rudolfstepan/6502-sbc-fpga/boards/tang_mega_138k/system16/linux/README.md

# System16 GoRV32 Plus Linux

This directory contains the software side of the hardware-verified Linux 6.12.95
port for the Tang Console 138K System16 project. Linux runs on hart 0 of the
Gowin GoRV32 Plus core; hart 1 remains parked in the ZSBL.

There are three deliberately separate profiles:

| Profile | Userspace/root | Board SD driver | Status |
| --- | --- | --- | --- |
| `flash` | embedded BusyBox initramfs | no | hardware verified |
| `rescue` | embedded BusyBox initramfs | read-only, auto-calibrating; isolated probe-time scratch test | read path hardware verified; CMD24 scratch test pending hardware verification |
| `sd` | 512 MiB ext2 at physical LBA 32768 | read-only, auto-calibrating | experimental external-root profile |

The SD image can contain GNU make, binutils and a native GCC, and that image is
covered by the QEMU test. The current hardware driver still exposes
`/dev/gorv32sd` read-only. Only the rescue DTB enables one tightly scoped
probe-time CMD24 test at physical LBA 16384; it does not enable block-device or
filesystem writes. The rescue profile deliberately omits ext2 support so it
cannot mount the card; the separate `sd` profile retains ext2. Do not describe
this profile as writable until the write path and filesystem integrity tests
pass.
The complete build procedure is in [linux-build-image.md](linux-build-image.md).
For adding a new MMIO peripheral, coprocessor or Linux platform driver, see
[hardware-treiber-entwicklung.md](hardware-treiber-entwicklung.md).

## PS/2 keyboard

The Linux FPGA build exposes a PS/2 Set-2 keyboard receiver at MMIO address
`0xe8800100`. Connect the keyboard through the Tang Console PMOD1 header:

| Signal | PMOD1 | FPGA pin |
| --- | --- | --- |
| PS/2 clock | `IO0` | `W19` |
| PS/2 data | `IO1` | `W20` |
| Keyboard supply | `+5V` | external 5 V |
| Ground | `GND` | common ground |

Clock and data are open-collector inputs with FPGA pull-ups to 3.3 V. Do not
apply a push-pull 5 V signal to either FPGA pin. A PS/2 socket or adapter must
power the keyboard from 5 V while keeping clock/data open-collector; use a
proper open-drain level shifter if the adapter contains active 5 V logic.

The hardware profiles compile a German QWERTZ, no-dead-keys map into the Linux
VT layer. This changes only PS/2/USB keyboard input on the HDMI `tty1`; bytes
received from a serial terminal retain that terminal's own layout. BusyBox runs
independent gettys on `tty1` and `ttyS0`. Kernel output is still mirrored to
both consoles, but interactive input no longer passes through `conspy`, whose
polling caused visible keyboard latency and interrupted UART sessions.
The text-console driver restores Linux's CP437 Unicode map when it takes over
from the boot console. The existing hardware font therefore renders
`ÄÖÜäöüß`, section and degree signs at their CP437 glyph positions; no separate
font ROM or bitstream update is required for these characters.

## USB CDC development link

The GoRV32 Plus FPGA project contains a full-speed USB CDC ACM device on the
Tang Console USB-C device connector. Windows enumerates the hardware proof as
`33aa:0121`, serial `CDC138K002`, and binds it to `usbser.sys` as a virtual COM
port. The standalone loopback project first verified the pins, SoftPHY,
descriptor path and endpoint-2 transfer independently of Linux.

The System16 integration exposes endpoint 2 as a polling MMIO byte stream at
`0xe8800300`. This is the first hardware-bring-up layer; it deliberately does
not connect an unverified PLIC interrupt and is not yet registered as a Linux
TTY. Both directions use 512-byte asynchronous FIFOs. USB OUT packets become
visible only after a valid CRC indication, and USB IN data is retained until
the controller confirms successful transmission. IN packets are limited to
63 bytes to avoid Windows `usbser` waiting on an exact multiple of the
64-byte maximum packet size.

| Offset | Name | Access | Meaning |
| ---: | --- | --- | --- |
| `0x00` | `ID` | RO | `0x53313655` (`S16U`) |
| `0x04` | `CAPS` | RO | ABI `1.0`, RX/TX FIFO size as log2 |
| `0x08` | `STATUS` | RO | online, suspend, modem, FIFO and sticky error bits |
| `0x0c` | `RX_DATA` | RO | read and remove one received byte; zero if empty |
| `0x10` | `TX_DATA` | WO | enqueue the low byte; full FIFO sets overflow |
| `0x14` | `RX_LEVEL` | RO | received bytes available |
| `0x18` | `TX_LEVEL` | RO | used in bits 15:0, free in bits 31:16 |
| `0x1c` | `IRQ_STATUS` | RO/W1C | polling-visible event flags |
| `0x20` | `IRQ_ENABLE` | RW | event enable bits; hardware IRQ not connected yet |
| `0x24` | `CONTROL` | W1P | flush RX/TX, clear errors/events, IRQ test |
| `0x28` | `LINE_BAUD` | RO | host-selected CDC baud value |
| `0x2c` | `LINE_FORMAT` | RO | data bits, parity and stop bits |
| `0x30` | `MODEM` | RO | DTR and RTS |

After programming the System16 bitstream and booting Linux, the non-destructive
identity checks are:

```sh
devmem 0xe8800300 32
devmem 0xe8800304 32
devmem 0xe8800308 32
```

The first two reads must return `0x53313655` and `0x01000909`. To test Linux to
PC, open the new COM port and enqueue the ASCII byte `A`:

```sh
devmem 0xe8800310 8 0x41
```

For PC to Linux, send one byte from the COM terminal, verify that STATUS bit 4
or `RX_LEVEL` is nonzero, then pop it exactly once:

```sh
devmem 0xe8800314 32
devmem 0xe880030c 8
```

## Hardware boot capture

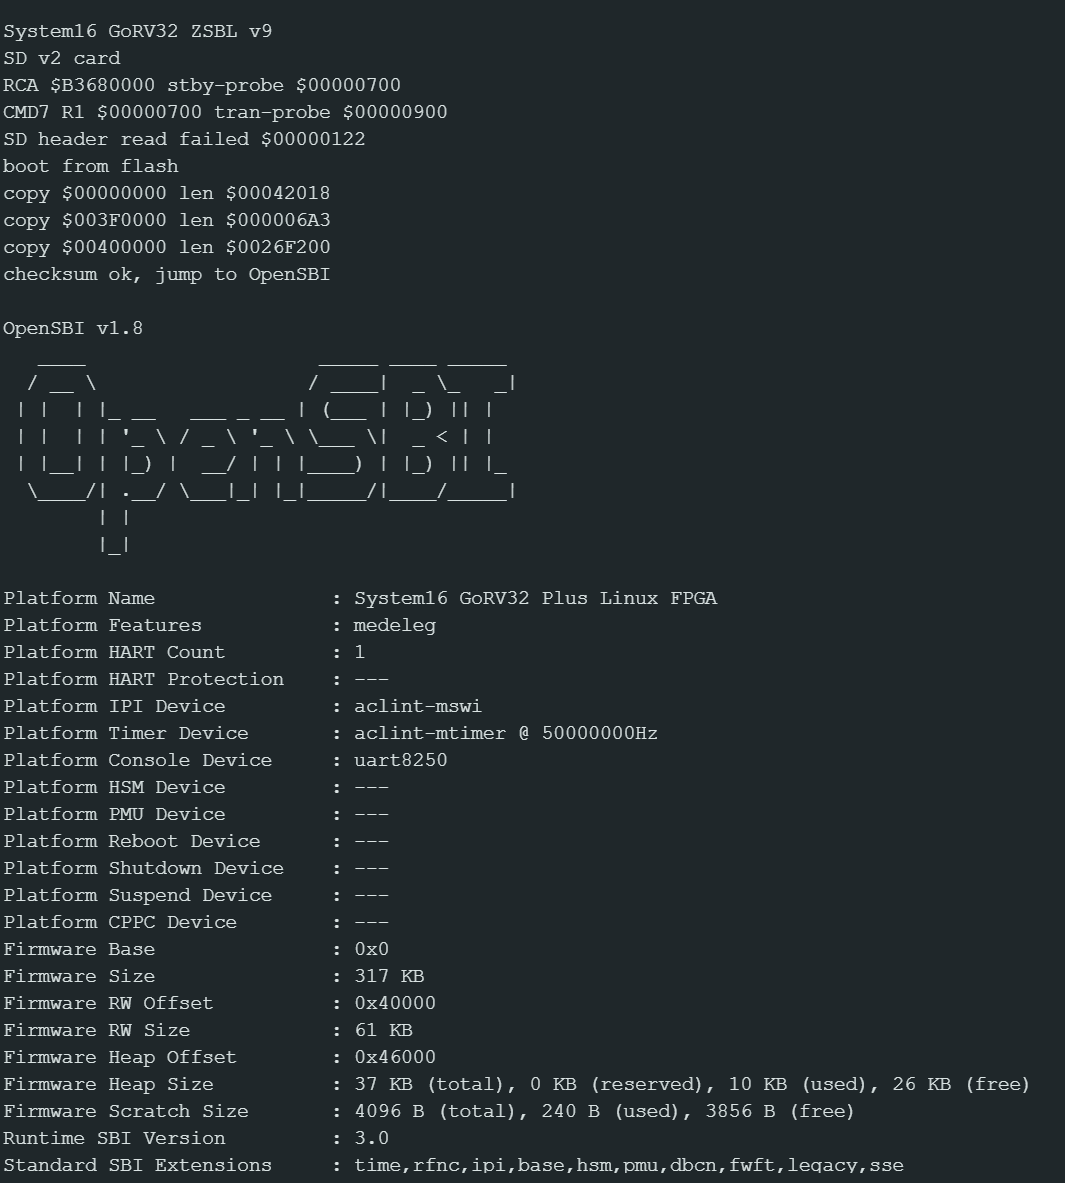
[picture p1: boards/tang_mega_138k/system16/linux/images/gorv32plus-opensbi-boot.png]
GoRV32 Plus ZSBL loading the GRV1 image from flash and starting OpenSBI


The capture shows the SD-first GRV1 copy layout and OpenSBI hand-off used by
the current ZSBL v12.

## Boot chain

1. The FPGA loads its bitstream from the board's 8 MB XT25F64B flash.
2. GoRV32 Plus resets at CPU address `0x80000000`. Its XIP window maps this
   address to flash offset `0x500000`, where the ZSBL executes in place.
3. ZSBL v12 initializes UART1 and first validates the GRV1 image at SD LBA 0.
   If the card or image is unavailable, it tries the fallback GRV1 container
   at flash offset `0x510000`.
4. The ZSBL copies OpenSBI, the DTB and Linux into SDRAM0, verifies the
   additive payload checksum and jumps to OpenSBI at address zero.
5. OpenSBI starts Linux at `0x00400000`. The `flash` and `rescue` profiles
   start their embedded BusyBox initramfs; the `sd` profile mounts
   `/dev/gorv32sd` read-only.

The GRV1 container is little-endian. It starts with a header containing the
magic, record count and checksum, followed by `(source offset, destination,
length)` records. Each payload begins on a 512-byte boundary so the SD path can
copy complete sectors directly into SDRAM. `tools/make_gorv32_flash_image.py`
is the authoritative format implementation.

## Address layout

| Space | Address | Contents |
| --- | ---: | --- |
| Flash | `0x000000` | FPGA bitstream, approximately 4.9 MB |
| Flash | `0x500000` | ZSBL; also the IP Core Generator `Flash_Burn_Address` |
| Flash | `0x510000` | Optional fallback GRV1 image |
| SD | LBA 0 | Primary raw GRV1 boot container |
| SD | LBA 16384 | Rescue-only CMD24 scratch sector in the unused gap |
| SD | LBA 32768 | SD profile's 512 MiB ext2 root filesystem |
| CPU XIP | `0x80000000` | ZSBL mapping of flash offset `0x500000` |
| SDRAM | `0x00000000` | OpenSBI (`FW_TEXT_START=0`) |
| SDRAM | `0x003f0000` | `gorv32plus.dtb` |
| SDRAM | `0x00400000` | Linux `Image`; initramfs in `flash`/`rescue` only |
| MMIO | `0xe4000000` | PLIC |
| MMIO | `0xe6000000` | CLINT |
| MMIO | `0xe8800100` | PS/2 keyboard registers |
| MMIO | `0xe8800300` | USB CDC endpoint-2 byte-stream registers |
| MMIO | `0xf0200020` | UART1 16550 register window |
| MMIO | `0xf0600000` | Vendor SD host |

Linux sees 1020 MiB from `0x00400000` through `0x3fffffff`. The lower 4 MiB
of the 1 GiB DDR3 are reserved for OpenSBI and the DTB. The optional flash
fallback slot has a stricter 2.9 MiB GRV1 size limit; SD boot is not restricted
by that flash boundary.

The UART uses 115200 baud, 8 data bits, no parity and one stop bit. Its APB
registers use 32-bit accesses and a four-byte stride. The small ZSBL SD reader
identifies cards at 200 kHz and transfers at 1 MHz, preferring four-bit
mode after ACMD6. This is independent of the Linux driver described below.

## Auto-calibrating Linux SD driver

`kernel/gorv32_sd.c` is a polling block driver for the vendor host at
`0xf0600000`. During probe it establishes a repeatable one-bit reference, then
tests all 50 combinations of one-/four-bit mode and dividers 0 through 24
(25 MHz down to 1 MHz). A candidate is rejected on a transfer failure, retry,
RX-FIFO-full event or byte mismatch. The three fastest short-run candidates
receive a 64-sector verification and the winner is checked once more before
the block device is registered. A later runtime retry or FIFO-full event halves
the clock automatically; runtime up-clocking is intentionally avoided.

Hardware result on 2026-07-12 with the current card and bitstream:

```text
auto calibration selected 1-bit divider 9 (2500000 Hz, 161 KiB/s); 29/50 sweep modes, 3 long-run modes passed
read benchmark: 16 sectors in 42 ms (190 KiB/s), 0 retries, 0 FIFO-full events
1048576 sectors at physical LBA 32768, 1-bit, native word order
```

The result is measured on every boot and is not hard-coded; another card can
select a different mode. Both board DTS files set `gowin,read-only`, so the
registered block device rejects writes. The rescue DTB additionally sets
`gowin,write-self-test-lba = <16384>`. At probe time the driver switches to
1-bit/1 MHz, reads the original sector and four sentinels twice, writes one test
pattern, reads it twice, restores the original with one CMD24, reads it twice
again and compares the sentinels. The sentinels are physical LBAs 0, 16383,
16385 and 32770. A CMD24 is never retried: a failed completion indication is
ambiguous, so the driver reinitializes and verifies instead of issuing the same
write again. Pass or fail, `/dev/gorv32sd` remains read-only.

## Source and generated files

- `gorv32plus.dts`, `gorv32plus-rescue.dts` and `gorv32plus-sd.dts` describe
  the three profiles.
- `system16-flash.config`, `system16-rescue.config` and `system16-sd.config`
  are their kernel fragments; `system16-qemu-sd.config` replaces the board
  host with virtio for the rootfs test.
- `kernel/gorv32_sd.c` is the built-in polling block driver for the SD profile.
- `build-kernel.sh` builds `flash`, `rescue`, `sd` or `qemu-sd` (`flash` is
  the default).
- `zsbl/crt.S`, `zsbl/main.c`, `zsbl/zsbl.lds` and `zsbl/build.sh` are the
  versioned freestanding XIP bootloader sources; `zsbl.bin` and `zsbl.elf` are
  generated from them and deliberately remain untracked.
- `../tools/build_rootfs_wsl.py` creates a static uClibc/BusyBox cpio with
  Buildroot 2025.02.
- `../tools/build_opensbi_gorv32_wsl.py` builds OpenSBI at address zero.
- `../tools/import_gorv32_from_wsl.py` validates and imports the WSL artifacts
  and compiles `gorv32plus.dts`.
- `../tools/build_rootfs_sd_wsl.py` creates the ext2/toolchain root filesystem.
- `buildroot/` is the versioned BR2_EXTERNAL tree for that filesystem.
- `../tools/make_gorv32_flash_image.py` creates a GRV1 boot container.
- `../tools/make_gorv32_sd_card_image.py` combines GRV1 and ext2.

Generated artifacts are intentionally not repository sources: Gowin `impl/`
output, `zsbl.bin`, `zsbl.elf`, the Linux build tree and `build/gorv32-linux-*`
can all be recreated. The Gowin IP's editable `.ipc` and synthesizable
encrypted `.v` are retained with the project, matching the policy used by the
other Gowin board ports.

## Build order

The Windows targets call the default WSL distribution. Commands below are run
from the repository root. Build the common boot firmware when it changes:

```powershell
make -C boards/tang_mega_138k/system16 gorv32-zsbl-wsl
make -C boards/tang_mega_138k/system16 gorv32-opensbi-wsl
```

The recommended driver-development loop is the rescue profile:

```powershell
make -C boards/tang_mega_138k/system16 rootfs-flash-wsl  # once
make -C boards/tang_mega_138k/system16 kernel-rescue-wsl
make -C boards/tang_mega_138k/system16 gorv32-rescue-image
```

Program only
`build/gorv32-linux-rescue/gorv32-linux-rescue.bin` at flash `0x510000` for
the normal fallback loop. The initramfs starts without SD, so a driver failure
cannot prevent access to the shell. No FPGA rebuild is needed.

For the CMD24 scratch test, however, SD-first selects a valid GRV1 at LBA 0
before the flash fallback. Therefore write the newly built rescue GRV1 raw at
SD LBA 0 as well. It is flash-sized and ends below LBA 8192; the scratch sector
at LBA 16384 and the ext2 root at LBA 32768 are outside that overlay. Before
CMD24, the driver also reads the actual GRV1 header twice and refuses the test
unless its canonical records leave the full 8192-sector guard. Perform
the first test only on a disposable or completely cloned card. Create a full
raw baseline after this deliberate rescue overlay, boot once, then read the
card again and compare the complete raw images byte-for-byte.

Provision the external-root card only for a new or changed root filesystem:

```powershell
make -C boards/tang_mega_138k/system16 rootfs-sd-wsl
make -C boards/tang_mega_138k/system16 kernel-sd-wsl
make -C boards/tang_mega_138k/system16 gorv32-sd-image
```

The SD root filesystem includes `/usr/bin/s16bench` for measuring the on-board
DDR3 main-memory backend. Its defaults use two 2 MiB buffers and eight passes;
Linux receives 1020 MiB (`0x00400000..0x3fffffff`) from the 1 GiB device:

```sh
s16bench
s16bench 1024 16       # optional: buffer size in KiB and pass count
```

It reports sequential write, read and `memcpy` throughput in KiB/s. Run the
same command after a memory-backend change and compare all three values.

This creates `build/gorv32-linux-sd/gorv32-linux-sd.img`. For later kernel,
DTB or driver iterations leave the card untouched and use:

```powershell
make -C boards/tang_mega_138k/system16 kernel-sd-wsl
make -C boards/tang_mega_138k/system16 gorv32-sd-boot-image
```

Write the resulting `gorv32-linux-sd-boot.bin` raw at SD LBA 0; this replaces
only the boot records before the ext2 filesystem. Use `qemu-sd-test` to
validate the Buildroot filesystem and native compiler through virtio; QEMU
does not exercise the Gowin SD host. See
[linux-build-image.md](linux-build-image.md) and
[gorv32-brennen.md](gorv32-brennen.md) for complete details.

## Expected console and diagnostics

The successful sequence starts with:

```text
FPGA BOOT OK
System16 GoRV32 ZSBL v12 SD-first
boot from SD
copy $00000000 len $...
copy $003F0000 len $...
copy $00400000 len $...
checksum ok, jump to OpenSBI
OpenSBI ...
[    0.000000] Linux version ...
[    0.000000] Machine model: System16 GoRV32 Plus Linux FPGA (rescue)
gorv32-sd f0600000.sdhost: auto calibration: testing ...
gorv32-sd f0600000.sdhost: auto calibration selected ...
gorv32-sd f0600000.sdhost: CMD24 scratch self-test at physical LBA 16384; root window stays read-only
gorv32-sd f0600000.sdhost: CMD24 scratch self-test PASS at physical LBA 16384; original restored
gorv32-sd f0600000.sdhost: read benchmark: ... 0 retries, 0 FIFO-full events
```

After initramfs startup, BusyBox supplies the minimal user space and shell.
`cat /sys/block/gorv32sd/ro` must print `1`; a PASS line does not authorize
general SD writes.
The HDMI top stripe is a coarse hardware diagnostic: red means no CPU UART or
DDR traffic, blue means DDR reads without UART, magenta means DDR writes
without UART, yellow means UART without DDR, cyan means UART plus reads, and
green means UART plus a DDR write. Green proves the chain through the ZSBL copy
loop, but the UART log remains the authoritative boot result.

## Known constraints

- Do not use flash offsets at or above `0x800000`: they exceed the physical
  8 MB device and can wrap over the bitstream.
- The GoRV32 Plus project must not include `VexRiscvSystem16.v`; the encrypted
  vendor core contains its own `VexRiscv` module.
- The vendor IP owns the QSPI and SD I/O buffers. Fabric logic must not also
  drive or probe those pads, or synthesis reports EX0339.
- OpenSBI 1.8.1 requires the local pre-MDT `fw_base.S` adjustment implemented
  by the build helper for this privilege-architecture implementation.
- The Linux SD device is read-only. CMD17 reads are hardware verified. The
  rescue-only LBA-16384 CMD24 save/test/restore sequence is an isolated
  integrity test; general writes and writable ext2/swap operation are not
  enabled.
- QEMU validates the generic RV32 kernel and early console, not the board's
  XIP, AXI-to-SDRAM bridge, SD host or UART wiring.
