rudolfstepan/6502-sbc-fpga/docs/03_BUILDING.md

# Building & Synthesis Guide

## System Requirements

### Software Dependencies

- **GHDL** (version 0.35+): VHDL simulator and analyzer
  - Windows: https://github.com/ghdl/ghdl/releases
  - Linux: `sudo apt-get install ghdl`
  - macOS: `brew install ghdl`

- **GNU Make**: Build automation
  - Windows: MinGW-w64 or equivalent
  - Linux/macOS: Usually pre-installed

- **Python 3.6+**: ROM conversion utility
  - Windows/Linux/macOS: https://www.python.org/downloads/

### FPGA Synthesis Tools (Optional)

For actual FPGA implementation, you'll need vendor tools:

- **Xilinx Vivado** (Xilinx FPGA targets)
- **Intel Quartus** (Intel Altera FPGA targets)
- **Lattice Diamond** (Lattice FPGA targets)
- **GowinEDA / GOWIN FPGA Designer** (Tang Primer 20K / GW2A targets; use the
  normal x64 install, for example `C:\Gowin\Gowin_V1.9.12.03_x64`)
- **Open Source**: Project Trellis, nextpnr (for open source flows)

## Building the Project

### Step 1: Install GHDL

**Windows**:
1. Download GHDL installer from GitHub releases
2. Run installer and follow prompts
3. Add GHDL to system PATH

**Linux**:
```bash
sudo apt-get install ghdl ghdl-mcode
```

**macOS**:
```bash
brew install ghdl
```

### Step 2: Verify Installation

```bash
ghdl --version
```

Should output something like:
```
GHDL 0.35 (tarball) [Dunoon edition]
```

### Step 3: Build the Project

Navigate to the FPGA directory:

```bash
cd fpga/
make test
```

This will:
1. Compile all VHDL modules
2. Elaborate testbenches
3. Run each test simulation
4. Report pass/fail status

### Detailed Build Steps

If you want to build individual components:

```bash
# Analyze only (check syntax)
ghdl -a --std=08 --ieee=synopsys rtl/sbc_pkg.vhd
ghdl -a --std=08 --ieee=synopsys rtl/bus_decode.vhd

# Elaborate (link)
ghdl -e --std=08 --ieee=synopsys tb_bus_decode

# Run simulation
ghdl -r --std=08 --ieee=synopsys tb_bus_decode --ieee-asserts=disable-at-0
```

## ROM Files

### ROM Conversion Tool

Convert binary ROM files to VHDL hex format:

```bash
python tools/bin_to_vhdl_hex.py [OPTIONS] [ROM_FILES]
```

### Options

```
--size SIZE          ROM size in bytes (hex, e.g., 0x4000)
--output FILE        Output hex file path
ROM_FILE[@OFFSET]    ROM file with optional offset
```

### Examples

**Single ROM file**:
```bash
python tools/bin_to_vhdl_hex.py --size 0x4000 \
  --output rom.hex \
  ../roms/chess.rom
```

**Multiple ROM files at different offsets**:
```bash
python tools/bin_to_vhdl_hex.py --size 0x4000 \
  --output rom.hex \
  ../roms/kernel.rom@0x0000 \
  ../roms/msbasic.rom@0x1000
```

**Kernel + EhBASIC system image**:
```bash
python tools/bin_to_vhdl_hex.py --size 0x4000 \
  --output rom.hex \
  ../roms/kernel.rom@0x0000 \
  ../roms/ehbasic.rom@0x1000
```

**Output format** (text file, space-separated):
```
0000 A9
0001 42
0002 8D
0003 02
0004 00
```

### ROM File Format Details

- **Input**: Raw binary files
- **Output**: Text format (offset byte, both hex)
- **Composition**: Multiple files combined at different offsets
- **Size**: Padded with 0xEA (NOP) up to specified size
- **Endianness**: Big-endian in output (matches 6502 reset vector convention)

## Makefile Targets

The project includes a Makefile with standard targets:

```bash
make test                  # Run all default SBC tests
make test-c64-vic          # Run focused native C64 VIC-II graphics tests
make test-c64-input        # Run PS/2 keyboard matrix + joystick input tests
make c64-graphics-test-prg # Build roms/test.prg for UART upload to the C64 core
make c64-sprite-test-prg   # Build roms/sprite_test.prg for sprite testing
make c64-sid-prgs          # Build RUN-loadable C64 SID PRGs in roms/c64/sid
make clean                 # Remove generated files
make help                  # Show available targets, if supported by your make
```

### Makefile Variables

Override variables when running make:

```bash
make test GHDL=/path/to/ghdl     # Specify GHDL path
make clean                        # Clean working directory
```

### Native C64 graphics PRG

The native C64 core has a small UART-uploadable graphics test. It builds a
standard C64 PRG with load address `$0801` and a BASIC `SYS 2064` stub:

```powershell
make c64-graphics-test-prg
python tools/c64_uart_prg_loader.py roms/test.prg --port COM15
```

The PRG loader first sends monitor wake sequence `A5 5A C3 3C`; the C64 board
top ignores all other received bytes while the monitor is idle. Normal C64 mode uses the
same CH340 link for the host-disk UART at `$DE00/$DE01`, so the old idle debug
stream is not driven on that line. Uploads are then paced for the monitor: the
current default streams 16 bytes per line with no artificial delay, which keeps
larger PRGs practical at the fixed 115200 baud. For stubborn boards or older
bitstreams, use `--safe` to return to one byte per line with a short delay, or
set `--wake-sequence "0xA5 0x5A 0xC3 0x3C" --bytes-per-line 1 --line-delay 0.001`
explicitly.

After upload, type `RUN` on the C64. The program cycles through text, hires
bitmap, multicolour bitmap, ECM text, and multicolour text; press any key for the
next screen.

For the focused sprite path:

```powershell
make c64-sprite-test-prg
python tools/c64_uart_prg_loader.py roms/sprite_test.prg --port COM15
```

After `RUN`, the PRG displays a moving hires sprite and static multicolour,
expanded, and X-MSB sprites. Sprite data lives at `$3000`, with pointers in the
screen matrix at `$07F8-$07FB`.

The same VIC-II renderer can be checked without hardware:

```powershell
make test-c64-vic
```

### Native C64 SID PRGs

The C64 core can also play SID tunes through UART-uploadable PRGs. Build every
convertible tune from `sid_orig/*.sid` with:

```powershell
make c64-sid-prgs
```

The generated files are written to `roms/c64/sid/`. Upload one with the C64
UART loader and start it from BASIC:

```powershell
python tools/c64_uart_prg_loader.py roms/c64/sid/Commando.prg --port COM15
```

```text
RUN
```

These PRGs are intentionally sound-only. Their wrapper clears `$D011.DEN` and
disables VIC raster IRQs before starting CIA Timer A as a roughly 50 Hz SID
player tick. In this core `DEN=0` also stops VIC RAM fetches, so the single-port
C64 RAM no longer stalls the CPU during playback and long SID players avoid
audible timing hiccups. See `roms/c64/sid/README.md` for details and known
conversion limits.

### Native C64 virtual 1541 transport

The Tang native-C64 top routes the C64 core's host-disk UART to the CH340 while
the FPGA monitor is inactive. The C64-side registers are:

| Address | Direction | Meaning |
| --- | --- | --- |
| `$DE00` | read/write | UART data byte; reading consumes the received byte |
| `$DE01` | read | bit 0 = RX byte available, bit 1 = TX busy, bit 2 = RX overflow |

Run the PC-side virtual drive server with a D64 folder:

```powershell
python tools/virtual_1541/c64_1541_uart_gui.py --port COM15 --folder E:\Emulatoren\C64\Games
```

The server already supports D64 mount/list/load/sector commands plus named
chunk reads over its binary packet protocol. The current single-PRG D64
extraction path is still the quickest way to start one-file games. For large
PC-to-C64 responses the server sends small paced chunks (default 8 bytes every
5 ms), and the C64 core has a 256-byte RX FIFO behind `$DE00`. That FIFO is
cleared while the FPGA monitor is active so PRG uploads cannot leave stale bytes
for the virtual-drive client.

Transport-only smoke test:

```powershell
make c64-v1541-ping-prg
python tools/c64_uart_prg_loader.py roms/c64/diag/v1541_ping.prg --port COM15
```

Close the upload tool, start `tools/virtual_1541/c64_1541_uart_gui.py` on the same COM port,
then type `RUN` on the C64. The PRG sends a binary `PING` over `$DE00/$DE01` and
prints the virtual-drive reply.

The `LOADFIRST` smoke loader verifies a complete D64 PRG transfer before the
KERNAL `LOAD` hook exists:

```powershell
make c64-v1541-loadfirst-prg
python tools/c64_uart_prg_loader.py roms/c64/diag/v1541_loadfirst.prg --port COM15
```

Close the upload tool, start the virtual 1541 server, mount/select a D64, and
type `RUN`. The loader runs from `$C000`, requests the first PRG from the mounted
disk, writes it to the PRG's own load address, and updates BASIC pointers for
normal `$0801` BASIC programs. It does not queue `RUN`, `SYS`, or alter the
loaded bytes; the PRG is placed at the load address stored in the file, like
`LOAD "",8,1`, then returns to READY. Start it manually afterwards if applicable.
Its temporary zero-page workspace is restored before returning to BASIC. Do not
use `LIST` as a game-loader test: many crack loaders keep binary data directly
behind the BASIC start line. `NO DISK MOUNTED` means the GUI is connected but no
D64 is mounted yet. This test needs a bitstream that includes the C64 UART RX
FIFO.
The GUI should log repeated `< LOADFIRSTCHUNK` / `> LOADFIRSTCHUNK status=...`
pairs while the C64 pulls the PRG in 128-byte blocks. This avoids one long
PC-to-C64 burst and keeps the transfer paced by the C64 RAM-copy loop.

To test normal KERNAL-style program loads and later KERNAL-based part loads,
first patch the KERNAL `LOAD` entry at `$FFD5` to the guarded virtual-1541 stub,
then regenerate the compiled-in C64 ROM VHDL:

```powershell
make c64-kernal-load-vector-patch
make c64-roms
```

The patch changes `$FFD5` from `JMP $F49E` to `JMP $ECB9`. The stub at `$ECB9`
checks whether the RAM hook is installed at `$C000` and jumps to `$C02C` only
when the hook guard byte is present; otherwise it falls back to the original
KERNAL `LOAD` routine at `$F49E`. This avoids the earlier READY hang where
KERNAL/BASIC restored `$0330/$0331` to `$F4A5` after a directory load.

After rebuilding and flashing the Tang C64 bitstream, install the RAM hook on
the FPGA C64. Start with the diagnostic variant:

```powershell
make c64-v1541-hook-diag-prg c64-v1541-hook-prg
python tools/c64_uart_prg_loader.py roms/c64/diag/v1541_hook_diag.prg --port COM15
```

Run the hook once on the C64. Then start the virtual 1541 server, mount a D64,
and use normal C64 commands:

```basic
LOAD"$",8
LIST
LOAD"*",8,1
RUN
```

The hook requests the named PRG in 128-byte `LOADCHUNK` blocks, honours the
embedded PRG load address for `,8,1`, and returns the end address in X/Y.
Custom fastloaders still bypass this path, and the temporary hook currently
lives at `$C000`.

See [Native C64 Virtual 1541 UART Technote](./C64_V1541_UART_TECHNOTE.md) for
the READY hang analysis, the guarded `$FFD5` stub, and the UART monitor probe
workflow.

## VHDL Compilation Flags

The project uses these GHDL flags:

```
--std=08            IEEE 1076-2008 standard (modern VHDL)
--ieee=synopsys     Enable Synopsys extensions (std_logic_unsigned, etc.)
```

The `--ieee=synopsys` flag is required for the T65 CPU core compatibility.

## Synthesis for FPGA

### General Flow

1. **RTL Preparation**
   ```bash
   # Copy all RTL files to synthesis project
   cp -r rtl/ /path/to/vivado/project/
   ```

2. **Testbench Integration** (optional)
   - Some vendors support RTL simulation
   - Use GHDL for pre-synthesis verification
   - Keep testbenches separate from synthesis

3. **Constraints File**
   - Check `constraints/` directory for board-specific files
   - Map port names to physical FPGA pins
   - Define timing constraints (clock period, setup/hold)

4. **Synthesis & Implementation**
   - Follow vendor-specific flow
   - Target block RAM for sram_i and rom_i
   - Ensure synchronous design constraints

5. **Timing Analysis**
   - Verify clock frequency meets requirements (50-100 MHz typical)
   - Check setup/hold margins
   - Ensure no critical timing paths

### Vendor-Specific Notes

**PIX16 Spartan-6 / Xilinx ISE**:
- Use the Xilinx ISE tools, not Vivado, for the Spartan-6 board.
- Create the SD-boot project from an ISE Command Prompt if `xtclsh` is not in PATH:
  ```bash
  cd fpga
  xtclsh scripts/create_sd_boot_ise_project.tcl
  ```
- Create the SD card image with:
  ```bash
  cd fpga
  make sd-boot-image
  ```
- Program the FPGA bitstream once, then update ROM contents by rewriting
  `sim/generated/sbc_ehbasic_sd.img` to the SD card.

**Tang Primer 20K / GowinEDA**:
- Open `fpga/boards/tang_primer_20k/sbc/project/tang_sbc.gprj` in GowinEDA.
- The active top is `tang20k_sbc_top`.
- The project targets `GW2A-18C` / `GW2A-LV18PG256C8/I7`, matching the Sipeed
  Tang Primer 20K examples.
- The current bring-up path uses HDMI boot/status output, CH340 UART at
  `115200 8N1`, KEY1 for the FPGA monitor, and the on-board microSD/SDIO slot
  in SPI mode on `N10/N11/R14/M8`.
- The SDIO slot uses dual-purpose pins. In `Project > Configuration`, enable the
  corresponding `SSPI` option so pins such as `sd_miso=M8` can be used as
  regular IO. The checked-in generated implementation config also enables `MSPI`,
  matching Sipeed's working example projects for the dock.
- If Gowin regenerates `impl/pnr/device.cfg` with `SSPI regular_io = false`, run
  this after Synthesis and before Place & Route:
  ```powershell
  powershell -ExecutionPolicy Bypass -File fpga/boards/tang_primer_20k/scripts/fix_gowin_dual_purpose.ps1
  ```
- If place-and-route reports stale object errors from
  `project/impl/gwsynthesis/tang_sbc.vg`, force a full resynthesis or clean the
  generated implementation directory. The `.vg` file is a generated netlist from
  the previous synthesis run.

**Xilinx Vivado**:
- Block RAM configured for:
  - Synchronous reads (default sync_ram mode)
  - Asynchronous reads (optional ASYNC_READ mode)
- Create IP core for ROM initialization from hex
- Use `INIT_FILE` generic to specify hex file path

**Intel Quartus**:
- Use ALTERA_RAM_EMBEDDED_FIFO primitive
- Configure with synchronous mode
- Use MIF (Memory Initialization File) format for ROM

**Lattice**:
- Use ECP5 or MachXO primitives
- Memory configuration differs by family
- Refer to Lattice design guides

## Troubleshooting

### GHDL Not Found

**Error**: `ghdl: command not found`

**Solution**:
1. Verify GHDL installation: `ghdl --version`
2. Check PATH environment variable includes GHDL bin directory
3. On Windows, ensure installer added to PATH during installation

### Compilation Errors

**Error**: `unknown option '-fsynopsys'`

**Solution**: Use `--ieee=synopsys` flag instead:
```bash
ghdl -a --std=08 --ieee=synopsys rtl/sbc_pkg.vhd
```

### ROM File Not Found

**Error**: `could not open ROM init file: sim/generated/chess_rom.hex`

**Solution**:
1. Verify ROM file exists: `ls -la sim/generated/`
2. Run ROM generation: `make test` (generates ROM files automatically)
3. Check file permissions

### Simulation Hangs

**Cause**: Unbounded loops, missing wait statements

**Solution**:
1. Set timeout in GHDL: `ghdl -r ... --stop-time=10ms`
2. Check for `wait;` without timeout in testbenches
3. Look for loops without `wait` statements inside

## Continuous Integration

### Local Testing

Run full test suite before committing:

```bash
cd fpga/
make test
```

All tests should PASS.

### GitHub Actions (Optional)

Create `.github/workflows/ghdl-test.yml`:

```yaml
name: GHDL Tests
on: [push, pull_request]
jobs:
  test:
    runs-on: ubuntu-latest
    steps:
      - uses: actions/checkout@v2
      - name: Install GHDL
        run: sudo apt-get install ghdl
      - name: Run tests
        run: cd fpga && make test
```

## Performance Tuning

### Simulation Speed

- **Synchronous reads**: Faster simulation (pipelined with CPU)
- **Asynchronous reads**: Slower but required for T65 core
- Reduce verbosity: Remove `report` statements in loops

### Synthesis Speed

- **Incremental build**: Reuse previous results when possible
- **Parallel compilation**: Use `-j` flag (if supported)
- **Block RAM optimization**: Vendor tools optimize automatically

## Memory Usage

### Simulation Memory

- GHDL uses ~100-200 MB for full system simulation
- Increase available memory if simulations crash
- Reduce stimulus size for memory-constrained systems

### FPGA Resources

Estimated resource usage:

| Resource | Count | Notes |
|---|---|---|
| Block RAM | 48KB | 32KB SRAM + 16KB ROM |
| LUTs | 5K-10K | CPU adapter + peripherals |
| Registers | 5K | State and data registers |
| Clock Freq | 50-100 MHz | Target frequency |

---

See Also:
- [Testing Guide](./04_TESTING.md) - Running individual tests
- [Architecture](./01_ARCHITECTURE.md) - System design
- [Development Guide](./07_DEVELOPMENT.md) - Contributing code
