rudolfstepan/6502-sbc-fpga/boards/tang_mega_138k/sbc/rtl/tang138k_sbc_top.vhd

-- Tang Mega 138K board top — 6502 SBC with HDMI output.
--
-- Clock: 50 MHz oscillator -> HDMI PLL outputs 50 MHz SBC system clock,
--   25 MHz pixel clock, and 125 MHz TMDS DDR bit clock.
--
-- Video: vic_vga runs VGA-compatible 640x480 timing and feeds Sipeed's DVI TMDS
--   transmitter over HDMI pins.
--
-- KEY[0] = T10 (dock S0, LVCMOS33, active-low reset button):
--                short press  -> CPU soft reset (restart program, keep ROM/boot)
--                long press >1s -> full board reset (re-run SD boot loader)
-- KEY[1] = T6  (PMOD0, LVCMOS33, active-low UART monitor enter / CPU hold).
--                The dock S1 button (T3) is unusable with DDR3 (T3 is in DDR
--                Bank 4 @ 1.5 V), so wire an external momentary button from the
--                T6 header pin to GND; the internal pull-up reads '1' otherwise.
-- LED[0]/LED[1] show boot status until boot_done, then LED[3:0] follow VIA PB[3:0].
library ieee;
use ieee.std_logic_1164.all;
use ieee.numeric_std.all;
use work.sbc_pkg.all;

entity tang138k_sbc_top is
  generic (
    BAUD          : positive := 115_200;
    -- true: wait for the first SD card and load EhBASIC + kernel into the
    -- shadow ROM at boot. Keeps the generated ROM package out of the bitstream.
    BOOT_FROM_SD  : boolean := true;
    -- true (default): include the on-board DDR3 framebuffer backend (Gowin DDR3
    --   IP + vic_fb_ddr3, same known-good bring-up as the c64_ddr project). It
    --   coexists with the SDRAM0 backend; $9007 bit 0 selects at runtime which
    --   one serves the fbw port, blitter and display fetch (DDR3 only becomes
    --   selectable once calibration completes -- boot never waits for it).
    -- false: no DDR3 hardware in the bitstream, SDRAM0 is the only backend.
    USE_DDR3      : boolean := true;
    -- true: use the Tang Console SDRAM0 connector as the SBC main-RAM backend.
    -- false: keep the internal BSRAM backend for safe bring-up.
    USE_SDRAM0    : boolean := false;
    -- true: use the external SDRAM0 connector for the no-DDR3 framebuffer/blitter
    -- path. Main RAM remains BSRAM when USE_SDRAM0=false.
    USE_SDRAM_FB  : boolean := true;
    -- USB HID is prepared but disabled by default until HDMI stability with the
    -- extra PLL/I/O is confirmed on hardware.
    USE_USB_HID   : boolean := false;
    -- Bring-up helper: run USB HID as an isolated top-level diagnostic source,
    -- without feeding keyboard bytes or IRQs into the SBC.
    USE_USB_DIAG  : boolean := false;
    -- false: use a 50 MHz fabric divider (~12.5 MHz) for diagnosis, avoiding a
    -- second Gowin PLL while checking whether USB I/O alone disturbs HDMI.
    USE_USB_PLL   : boolean := false;
    -- false: drop the HDMI debug-status overlay counters/muxes from synthesis.
    HDMI_DEBUG_OVERLAY : boolean := false
  );
  port (
    clk_50mhz  : in  std_logic;
    key        : in  std_logic_vector(1 downto 0);
    led        : out std_logic_vector(3 downto 0);
    uart_tx    : out std_logic;
    uart_rx    : in  std_logic;
    sd_dclk    : out std_logic;
    sd_ncs     : out std_logic;
    sd_mosi    : out std_logic;
    sd_miso    : in  std_logic;
    -- PS/2 keyboard on PMOD GPIO (fallback; USB HID is enabled for this board).
    ps2_clk    : in std_logic;
    ps2_data   : in std_logic;
    -- PT8211 audio DAC (dock board)
    dac_bck    : out std_logic;
    dac_ws     : out std_logic;
    dac_din    : out std_logic;
    pa_en      : out std_logic;   -- dock audio power-amplifier enable (active high)
    -- HDMI TMDS differential outputs
    tmds_clk_p : out std_logic;
    tmds_clk_n : out std_logic;
    tmds_d_p   : out std_logic_vector(2 downto 0);
    tmds_d_n   : out std_logic_vector(2 downto 0);
    dvi_a_psv  : out std_logic;
    dvi_a_hpd  : in  std_logic;
    dvi_ddc_clk: inout std_logic;
    dvi_ddc_dat: inout std_logic;

    -- Second SD card (data disk) on PMOD GPIO — directly SPI
    sd2_dclk    : out std_logic;
    sd2_ncs     : out std_logic;
    sd2_mosi    : out std_logic;
    sd2_miso    : in  std_logic;

    -- DDR3 SDRAM (on-board, 32-bit interface on Tang Mega 138K)
    ddr_addr    : out   std_logic_vector(14 downto 0);
    ddr_bank    : out   std_logic_vector(2 downto 0);
    ddr_cs      : out   std_logic;
    ddr_ras     : out   std_logic;
    ddr_cas     : out   std_logic;
    ddr_we      : out   std_logic;
    ddr_ck      : out   std_logic;
    ddr_ck_n    : out   std_logic;
    ddr_cke     : out   std_logic;
    ddr_odt     : out   std_logic;
    ddr_reset_n : out   std_logic;
    ddr_dm      : out   std_logic_vector(3 downto 0);
    ddr_dq      : inout std_logic_vector(31 downto 0);
    ddr_dqs     : inout std_logic_vector(3 downto 0);
    ddr_dqs_n   : inout std_logic_vector(3 downto 0);

    -- Tang Console external SDRAM0 connector (near the PCIe connector).
    sdram0_clk   : out   std_logic;
    sdram0_cs_n  : out   std_logic;
    sdram0_ras_n : out   std_logic;
    sdram0_cas_n : out   std_logic;
    sdram0_we_n  : out   std_logic;
    sdram0_ba    : out   std_logic_vector(1 downto 0);
    sdram0_addr  : out   std_logic_vector(12 downto 0);
    sdram0_dqm   : out   std_logic_vector(1 downto 0);
    sdram0_dq    : inout std_logic_vector(15 downto 0)
  );
end entity;

architecture rtl of tang138k_sbc_top is
  component sd_card_top
    generic (
      SPI_LOW_SPEED_DIV  : integer := 134;
      SPI_HIGH_SPEED_DIV : integer := 0
    );
    port (
      clk                    : in  std_logic;
      rst                    : in  std_logic;
      SD_nCS                 : out std_logic;
      SD_DCLK                : out std_logic;
      SD_MOSI                : out std_logic;
      SD_MISO                : in  std_logic;
      sd_init_done           : out std_logic;
      sd_sec_read            : in  std_logic;
      sd_sec_read_addr       : in  std_logic_vector(31 downto 0);
      sd_sec_read_data       : out data_t;
      sd_sec_read_data_valid : out std_logic;
      sd_sec_read_end        : out std_logic;
      sd_sec_write           : in  std_logic;
      sd_sec_write_addr      : in  std_logic_vector(31 downto 0);
      sd_sec_write_data      : in  data_t;
      sd_sec_write_data_req  : out std_logic;
      sd_sec_write_end       : out std_logic;
      debug_sec_state        : out std_logic_vector(4 downto 0);
      debug_cmd_state        : out std_logic_vector(3 downto 0);
      debug_cmd_error        : out std_logic
    );
  end component;

  component sd_rom_loader
    port (
      clk                    : in  std_logic;
      rst                    : in  std_logic;
      sd_init_done           : in  std_logic;
      sd_sec_read            : out std_logic;
      sd_sec_read_addr       : out std_logic_vector(31 downto 0);
      sd_sec_read_data       : in  data_t;
      sd_sec_read_data_valid : in  std_logic;
      sd_sec_read_end        : in  std_logic;
      rom_load_we            : out std_logic;
      rom_load_addr          : out std_logic_vector(13 downto 0);
      rom_load_data          : out data_t;
      boot_done              : out std_logic;
      boot_error             : out std_logic;
      dbg_state              : out std_logic_vector(3 downto 0)
    );
  end component;

  component rPLL is
    generic (
      FCLKIN         : string  := "100.0";
      DEVICE         : string  := "GW1N-1";
      IDIV_SEL       : integer := 0;
      FBDIV_SEL      : integer := 0;
      ODIV_SEL       : integer := 8;
      PSDA_SEL       : string  := "0000";
      DUTYDA_SEL     : string  := "1000";
      DYN_SDIV_SEL   : integer := 2;
      CLKFB_SEL      : string  := "internal";
      CLKOUT_BYPASS  : string  := "false";
      CLKOUTP_BYPASS : string  := "false";
      CLKOUTD_BYPASS : string  := "false";
      CLKOUTD_SRC    : string  := "CLKOUT"
    );
    port (
      CLKOUT  : out std_logic;
      LOCK    : out std_logic;
      CLKOUTP : out std_logic;
      CLKOUTD : out std_logic;
      RESET   : in  std_logic;
      RESET_P : in  std_logic;
      CLKIN   : in  std_logic;
      CLKFB   : in  std_logic;
      FBDSEL  : in  std_logic_vector(5 downto 0);
      IDSEL   : in  std_logic_vector(5 downto 0);
      ODSEL   : in  std_logic_vector(5 downto 0);
      PSDA    : in  std_logic_vector(3 downto 0);
      DUTYDA  : in  std_logic_vector(3 downto 0);
      FDLY    : in  std_logic_vector(3 downto 0)
    );
  end component;

  -- Gowin DDR3 memory-interface IP (generated; see project/src/ddr3_memory_interface)
  component DDR3_Memory_Interface_Top
    port (
      clk                 : in    std_logic;
      memory_clk          : in    std_logic;
      pll_lock            : in    std_logic;
      rst_n               : in    std_logic;
      cmd_ready           : out   std_logic;
      cmd                 : in    std_logic_vector(2 downto 0);
      cmd_en              : in    std_logic;
      addr                : in    std_logic_vector(28 downto 0);
      wr_data_rdy         : out   std_logic;
      wr_data             : in    std_logic_vector(255 downto 0);
      wr_data_en          : in    std_logic;
      wr_data_end         : in    std_logic;
      wr_data_mask        : in    std_logic_vector(31 downto 0);
      rd_data             : out   std_logic_vector(255 downto 0);
      rd_data_valid       : out   std_logic;
      rd_data_end         : out   std_logic;
      sr_req              : in    std_logic;
      ref_req             : in    std_logic;
      sr_ack              : out   std_logic;
      ref_ack             : out   std_logic;
      init_calib_complete : out   std_logic;
      clk_out             : out   std_logic;
      ddr_rst             : out   std_logic;
      burst               : in    std_logic;
      pll_stop            : out   std_logic;
      O_ddr_addr          : out   std_logic_vector(14 downto 0);
      O_ddr_ba            : out   std_logic_vector(2 downto 0);
      O_ddr_cs_n          : out   std_logic;
      O_ddr_ras_n         : out   std_logic;
      O_ddr_cas_n         : out   std_logic;
      O_ddr_we_n          : out   std_logic;
      O_ddr_clk           : out   std_logic;
      O_ddr_clk_n         : out   std_logic;
      O_ddr_cke           : out   std_logic;
      O_ddr_odt           : out   std_logic;
      O_ddr_reset_n       : out   std_logic;
      O_ddr_dqm           : out   std_logic_vector(3 downto 0);
      IO_ddr_dq           : inout std_logic_vector(31 downto 0);
      IO_ddr_dqs          : inout std_logic_vector(3 downto 0);
      IO_ddr_dqs_n        : inout std_logic_vector(3 downto 0)
    );
  end component;

  -- Generated GW5AST PLL wrapper for the DDR3 memory clock (50 MHz -> 400 MHz)
  component Gowin_DDR_PLL
    port (
      lock    : out std_logic;
      clkout0 : out std_logic;
      clkout1 : out std_logic;
      clkout2 : out std_logic;
      clkin   : in  std_logic;
      init_clk: in  std_logic;
      reset   : in  std_logic;
      enclk0  : in  std_logic;
      enclk1  : in  std_logic;
      enclk2  : in  std_logic
    );
  end component;

  -- Generated GW5AST PLL wrapper for low-speed USB HID (50 MHz -> 12 MHz).
  component Gowin_USB_PLL
    port (
      clkout0 : out std_logic;
      clkin   : in  std_logic
    );
  end component;

  signal clk_sys      : std_logic;   -- 50 MHz from HDMI clock tree
  signal clk_pix      : std_logic;   -- 25 MHz HDMI pixel clock
  signal usb_clk_12   : std_logic;   -- 12 MHz for nand2mario low-speed USB
  signal usb_clk_div   : std_logic := '0';
  signal usb_div_cnt   : unsigned(1 downto 0) := (others => '0');
  -- USB bring-up is kept internal until the Tang Console USB pins are proven
  -- safe with HDMI; this avoids synthesising active pads on H13/G13.
  signal usb_dm       : std_logic := 'Z';
  signal usb_dp       : std_logic := 'Z';
  signal pll_lock     : std_logic;
  signal reset_n      : std_logic;
  signal rst          : std_logic;
  -- key(0) reset button: short press = CPU soft reset, long press = full board
  -- reset. Debounced and synchronised in the clk_sys domain.
  constant DB_MAX     : integer := 250_000;     -- ~5 ms debounce  @ 50 MHz
  constant LONG_MAX   : integer := 50_000_000;  -- ~1 s  long-press @ 50 MHz
  signal key0_sync    : std_logic_vector(2 downto 0) := (others => '1');
  signal key0_db      : std_logic := '1';        -- debounced level (1 = released)
  signal db_cnt       : integer range 0 to DB_MAX := 0;
  signal press_cnt    : integer range 0 to LONG_MAX := 0;
  signal soft_reset   : std_logic := '0';        -- CPU-only reset (short press)
  signal long_reset   : std_logic := '0';        -- full board reset (long press)
  signal uart_tx_data : data_t;
  signal uart_tx_valid: std_logic;
  signal uart_tx_busy : std_logic;
  signal uart_mux_data  : data_t;
  signal uart_mux_valid : std_logic;
  signal via_portb    : data_t;
  signal vga_r        : std_logic_vector(4 downto 0);
  signal vga_g        : std_logic_vector(5 downto 0);
  signal vga_b        : std_logic_vector(4 downto 0);
  signal vga_hs       : std_logic;
  signal vga_vs       : std_logic;
  signal vga_de       : std_logic;
  signal vga_mux_r    : std_logic_vector(4 downto 0);
  signal vga_mux_g    : std_logic_vector(5 downto 0);
  signal vga_mux_b    : std_logic_vector(4 downto 0);
  signal vga_mux_hs   : std_logic;
  signal vga_mux_vs   : std_logic;
  signal vga_mux_de   : std_logic;
  signal sbc_vga_r    : std_logic_vector(4 downto 0);
  signal sbc_vga_g    : std_logic_vector(5 downto 0);
  signal sbc_vga_b    : std_logic_vector(4 downto 0);
  signal sbc_vga_hs   : std_logic;
  signal sbc_vga_vs   : std_logic;
  signal sbc_vga_de   : std_logic;
  signal boot_vga_r   : std_logic_vector(4 downto 0);
  signal boot_vga_g   : std_logic_vector(5 downto 0);
  signal boot_vga_b   : std_logic_vector(4 downto 0);
  signal boot_vga_hs  : std_logic;
  signal boot_vga_vs  : std_logic;
  signal boot_vga_de  : std_logic;
  signal boot_vga_active : std_logic;
  signal sd_init_done       : std_logic;
  signal sd_sec_read        : std_logic;
  signal sd_sec_read_addr   : std_logic_vector(31 downto 0);
  signal sd_sec_read_data   : data_t;
  signal sd_sec_read_valid  : std_logic;
  signal sd_sec_read_end    : std_logic;
  signal sd_sec_state       : std_logic_vector(4 downto 0);
  signal sd_cmd_state       : std_logic_vector(3 downto 0);
  signal sd_cmd_error       : std_logic;
  signal sd_ncs_i           : std_logic;
  signal sd_dclk_i          : std_logic;
  signal sd_mosi_i          : std_logic;
  signal rom_load_we        : std_logic;
  signal rom_load_addr      : std_logic_vector(13 downto 0);
  signal rom_load_data      : data_t;
  signal sd_rom_load_we     : std_logic;
  signal sd_rom_load_addr   : std_logic_vector(13 downto 0);
  signal sd_rom_load_data   : data_t;
  signal boot_done          : std_logic;
  signal sd_boot_done       : std_logic;
  signal boot_error         : std_logic;
  signal loader_state       : std_logic_vector(3 downto 0);
  signal boot_dbg_data      : data_t;
  signal boot_dbg_valid     : std_logic;
  signal boot_dbg_active    : std_logic;
  signal monitor_rx_data    : data_t;
  signal monitor_rx_valid   : std_logic;
  signal monitor_tx_data    : data_t;
  signal monitor_tx_valid   : std_logic;
  signal monitor_active     : std_logic;
  signal monitor_button     : std_logic;
  signal monitor_mem_req    : std_logic;
  signal monitor_mem_we     : std_logic;
  signal monitor_mem_addr   : addr_t;
  signal monitor_mem_wdata  : data_t;
  signal monitor_mem_rdata  : data_t;
  signal monitor_mem_ready  : std_logic;
  signal monitor_jump_req   : std_logic;
  signal monitor_jump_addr  : addr_t;

  -- Four-byte magic wake sequence (same as the C64 board): a soft monitor button
  -- over UART, so no physical key is needed. Longer than one byte because the
  -- same UART also carries the CPU's own byte traffic. Sending A5 5A C3 3C enters
  -- the PRG upload monitor; the physical key(1) still works too.
  constant MONITOR_MAGIC0 : std_logic_vector(7 downto 0) := x"A5";
  constant MONITOR_MAGIC1 : std_logic_vector(7 downto 0) := x"5A";
  constant MONITOR_MAGIC2 : std_logic_vector(7 downto 0) := x"C3";
  constant MONITOR_MAGIC3 : std_logic_vector(7 downto 0) := x"3C";
  signal mon_magic_idx  : integer range 0 to 3 := 0;
  signal mon_magic_enter : std_logic := '0';
  signal mon_enter      : std_logic;
  signal sd_seen_read_end   : std_logic := '0';

  -- Second SD card (data disk) signals
  signal sd2_init_done       : std_logic;
  signal sd2_sec_read        : std_logic;
  signal sd2_sec_read_addr   : std_logic_vector(31 downto 0);
  signal sd2_sec_read_data   : data_t;
  signal sd2_sec_read_valid  : std_logic;
  signal sd2_sec_read_end    : std_logic;
  signal sd2_sec_write       : std_logic;
  signal sd2_sec_write_addr  : std_logic_vector(31 downto 0);
  signal sd2_sec_write_data  : data_t;
  signal sd2_sec_write_req   : std_logic;
  signal sd2_sec_write_end   : std_logic;
  signal sd2_ncs_i           : std_logic;
  signal sd2_dclk_i          : std_logic;
  signal sd2_mosi_i          : std_logic;

  signal usb_connected      : std_logic;
  signal usb_keycode        : std_logic_vector(7 downto 0);
  signal usb_modif          : std_logic_vector(7 downto 0);
  signal usb_ascii          : std_logic_vector(7 downto 0);
  signal usb_phase          : std_logic_vector(3 downto 0);
  signal usb_key_event      : std_logic;
  signal usb_polling        : std_logic;
  signal usb_dbg_connected  : std_logic := '0';
  signal usb_dbg_keycode    : std_logic_vector(7 downto 0) := (others => '0');
  signal usb_dbg_modif      : std_logic_vector(7 downto 0) := (others => '0');
  signal usb_dbg_ascii      : std_logic_vector(7 downto 0) := (others => '0');
  signal usb_dbg_phase      : std_logic_vector(3 downto 0) := (others => '0');
  signal usb_dbg_key_event  : std_logic := '0';
  signal usb_dbg_polling    : std_logic := '0';
  signal usb_dbg_irq        : std_logic := '0';
  signal usb_dbg_dout       : data_t;
  signal usb_cap_addr       : std_logic_vector(6 downto 0);
  signal usb_cap_data       : std_logic_vector(15 downto 0);
  signal usb_cap_ready      : std_logic;

  -- Optional main-RAM backends. Both present the same byte req/ack interface to
  -- the SBC core; static generate removes the unused backend during synthesis.
  signal ddr_memory_clk     : std_logic;
  signal ddr_pll_lock       : std_logic;
  signal ddr_pll_stop       : std_logic;
  signal ddr_clk_x1         : std_logic;   -- 100 MHz DDR3 user clock
  signal ddr_calib_complete : std_logic;
  signal ddr_calib_sys_sync : std_logic_vector(2 downto 0) := (others => '0');
  signal ddr_calib_sys      : std_logic := '0';
  signal app_cmd            : std_logic_vector(2 downto 0);
  signal app_cmd_en         : std_logic;
  signal app_cmd_rdy        : std_logic;
  signal app_addr27         : std_logic_vector(26 downto 0);
  signal app_addr29         : std_logic_vector(28 downto 0);
  -- DDR3 controller reset + calibration auto-retry (sequenced on clk_50mhz, the
  -- IP's own reference clock -- no PLL-derived fabric clock is loaded).
  constant DDR_RST_HOLD     : integer := 1023;        -- reset assert width (~20 us @ 50 MHz)
  -- Calibration timeout before an automatic retry. The 20K value (540_000 @
  -- 27 MHz = 20 ms) was silently halved to 10.8 ms by the 50 MHz port, which
  -- can abort a calibration that is still in progress; 50 ms is comfortably
  -- above any observed GW5A calibration time and retries still fire on real
  -- hangs.
  constant DDR_CAL_WAIT     : integer := 2_500_000;   -- calibration timeout (~50 ms @ 50 MHz)
  type ddr_rst_state_t is (DR_ASSERT, DR_WAIT_CAL);
  signal ddr_rst_state      : ddr_rst_state_t := DR_ASSERT;
  signal ddr_rst_n          : std_logic := '0';       -- DDR3 controller reset
  signal ddr_lock_sync      : std_logic_vector(1 downto 0) := (others => '0');
  signal ddr_cal_sync       : std_logic_vector(1 downto 0) := (others => '0');
  signal long_reset_27_sync : std_logic_vector(2 downto 0) := (others => '0');
  signal long_reset_27      : std_logic := '0';
  signal ddr_rst_cnt        : integer range 0 to DDR_CAL_WAIT := 0;
  signal ddr_retry_tog      : std_logic := '0';       -- flips on every calib retry
  -- The reusable framebuffer controller still uses the 20K-style 128-bit app
  -- beat. The 138K DDR3 IP is 32-bit wide and exposes 256-bit app beats; the
  -- upper half is masked off here.
  signal app_wren           : std_logic;
  signal app_wdata          : std_logic_vector(127 downto 0);
  signal app_wdata_end      : std_logic;
  signal app_wdata_mask     : std_logic_vector(15 downto 0);
  signal app_wdata_rdy      : std_logic;
  signal app_rdata          : std_logic_vector(127 downto 0);
  signal app_rdata_valid    : std_logic;
  signal app_wdata256       : std_logic_vector(255 downto 0);
  signal app_wmask32        : std_logic_vector(31 downto 0);
  signal app_rdata256       : std_logic_vector(255 downto 0);
  -- core <-> bridge byte port
  signal sram_ext_req   : std_logic;
  signal sram_ext_we    : std_logic;
  signal sram_ext_addr  : std_logic_vector(14 downto 0);
  signal sram_ext_din   : data_t;
  signal sram_ext_dout  : data_t;
  signal sram_ext_ack   : std_logic;
  signal ram_ready      : std_logic;
  signal sdram0_cke_unused : std_logic;
  -- self-test status (to boot screen)
  signal ram_test_active    : std_logic;
  signal ram_test_done      : std_logic;
  signal ram_test_error     : std_logic;
  signal ram_test_phase     : std_logic_vector(3 downto 0);
  signal ram_test_addr      : std_logic_vector(14 downto 0);
  signal ram_test_fail_addr : std_logic_vector(14 downto 0);
  signal ram_test_expected  : data_t;
  signal ram_test_actual    : data_t;
  signal sbc_boot_done      : std_logic;
  signal dbg_cpu_addr       : addr_t;
  signal dbg_cpu_data       : data_t;
  signal dbg_cpu_din        : data_t;
  signal dbg_cpu_we         : std_logic;
  signal dbg_cpu_sync       : std_logic;
  signal debug_bus          : std_logic_vector(15 downto 0);
  signal clk_heartbeat      : unsigned(25 downto 0) := (others => '0');
  signal cpu_sync_counter   : unsigned(23 downto 0) := (others => '0');
  signal vga_rgb_nonzero    : std_logic;

  -- DDR3 framebuffer (vic_fb_ddr3): CPU pixel-byte req/ack port + video stream.
  -- 18-bit pixel index + 11-bit read address cover the 640x400 hi-res frame.
  signal fbw_req        : std_logic;
  signal fbw_we         : std_logic;
  signal fbw_addr       : std_logic_vector(17 downto 0);
  signal fbw_din        : data_t;
  signal fbw_dout       : data_t;
  signal fbw_ack        : std_logic;
  signal fb_hires       : std_logic;
  signal fb_true        : std_logic;
  signal fb_frame_start : std_logic;
  signal fb_line_adv    : std_logic;
  signal fb_rdaddr      : std_logic_vector(10 downto 0);
  signal fb_rddata      : std_logic_vector(15 downto 0);
  signal sdram_fb_ready : std_logic;
  -- hardware 2D blitter command wiring (core top -> vic_fb_ddr3)
  signal blit_op    : std_logic_vector(2 downto 0);
  signal blit_x0    : unsigned(9 downto 0);
  signal blit_y0    : unsigned(9 downto 0);
  signal blit_x1    : unsigned(9 downto 0);
  signal blit_y1    : unsigned(9 downto 0);
  signal blit_color : std_logic_vector(7 downto 0);
  signal blit_page  : std_logic;
  signal blit_gap   : std_logic_vector(7 downto 0);
  signal blit_dstx  : unsigned(9 downto 0);
  signal blit_dsty  : unsigned(9 downto 0);
  signal blit_tex_base  : unsigned(17 downto 0);
  signal blit_tex_u0    : signed(15 downto 0);
  signal blit_tex_v0    : signed(15 downto 0);
  signal blit_tex_dudx  : signed(15 downto 0);
  signal blit_tex_dvdx  : signed(15 downto 0);
  signal blit_tex_dudy  : signed(15 downto 0);
  signal blit_tex_dvdy  : signed(15 downto 0);
  signal blit_tex_flags : std_logic_vector(7 downto 0);
  signal blit_start : std_logic;
  signal blit_busy  : std_logic;

  -- Runtime framebuffer backend mux: vic_fb_ddr3 (DDR3) and sdram_fb (SDRAM0)
  -- both stay in the bitstream; the core's $9007 bit 0 picks which one serves
  -- the fbw port, the blitter and the display fetch. The display pulses
  -- (frame_start/line_adv/rdaddr) are broadcast to both so a switch takes
  -- effect within a frame.
  signal fb_use_ddr3     : std_logic;   -- effective select from the core
  signal fb_sel_eff      : std_logic;
  signal fb_boot_ready   : std_logic;
  signal ddr_cpu_req     : std_logic;
  signal ddr_blit_start  : std_logic;
  signal ddr_fbw_dout    : data_t;
  signal ddr_fbw_ack     : std_logic;
  signal ddr_fb_rddata   : std_logic_vector(15 downto 0);
  signal ddr_blit_busy   : std_logic;
  signal sdfb_cpu_req    : std_logic;
  signal sdfb_blit_start : std_logic;
  signal sdfb_fbw_dout   : data_t;
  signal sdfb_fbw_ack    : std_logic;
  signal sdfb_rddata     : std_logic_vector(15 downto 0);
  signal sdfb_blit_busy  : std_logic;
begin
  -- Tang Console HDMI side-band pins. The standalone color-bar test works with
  -- power-save held low and DDC released; keep the SBC electrically identical.
  dvi_a_psv   <= '0';
  dvi_ddc_clk <= 'Z';
  dvi_ddc_dat <= 'Z';

  -- key(0) is the reset button: a short press soft-resets only the CPU (the
  -- running program restarts via its reset vector, ROM/boot/SRAM kept), a long
  -- press (>1 s) asserts a full board reset. Debounced/synchronised on clk_sys,
  -- which stays alive because the HDMI PLL is no longer gated by the button.
  key_reset_proc : process(clk_sys)
  begin
    if rising_edge(clk_sys) then
      if pll_lock = '0' then
        key0_sync  <= (others => '1');
        key0_db    <= '1';
        db_cnt     <= 0;
        press_cnt  <= 0;
        soft_reset <= '0';
        long_reset <= '0';
      else
        key0_sync <= key0_sync(1 downto 0) & key(0);
        -- debounce: the synchronised level must hold steady DB_MAX cycles
        if key0_sync(2) = key0_db then
          db_cnt <= 0;
        elsif db_cnt = DB_MAX then
          key0_db <= key0_sync(2);
          db_cnt  <= 0;
        else
          db_cnt <= db_cnt + 1;
        end if;
        -- press duration: short -> soft_reset (CPU only), held >1 s -> full reset
        if key0_db = '0' then            -- pressed (active low)
          soft_reset <= '1';
          if press_cnt = LONG_MAX then
            long_reset <= '1';
          else
            press_cnt <= press_cnt + 1;
          end if;
        else                             -- released
          soft_reset <= '0';
          long_reset <= '0';
          press_cnt  <= 0;
        end if;
      end if;
    end if;
  end process;

  -- Full board reset on long press; also held until the PLL locks at power-on.
  reset_n <= (not long_reset) and pll_lock;
  rst <= not reset_n;
  monitor_button <= not key(1);
  -- Monitor enters on the UART magic sequence or the physical key.
  mon_enter <= mon_magic_enter or monitor_button;
  pa_en <= '0';  -- test build: audio disabled, keep dock PA muted
  sd_ncs <= sd_ncs_i;
  sd_dclk <= sd_dclk_i;
  sd_mosi <= sd_mosi_i;
  -- Test build: remove the second SD-card reader to free LUTs/placement.
  sd2_ncs <= '1';
  sd2_dclk <= '0';
  sd2_mosi <= '1';
  sd2_init_done <= '0';
  sd2_sec_read_data <= (others => '0');
  sd2_sec_read_valid <= '0';
  sd2_sec_read_end <= '0';
  sd2_sec_write_req <= '0';
  sd2_sec_write_end <= '0';
  -- Synchronise DDR3 calibration into clk_sys before it gates the SBC reset.
  -- The raw IP signal is still used in the DDR app-clock framebuffer controller.
  ddr_calib_sys <= ddr_calib_sys_sync(2);

  process(clk_sys)
  begin
    if rising_edge(clk_sys) then
      if reset_n = '0' then
        ddr_calib_sys_sync <= (others => '0');
      else
        ddr_calib_sys_sync <= ddr_calib_sys_sync(1 downto 0) & ddr_calib_complete;
      end if;
    end if;
  end process;

  boot_done     <= sd_boot_done when BOOT_FROM_SD else '1';
  rom_load_we   <= sd_rom_load_we when BOOT_FROM_SD else '0';
  rom_load_addr <= sd_rom_load_addr when BOOT_FROM_SD else (others => '0');
  rom_load_data <= sd_rom_load_data when BOOT_FROM_SD else (others => '0');

  -- Hold the CPU until the ROM image, the main-RAM backend AND the default
  -- framebuffer backend (SDRAM0) are ready. The DDR3 backend calibrates in the
  -- background (auto-retry sequencer below) and only becomes selectable through
  -- $9007 once ddr_calib_sys is high -- a failed DDR3 calibration can no longer
  -- keep the CPU parked.
  fb_boot_ready <= sdram_fb_ready when USE_SDRAM_FB else
                   ddr_calib_sys  when USE_DDR3 else
                   '1';
  sbc_boot_done <= boot_done and ram_ready and fb_boot_ready;

  -- ── Runtime framebuffer backend mux ────────────────────────────────────────
  -- fb_use_ddr3 comes from the core already gated by ddr_calib_sys ($9007 bit 0
  -- AND DDR3 ready); a DDR3-only build forces the DDR3 side.
  fb_sel_eff <= fb_use_ddr3 when USE_SDRAM_FB else
                '1'         when USE_DDR3 else
                '0';

  ddr_cpu_req     <= fbw_req    and fb_sel_eff;
  ddr_blit_start  <= blit_start and fb_sel_eff;
  sdfb_cpu_req    <= fbw_req    and not fb_sel_eff;
  sdfb_blit_start <= blit_start and not fb_sel_eff;

  fbw_ack   <= ddr_fbw_ack   when fb_sel_eff = '1' else sdfb_fbw_ack;
  fbw_dout  <= ddr_fbw_dout  when fb_sel_eff = '1' else sdfb_fbw_dout;
  fb_rddata <= ddr_fb_rddata when fb_sel_eff = '1' else sdfb_rddata;
  blit_busy <= ddr_blit_busy when fb_sel_eff = '1' else sdfb_blit_busy;

  -- Keep boot failures visible instead of presenting a valid but black HDMI
  -- image while the CPU is parked. Both renderers use the same 640x480 timing.
  boot_vga_active <= not sbc_boot_done;
  vga_mux_r  <= boot_vga_r  when boot_vga_active = '1' else sbc_vga_r;
  vga_mux_g  <= boot_vga_g  when boot_vga_active = '1' else sbc_vga_g;
  vga_mux_b  <= boot_vga_b  when boot_vga_active = '1' else sbc_vga_b;
  vga_mux_hs <= boot_vga_hs when boot_vga_active = '1' else sbc_vga_hs;
  vga_mux_vs <= boot_vga_vs when boot_vga_active = '1' else sbc_vga_vs;
  vga_mux_de <= boot_vga_de when boot_vga_active = '1' else sbc_vga_de;

  vga_rgb_nonzero <= '1' when sbc_vga_r /= "00000" or
                             sbc_vga_g /= "000000" or
                             sbc_vga_b /= "00000" else '0';

  debug_counter_proc : process(clk_sys)
  begin
    if rising_edge(clk_sys) then
      clk_heartbeat <= clk_heartbeat + 1;
      if reset_n = '0' then
        cpu_sync_counter <= (others => '0');
      elsif dbg_cpu_sync = '1' then
        cpu_sync_counter <= cpu_sync_counter + 1;
      end if;
    end if;
  end process;

  -- Status bits for the HDMI debug overlay (tang138k_hdmi_tx renders them as
  -- 16 squares in the top border, bit 0 leftmost, green = 1):
  --   0 HDMI-PLL lock      4 DDR3 calibrated       8  DDR PLL trimmed+locked
  --   1 reset_n            5 CPU released          9  DDR3 IP reset released
  --   2 SD boot done       6 DDR3 backend ACTIVE   10 flips per calib RETRY
  --   3 main RAM ready     7 SDRAM0 FB ready       11 IP pll_stop (clk enable)
  --                                                12..14 USB, 15 heartbeat
  debug_bus(0)  <= pll_lock;
  debug_bus(1)  <= reset_n;
  debug_bus(2)  <= boot_done;
  debug_bus(3)  <= ram_ready;
  debug_bus(4)  <= ddr_calib_sys;
  debug_bus(5)  <= sbc_boot_done;
  debug_bus(6)  <= fb_sel_eff;
  debug_bus(7)  <= sdram_fb_ready;
  debug_bus(8)  <= ddr_pll_lock;
  debug_bus(9)  <= ddr_rst_n;
  debug_bus(10) <= ddr_retry_tog;
  debug_bus(11) <= ddr_pll_stop;
  debug_bus(12) <= usb_dbg_phase(2);
  debug_bus(13) <= usb_dbg_phase(3);
  debug_bus(14) <= '1' when usb_dbg_ascii /= x"00" else '0';
  debug_bus(15) <= clk_heartbeat(24);

  -- Register the complete renderer output together before the related-clock
  -- handoff in tang138k_hdmi_tx. This removes long combinational 50->25 MHz
  -- paths while preserving RGB/sync/data-enable alignment.
  process(clk_sys)
  begin
    if rising_edge(clk_sys) then
      if reset_n = '0' then
        vga_r  <= (others => '0');
        vga_g  <= (others => '0');
        vga_b  <= (others => '0');
        vga_hs <= '1';
        vga_vs <= '1';
        vga_de <= '0';
      else
        vga_r  <= vga_mux_r;
        vga_g  <= vga_mux_g;
        vga_b  <= vga_mux_b;
        vga_hs <= vga_mux_hs;
        vga_vs <= vga_mux_vs;
        vga_de <= vga_mux_de;
      end if;
    end if;
  end process;

  process(clk_sys)
  begin
    if rising_edge(clk_sys) then
      if reset_n = '0' then
        sd_seen_read_end <= '0';
      elsif sd_sec_read_end = '1' then
        sd_seen_read_end <= '1';
      end if;
    end if;
  end process;

  sd_i : sd_card_top
    generic map (
      SPI_LOW_SPEED_DIV  => 268,
      SPI_HIGH_SPEED_DIV => 2
    )
    port map (
      clk                    => clk_sys,
      rst                    => rst,
      SD_nCS                 => sd_ncs_i,
      SD_DCLK                => sd_dclk_i,
      SD_MOSI                => sd_mosi_i,
      SD_MISO                => sd_miso,
      sd_init_done           => sd_init_done,
      sd_sec_read            => sd_sec_read,
      sd_sec_read_addr       => sd_sec_read_addr,
      sd_sec_read_data       => sd_sec_read_data,
      sd_sec_read_data_valid => sd_sec_read_valid,
      sd_sec_read_end        => sd_sec_read_end,
      sd_sec_write           => '0',
      sd_sec_write_addr      => (others => '0'),
      sd_sec_write_data      => (others => '0'),
      sd_sec_write_data_req  => open,
      sd_sec_write_end       => open,
      debug_sec_state        => sd_sec_state,
      debug_cmd_state        => sd_cmd_state,
      debug_cmd_error        => sd_cmd_error
    );

  -- sd2_i intentionally removed for the placement test.

  loader_i : sd_rom_loader
    port map (
      clk                    => clk_sys,
      rst                    => rst,
      sd_init_done           => sd_init_done,
      sd_sec_read            => sd_sec_read,
      sd_sec_read_addr       => sd_sec_read_addr,
      sd_sec_read_data       => sd_sec_read_data,
      sd_sec_read_data_valid => sd_sec_read_valid,
      sd_sec_read_end        => sd_sec_read_end,
      rom_load_we            => sd_rom_load_we,
      rom_load_addr          => sd_rom_load_addr,
      rom_load_data          => sd_rom_load_data,
      boot_done              => sd_boot_done,
      boot_error             => boot_error,
      dbg_state              => loader_state
    );

  -- boot_debug_uart removed: the SD/RAM boot status is no longer streamed over the
  -- UART. The UART now carries only the CPU's own traffic and the PRG upload
  -- monitor, so the magic wake sequence can't collide with boot chatter.
  boot_dbg_data   <= (others => '0');
  boot_dbg_valid  <= '0';
  boot_dbg_active <= '0';


  monitor_rx_i : entity work.uart_rx_ser
    generic map (CLK_HZ => 50_000_000, BAUD => BAUD)
    port map (
      clk     => clk_sys,
      reset_n => reset_n,
      rx      => uart_rx,
      data    => monitor_rx_data,
      valid   => monitor_rx_valid
    );

  -- Small PRG upload monitor from the MiSTer C64 probe (L aaaa / . / G aaaa),
  -- ENABLE_JUMP so "G aaaa" runs an uploaded program via the core's reset-vector
  -- injection; a bare "G" just releases. Replaces the ~2.1k-LUT uart_debug_monitor.
  -- Entered by the UART magic sequence (or the physical key(1)).
  monitor_i : entity work.c64_prg_upload_monitor
    generic map (ENABLE_DUMP => true, ENABLE_JUMP => true)
    port map (
      clk       => clk_sys,
      reset_n   => reset_n,
      enter_btn => mon_enter,
      rx_data   => monitor_rx_data,
      rx_valid  => monitor_rx_valid,
      tx_busy   => uart_tx_busy,
      tx_data   => monitor_tx_data,
      tx_valid  => monitor_tx_valid,
      active    => monitor_active,
      mem_req   => monitor_mem_req,
      mem_we    => monitor_mem_we,
      mem_addr  => monitor_mem_addr,
      mem_wdata => monitor_mem_wdata,
      mem_rdata => monitor_mem_rdata,
      mem_ready => monitor_mem_ready,
      jump_req  => monitor_jump_req,
      jump_addr => monitor_jump_addr
    );

  -- UART 4-byte magic wake sequence -> mon_magic_enter (soft monitor button).
  magic_seq : process(clk_sys)
  begin
    if rising_edge(clk_sys) then
      mon_magic_enter <= '0';
      if reset_n = '0' or monitor_active = '1' then
        mon_magic_idx <= 0;
      elsif monitor_rx_valid = '1' then
        case mon_magic_idx is
          when 0 =>
            if monitor_rx_data = MONITOR_MAGIC0 then mon_magic_idx <= 1;
            else mon_magic_idx <= 0; end if;
          when 1 =>
            if    monitor_rx_data = MONITOR_MAGIC1 then mon_magic_idx <= 2;
            elsif monitor_rx_data = MONITOR_MAGIC0 then mon_magic_idx <= 1;
            else  mon_magic_idx <= 0; end if;
          when 2 =>
            if    monitor_rx_data = MONITOR_MAGIC2 then mon_magic_idx <= 3;
            elsif monitor_rx_data = MONITOR_MAGIC0 then mon_magic_idx <= 1;
            else  mon_magic_idx <= 0; end if;
          when others =>
            if monitor_rx_data = MONITOR_MAGIC3 then mon_magic_enter <= '1'; end if;
            mon_magic_idx <= 0;
        end case;
      end if;
    end if;
  end process;

  -- ULPI bus-capture feature was removed; tie the core's capture-addr input off.
  usb_cap_addr <= (others => '0');

  usb_pll_g : if (USE_USB_HID or USE_USB_DIAG) and USE_USB_PLL generate
    usb_pll_i : Gowin_USB_PLL
      port map (
        clkout0 => usb_clk_12,
        clkin   => clk_50mhz
      );
  end generate;

  usb_div_g : if (USE_USB_HID or USE_USB_DIAG) and not USE_USB_PLL generate
    usb_div_proc : process(clk_50mhz)
    begin
      if rising_edge(clk_50mhz) then
        if usb_div_cnt = "01" then
          usb_div_cnt <= (others => '0');
          usb_clk_div <= not usb_clk_div;
        else
          usb_div_cnt <= usb_div_cnt + 1;
        end if;
      end if;
    end process;
    usb_clk_12 <= usb_clk_div;
  end generate;

  usb_diag_g : if USE_USB_DIAG and not USE_USB_HID generate
    usb_diag_i : entity work.usb_hid_host
      port map (
        clk            => clk_sys,
        reset_n        => reset_n,
        usb_clk        => usb_clk_12,
        usb_dm         => usb_dm,
        usb_dp         => usb_dp,
        cs             => '0',
        we             => '0',
        addr           => "00",
        dout           => usb_dbg_dout,
        irq            => usb_dbg_irq,
        diag_connected => usb_dbg_connected,
        diag_keycode   => usb_dbg_keycode,
        diag_modif     => usb_dbg_modif,
        diag_ascii     => usb_dbg_ascii,
        diag_phase     => usb_dbg_phase,
        diag_key_event => usb_dbg_key_event,
        diag_polling   => usb_dbg_polling
      );
  end generate;

  usb_sbc_diag_g : if USE_USB_HID generate
    usb_dbg_connected <= usb_connected;
    usb_dbg_keycode   <= usb_keycode;
    usb_dbg_modif     <= usb_modif;
    usb_dbg_ascii     <= usb_ascii;
    usb_dbg_phase     <= usb_phase;
    usb_dbg_key_event <= usb_key_event;
    usb_dbg_polling   <= usb_polling;
    usb_dbg_irq       <= '0';
  end generate;

  usb_off_g : if not (USE_USB_HID or USE_USB_DIAG) generate
    usb_clk_12 <= '0';
    usb_dm <= 'Z';
    usb_dp <= 'Z';
    usb_dbg_connected <= '0';
    usb_dbg_keycode   <= (others => '0');
    usb_dbg_modif     <= (others => '0');
    usb_dbg_ascii     <= (others => '0');
    usb_dbg_phase     <= (others => '0');
    usb_dbg_key_event <= '0';
    usb_dbg_polling   <= '0';
    usb_dbg_irq       <= '0';
  end generate;

  sbc_i : entity work.sbc_t65_boot_monitor_top
    generic map (CLK_HZ => 50_000_000, BAUD => BAUD, CEA_480P => false,
                 VGA_640 => true,
                 KBD_LAYOUT => "DE",  -- "DE" QWERTZ or "US" QWERTY
                 USE_USB_HID => USE_USB_HID,
                 ROM_INIT_BUILTIN => not BOOT_FROM_SD)
    port map (
      clk           => clk_sys,
      reset_n       => reset_n,
      boot_done     => sbc_boot_done,
      soft_reset    => soft_reset,
      monitor_hold  => monitor_active,
      monitor_mem_req   => monitor_mem_req,
      monitor_mem_we    => monitor_mem_we,
      monitor_mem_addr  => monitor_mem_addr,
      monitor_mem_wdata => monitor_mem_wdata,
      monitor_mem_rdata => monitor_mem_rdata,
      monitor_mem_ready => monitor_mem_ready,
      monitor_jump_req  => monitor_jump_req,
      monitor_jump_addr => monitor_jump_addr,
      rom_load_we   => rom_load_we,
      rom_load_addr => rom_load_addr,
      rom_load_data => rom_load_data,
      vga_r         => sbc_vga_r,
      vga_g         => sbc_vga_g,
      vga_b         => sbc_vga_b,
      vga_hs        => sbc_vga_hs,
      vga_vs        => sbc_vga_vs,
      vga_de        => sbc_vga_de,
      uart_rx       => uart_rx,
      uart_tx_data  => uart_tx_data,
      uart_tx_valid => uart_tx_valid,
      uart_tx_busy  => uart_tx_busy,
      via_portb     => via_portb,
      sram_ext_req  => sram_ext_req,
      sram_ext_we   => sram_ext_we,
      sram_ext_addr => sram_ext_addr,
      sram_ext_din  => sram_ext_din,
      sram_ext_dout => sram_ext_dout,
      sram_ext_ack  => sram_ext_ack,
      fbw_req        => fbw_req,
      fbw_we         => fbw_we,
      fbw_addr       => fbw_addr,
      fbw_din        => fbw_din,
      fbw_dout       => fbw_dout,
      fbw_ack        => fbw_ack,
      fb_hires       => fb_hires,
      fb_true        => fb_true,
      fb_ddr3_sel    => fb_use_ddr3,
      fb_ddr3_ready  => ddr_calib_sys,
      fb_frame_start => fb_frame_start,
      fb_line_adv    => fb_line_adv,
      fb_rdaddr      => fb_rdaddr,
      fb_rddata      => fb_rddata,
      blit_op    => blit_op,
      blit_x0    => blit_x0,
      blit_y0    => blit_y0,
      blit_x1    => blit_x1,
      blit_y1    => blit_y1,
      blit_color => blit_color,
      blit_page  => blit_page,
      blit_gap   => blit_gap,
      blit_dstx  => blit_dstx,
      blit_dsty  => blit_dsty,
      blit_tex_base => blit_tex_base,
      blit_tex_u0 => blit_tex_u0,
      blit_tex_v0 => blit_tex_v0,
      blit_tex_dudx => blit_tex_dudx,
      blit_tex_dvdx => blit_tex_dvdx,
      blit_tex_dudy => blit_tex_dudy,
      blit_tex_dvdy => blit_tex_dvdy,
      blit_tex_flags => blit_tex_flags,
      blit_start => blit_start,
      blit_busy  => blit_busy,
      dac_bck       => dac_bck,
      dac_ws        => dac_ws,
      dac_din       => dac_din,
      ps2_clk       => ps2_clk,
      ps2_data      => ps2_data,
      usb_clk       => usb_clk_12,
      usb_dm        => usb_dm,
      usb_dp        => usb_dp,
      usb_connected => usb_connected,
      usb_keycode   => usb_keycode,
      usb_modif     => usb_modif,
      usb_ascii     => usb_ascii,
      usb_phase     => usb_phase,
      usb_key_event => usb_key_event,
      usb_polling   => usb_polling,
      usb_cap_addr  => usb_cap_addr,
      usb_cap_data  => usb_cap_data,
      usb_cap_ready => usb_cap_ready,
      sd2_init_done           => sd2_init_done,
      sd2_sec_read            => sd2_sec_read,
      sd2_sec_read_addr       => sd2_sec_read_addr,
      sd2_sec_read_data       => sd2_sec_read_data,
      sd2_sec_read_data_valid => sd2_sec_read_valid,
      sd2_sec_read_end        => sd2_sec_read_end,
      sd2_sec_write           => sd2_sec_write,
      sd2_sec_write_addr      => sd2_sec_write_addr,
      sd2_sec_write_data      => sd2_sec_write_data,
      sd2_sec_write_data_req  => sd2_sec_write_req,
      sd2_sec_write_end       => sd2_sec_write_end,
      dbg_cpu_addr  => dbg_cpu_addr,
      dbg_cpu_data  => dbg_cpu_data,
      dbg_cpu_din   => dbg_cpu_din,
      dbg_cpu_we    => dbg_cpu_we,
      dbg_cpu_sync  => dbg_cpu_sync
    );

  boot_vga_i : entity work.boot_vga_debug
    generic map (
      CLK_DIV  => 2,
      CEA_480P => false,
      VGA_640  => true
    )
    port map (
      clk             => clk_sys,
      reset_n         => reset_n,
      sd_init_done    => sd_init_done,
      sd_sec_read     => sd_sec_read,
      sd_sec_read_end => sd_sec_read_end,
      boot_done       => boot_done,
      boot_error      => boot_error,
      sd_ncs          => sd_ncs_i,
      sd_dclk         => sd_dclk_i,
      sd_mosi_o       => sd_mosi_i,
      sd_miso_i       => sd_miso,
      loader_state    => loader_state,
      sd_sec_state    => sd_sec_state,
      sd_cmd_state    => sd_cmd_state,
      sd_cmd_error    => sd_cmd_error,
      usb_connected   => usb_connected,
      usb_keycode     => usb_keycode,
      usb_modif       => usb_modif,
      usb_ascii       => usb_ascii,
      usb_phase       => usb_phase,
      usb_key_event   => usb_key_event,
      usb_polling     => usb_polling,
      ram_test_active => ram_test_active,
      ram_test_done   => ram_test_done,
      ram_test_error  => ram_test_error,
      ram_test_phase  => ram_test_phase,
      ram_test_addr   => ram_test_addr,
      ram_test_fail_addr => ram_test_fail_addr,
      ram_test_expected  => ram_test_expected,
      ram_test_actual    => ram_test_actual,
      vga_r           => boot_vga_r,
      vga_g           => boot_vga_g,
      vga_b           => boot_vga_b,
      vga_hs          => boot_vga_hs,
      vga_vs          => boot_vga_vs,
      vga_de          => boot_vga_de
    );

  uart_ser_i : entity work.uart_tx_ser
    generic map (CLK_HZ => 50_000_000, BAUD => BAUD)
    port map (
      clk     => clk_sys,
      reset_n => reset_n,
      data    => uart_mux_data,
      valid   => uart_mux_valid,
      tx      => uart_tx,
      busy    => uart_tx_busy
    );

  -- Keep the physical UART quiet during normal BASIC operation.  At the moment
  -- this port is used as a keyboard input, so ACIA chatter on TX only makes the
  -- terminal look broken.  The PRG monitor still owns TX after the magic wake
  -- sequence or the monitor button.
  uart_mux_data  <= monitor_tx_data  when monitor_active = '1' else uart_tx_data;
  uart_mux_valid <= monitor_tx_valid when monitor_active = '1' else '0';

  hdmi_i : entity work.tang138k_hdmi_tx
    generic map (
      DEBUG_OVERLAY => HDMI_DEBUG_OVERLAY
    )
    port map (
      clk_in     => clk_50mhz,
      -- HDMI PLL is decoupled from the reset button so clk_sys keeps running
      -- during a CPU soft reset (and during a full reset, so video stays up).
      reset_n    => '1',
      vga_de     => vga_de,
      vga_hs     => vga_hs,
      vga_vs     => vga_vs,
      vga_r      => vga_r,
      vga_g      => vga_g,
      vga_b      => vga_b,
      debug      => debug_bus,
      clk_sys    => clk_sys,
      clk_pix    => clk_pix,
      pll_lock   => pll_lock,
      tmds_clk_p => tmds_clk_p,
      tmds_clk_n => tmds_clk_n,
      tmds_d_p   => tmds_d_p,
      tmds_d_n   => tmds_d_n
    );

  -- ── Optional DDR3 main-RAM backend ──────────────────────────────────────
  ddr_backend_g : if USE_DDR3 generate
  app_addr29 <= "00" & app_addr27;
  app_wdata256(127 downto 0) <= app_wdata;
  app_wdata256(255 downto 128) <= (others => '0');
  app_wmask32 <= x"FFFF" & app_wdata_mask;
  app_rdata     <= app_rdata256(127 downto 0);
  -- DDR3 bring-up sequenced like the known-good Sipeed DDR reference, with an
  -- automatic calibration retry:
  --  * the DDR memory PLL free-runs (reset tied '0' in the port map below) so it
  --    locks immediately at power-on, independent of the HDMI PLL and the button.
  --  * the controller reset is held a margin after the memory PLL locks, then
  --    released synchronously on clk_50mhz -- the IP's own reference clock.  This
  --    sequencer runs on the board oscillator only; it loads no PLL-derived
  --    fabric clock, so the exclusive PLL placement stays intact.
  --  * if calibration does not complete within DDR_CAL_WAIT, the controller reset
  --    is re-asserted and calibration retried automatically -- Gowin DDR3 bring-up
  --    is occasionally marginal at power-on, so this replaces the manual reset
  --    presses that were otherwise needed before the RAM test would finish.
  --  * a long-press full reset re-asserts the controller reset without disturbing
  --    the free-running memory PLL.
  ddr_reset_seq : process(clk_50mhz)
  begin
    if rising_edge(clk_50mhz) then
      ddr_lock_sync <= ddr_lock_sync(0) & ddr_pll_lock;
      ddr_cal_sync  <= ddr_cal_sync(0)  & ddr_calib_complete;
      long_reset_27_sync <= long_reset_27_sync(1 downto 0) & long_reset;

      if ddr_lock_sync(1) = '0' or long_reset_27 = '1' then
        -- no stable memory clock yet, or a long-press full reset: hold reset
        ddr_rst_state <= DR_ASSERT;
        ddr_rst_cnt   <= 0;
        ddr_rst_n     <= '0';
      else
        case ddr_rst_state is
          when DR_ASSERT =>
            ddr_rst_n <= '0';
            if ddr_rst_cnt = DDR_RST_HOLD then
              ddr_rst_cnt   <= 0;
              ddr_rst_n     <= '1';
              ddr_rst_state <= DR_WAIT_CAL;
            else
              ddr_rst_cnt <= ddr_rst_cnt + 1;
            end if;

          when DR_WAIT_CAL =>
            ddr_rst_n <= '1';
            if ddr_cal_sync(1) = '1' then
              ddr_rst_cnt <= 0;                 -- calibrated: stay released
            elsif ddr_rst_cnt = DDR_CAL_WAIT then
              ddr_rst_cnt   <= 0;
              ddr_rst_state <= DR_ASSERT;       -- timeout: re-assert and retry
              ddr_retry_tog <= not ddr_retry_tog;
            else
              ddr_rst_cnt <= ddr_rst_cnt + 1;
            end if;
        end case;
      end if;
    end if;
  end process;

  long_reset_27 <= long_reset_27_sync(2);

  ddr_mem_pll_i : Gowin_DDR_PLL
    port map (
      lock    => ddr_pll_lock,
      clkout0 => open,
      clkout1 => open,
      clkout2 => ddr_memory_clk,  -- 400 MHz memory clock
      clkin   => clk_50mhz,
      init_clk=> clk_50mhz,
      reset   => '0',
      enclk0  => '1',
      enclk1  => '1',
      enclk2  => ddr_pll_stop
    );

  ddr3_ip_i : DDR3_Memory_Interface_Top
    port map (
      clk                 => clk_50mhz,
      memory_clk          => ddr_memory_clk,
      pll_lock            => ddr_pll_lock,
      rst_n               => ddr_rst_n,
      cmd_ready           => app_cmd_rdy,
      cmd                 => app_cmd,
      cmd_en              => app_cmd_en,
      addr                => app_addr29,
      wr_data_rdy         => app_wdata_rdy,
      wr_data             => app_wdata256,
      wr_data_en          => app_wren,
      wr_data_end         => app_wdata_end,
      wr_data_mask        => app_wmask32,
      rd_data             => app_rdata256,
      rd_data_valid       => app_rdata_valid,
      rd_data_end         => open,
      sr_req              => '0',
      ref_req             => '0',
      sr_ack              => open,
      ref_ack             => open,
      init_calib_complete => ddr_calib_complete,
      clk_out             => ddr_clk_x1,
      ddr_rst             => open,
      pll_stop            => ddr_pll_stop,
      burst               => '1',
      O_ddr_addr          => ddr_addr,
      O_ddr_ba            => ddr_bank,
      O_ddr_cs_n          => ddr_cs,
      O_ddr_ras_n         => ddr_ras,
      O_ddr_cas_n         => ddr_cas,
      O_ddr_we_n          => ddr_we,
      O_ddr_clk           => ddr_ck,
      O_ddr_clk_n         => ddr_ck_n,
      O_ddr_cke           => ddr_cke,
      O_ddr_odt           => ddr_odt,
      O_ddr_reset_n       => ddr_reset_n,
      O_ddr_dqm           => ddr_dm,
      IO_ddr_dq           => ddr_dq,
      IO_ddr_dqs          => ddr_dqs,
      IO_ddr_dqs_n        => ddr_dqs_n
    );

  -- The DDR3 IP now backs ONLY the framebuffer. vic_fb_ddr3 is the sole master
  -- on the app interface (no arbiter); the $4000-$5FFF main-RAM window moved back
  -- to the always-on bram_byte_bridge below, which freed the BSRAM the DDR3 IP
  -- FIFOs need.  One controller serves both geometries (fb_hires selects them):
  --   320x200 8bpp  = 64000 bytes  at DDR3 byte base 0
  --   640x400 8bpp  = 256000 bytes at DDR3 byte base 0x40000 (262144)
  --   320x200 16bpp = 128000 bytes at DDR3 byte base 0x80000 (524288), RGB565
  -- BL8 = 16-byte bursts.
  fb_ddr3_i : entity work.vic_fb_ddr3
    generic map (FB_BASE_WORD => 0, LINE_PIX => 320, NUM_LINES => 200,
                 HIRES_BASE_WORD => 262144, HIRES_LINE_PIX => 640,
                 HIRES_NUM_LINES => 400, TRUE_BASE_WORD => 524288,
                 APP_ADDR_BITS => 27)
    port map (
      clk_sys   => clk_sys,
      rst_sys_n => reset_n,
      hires     => fb_hires,
      bpp16     => fb_true,
      fb_frame_start => fb_frame_start,
      fb_line_adv    => fb_line_adv,
      fb_rdaddr      => fb_rdaddr,
      fb_rddata      => ddr_fb_rddata,
      cpu_req   => ddr_cpu_req,
      cpu_we    => fbw_we,
      cpu_addr  => fbw_addr,
      cpu_din   => fbw_din,
      cpu_dout  => ddr_fbw_dout,
      cpu_ack   => ddr_fbw_ack,

      blit_op    => blit_op,
      blit_x0    => blit_x0,
      blit_y0    => blit_y0,
      blit_x1    => blit_x1,
      blit_y1    => blit_y1,
      blit_color => blit_color,
      blit_page  => blit_page,
      blit_gap_cfg => blit_gap,
      blit_dstx  => blit_dstx,
      blit_dsty  => blit_dsty,
      blit_tex_base => blit_tex_base,
      blit_tex_u0 => blit_tex_u0,
      blit_tex_v0 => blit_tex_v0,
      blit_tex_dudx => blit_tex_dudx,
      blit_tex_dvdx => blit_tex_dvdx,
      blit_tex_dudy => blit_tex_dudy,
      blit_tex_dvdy => blit_tex_dvdy,
      blit_tex_flags => blit_tex_flags,
      blit_start => ddr_blit_start,
      blit_busy  => ddr_blit_busy,

      clk_x1          => ddr_clk_x1,
      calib_done      => ddr_calib_complete,
      app_cmd_rdy     => app_cmd_rdy,
      app_cmd         => app_cmd,
      app_cmd_en      => app_cmd_en,
      app_addr        => app_addr27,
      app_wdata       => app_wdata,
      app_wdata_mask  => app_wdata_mask,
      app_wren        => app_wren,
      app_wdata_end   => app_wdata_end,
      app_wdata_rdy   => app_wdata_rdy,
      app_rdata       => app_rdata,
      app_rdata_valid => app_rdata_valid
    );
  end generate;

  -- ── Main-RAM $4000-$5FFF byte backend ─────────────────────────────────────
  -- Default for Tang Console bring-up: DDR3 stays off and the SBC main RAM uses
  -- the external 16-bit SDRAM0 connector. The old on-chip BSRAM path remains as
  -- a generic-selectable fallback.
  sdram0_clk <= clk_sys when (USE_SDRAM0 or USE_SDRAM_FB) else 'Z';

  sdram_backend_g : if USE_SDRAM0 generate
    sdram_bridge_i : entity work.sdram_byte_bridge
      generic map (BUS_ADDR_BITS => 15, CLEAR_ADDR_BITS => 13)
      port map (
        clk       => clk_sys,
        reset_n   => reset_n,
        req       => sram_ext_req,
        we        => sram_ext_we,
        addr      => sram_ext_addr,
        din       => sram_ext_din,
        dout      => sram_ext_dout,
        ack       => sram_ext_ack,
        ram_ready => ram_ready,
        ram_test_active    => ram_test_active,
        ram_test_done      => ram_test_done,
        ram_test_error     => ram_test_error,
        ram_test_phase     => ram_test_phase,
        ram_test_addr      => ram_test_addr,
        ram_test_fail_addr => ram_test_fail_addr,
        ram_test_expected  => ram_test_expected,
        ram_test_actual    => ram_test_actual,
        sdram_cke   => sdram0_cke_unused,
        sdram_cs_n  => sdram0_cs_n,
        sdram_ras_n => sdram0_ras_n,
        sdram_cas_n => sdram0_cas_n,
        sdram_we_n  => sdram0_we_n,
        sdram_ba    => sdram0_ba,
        sdram_addr  => sdram0_addr,
        sdram_dqm   => sdram0_dqm,
        sdram_dq    => sdram0_dq
      );
  end generate;

  bram_backend_g : if not USE_SDRAM0 generate
    sdram0_unused_g : if not USE_SDRAM_FB generate
      sdram0_cs_n  <= 'Z';
      sdram0_ras_n <= 'Z';
      sdram0_cas_n <= 'Z';
      sdram0_we_n  <= 'Z';
      sdram0_ba    <= (others => 'Z');
      sdram0_addr  <= (others => 'Z');
      sdram0_dqm   <= (others => 'Z');
      sdram0_dq    <= (others => 'Z');
    end generate;

    bram_bridge_i : entity work.bram_byte_bridge
      generic map (BUS_ADDR_BITS => 15, RAM_ADDR_BITS => 13)
      port map (
        clk       => clk_sys,
        reset_n   => reset_n,
        req       => sram_ext_req,
        we        => sram_ext_we,
        addr      => sram_ext_addr,
        din       => sram_ext_din,
        dout      => sram_ext_dout,
        ack       => sram_ext_ack,
        ram_ready => ram_ready,
        ram_test_active    => ram_test_active,
        ram_test_done      => ram_test_done,
        ram_test_error     => ram_test_error,
        ram_test_phase     => ram_test_phase,
        ram_test_addr      => ram_test_addr,
        ram_test_fail_addr => ram_test_fail_addr,
        ram_test_expected  => ram_test_expected,
        ram_test_actual    => ram_test_actual
      );
  end generate;

  -- ── SDRAM0 framebuffer backend (default; runtime-selectable vs DDR3) ───────
  sdram_fb_g : if USE_SDRAM_FB generate
    sdram_fb_i : entity work.sdram_fb
      generic map (LINE_PIX => 320, NUM_LINES => 200)
      port map (
        clk       => clk_sys,
        reset_n   => reset_n,
        ready     => sdram_fb_ready,
        fb_frame_start => fb_frame_start,
        fb_line_adv    => fb_line_adv,
        fb_rdaddr      => fb_rdaddr,
        fb_rddata      => sdfb_rddata,
        hires          => fb_hires,
        cpu_req   => sdfb_cpu_req,
        cpu_we    => fbw_we,
        cpu_addr  => fbw_addr,
        cpu_din   => fbw_din,
        cpu_dout  => sdfb_fbw_dout,
        cpu_ack   => sdfb_fbw_ack,
        blit_op      => blit_op,
        blit_x0      => blit_x0,
        blit_y0      => blit_y0,
        blit_x1      => blit_x1,
        blit_y1      => blit_y1,
        blit_color   => blit_color,
        blit_page    => blit_page,
        blit_gap_cfg => blit_gap,
        blit_dstx    => blit_dstx,
        blit_dsty    => blit_dsty,
        blit_tex_base => blit_tex_base,
        blit_tex_u0 => blit_tex_u0,
        blit_tex_v0 => blit_tex_v0,
        blit_tex_dudx => blit_tex_dudx,
        blit_tex_dvdx => blit_tex_dvdx,
        blit_tex_dudy => blit_tex_dudy,
        blit_tex_dvdy => blit_tex_dvdy,
        blit_tex_flags => blit_tex_flags,
        blit_start   => sdfb_blit_start,
        blit_busy    => sdfb_blit_busy,
        sdram_cke   => sdram0_cke_unused,
        sdram_cs_n  => sdram0_cs_n,
        sdram_ras_n => sdram0_ras_n,
        sdram_cas_n => sdram0_cas_n,
        sdram_we_n  => sdram0_we_n,
        sdram_ba    => sdram0_ba,
        sdram_addr  => sdram0_addr,
        sdram_dqm   => sdram0_dqm,
        sdram_dq    => sdram0_dq
      );
  end generate;

  sdfb_stub_g : if not USE_SDRAM_FB generate
    sdram_fb_ready <= '1';
    sdfb_rddata    <= (others => '0');
    sdfb_fbw_dout  <= (others => '0');
    sdfb_blit_busy <= '0';
    sdfb_stub_ack : process(clk_sys)
    begin
      if rising_edge(clk_sys) then
        sdfb_fbw_ack <= sdfb_cpu_req;
      end if;
    end process;
  end generate;

  -- ── No-DDR3 fallback: park the DDR3 device and stub the DDR mux side ──────
  no_ddr_g : if not USE_DDR3 generate
    -- Keep the uninitialised DDR3 device in reset with clocks and termination
    -- disabled. The bidirectional data/strobe pins remain high impedance.
    ddr_addr    <= (others => '0');
    ddr_bank    <= (others => '0');
    ddr_cs      <= '1';
    ddr_ras     <= '1';
    ddr_cas     <= '1';
    ddr_we      <= '1';
    ddr_ck      <= '0';
    ddr_ck_n    <= '1';
    ddr_cke     <= '0';
    ddr_odt     <= '0';
    ddr_reset_n <= '0';
    ddr_dm      <= (others => '1');
    ddr_dq      <= (others => 'Z');
    ddr_dqs     <= (others => 'Z');
    ddr_dqs_n   <= (others => 'Z');
    app_addr29  <= (others => '0');

    ddr_pll_lock       <= '0';
    ddr_calib_complete <= '0';   -- DDR3 never reports ready -> never selectable
    ddr_clk_x1         <= '0';
    ddr_pll_stop       <= '0';
    ddr_rst_n          <= '0';
    ddr_retry_tog      <= '0';
    ddr_fbw_dout       <= (others => '0');
    ddr_fbw_ack        <= '0';
    ddr_fb_rddata      <= (others => '0');
    ddr_blit_busy      <= '0';
  end generate;

  led(0) <= not (boot_done or sd_init_done) when boot_done = '0' else not via_portb(0);
  led(1) <= not (boot_error or sd_seen_read_end) when boot_done = '0' else not via_portb(1);
  -- DDR3 bring-up diagnostics until the CPU is released:
  --   LED2 lit = DDR memory PLL locked, LED3 lit = DDR3 calibration complete.
  led(2) <= not ddr_pll_lock        when sbc_boot_done = '0' else not via_portb(2);
  led(3) <= not ddr_calib_sys       when sbc_boot_done = '0' else not via_portb(3);

end architecture;
