rudolfstepan/6502-sbc-fpga/rtl/core/sbc_minimal_top.vhd

-- Minimales SBC Top-Level: T65 CPU + RAM + VRAM + ROM + VIC + VIA + UART
--
-- Speicherkarte:
--   $0000-$01FF  512 B FPGA-RAM (Zero Page + Stack)
--   $0200-$0FFF  CPU-SRAM
--   $8000-$87FF  2 KB VRAM      (single-port, geteilt zwischen CPU und VIC)
--   $8800-$880F  VIA 6522       (Timer 1 -> IRQ, Port B)
--   $8810-$8813  UART 6551      (TX)
--   $F800-$FFFF  2 KB ROM       (Kernel, Reset-Vektor)
--
-- Bus-Sharing (C64-Prinzip):
--   VIC stiehlt 40 System-Takte pro H-Blank vom CPU-Bus (RDY-Pin).
--   CPU-Overhead: ~2.5% der Gesamttakte.
library ieee;
use ieee.std_logic_1164.all;
use ieee.numeric_std.all;

use work.sbc_pkg.all;

entity sbc_minimal_top is
  generic (
    ROM_INIT_FILE : string  := "";
    CLK_DIV       : natural := 2;  -- vic_vga pixel-clock divisor (2=50 MHz, 1=25/27 MHz)
    UART_CLK_HZ   : positive := 50_000_000;
    VGA_640       : boolean := false
  );
  port (
    clk      : in  std_logic;
    reset_n  : in  std_logic;

    -- VGA output (from VIC)
    vga_r    : out std_logic_vector(4 downto 0);
    vga_g    : out std_logic_vector(5 downto 0);
    vga_b    : out std_logic_vector(4 downto 0);
    vga_hs   : out std_logic;
    vga_vs   : out std_logic;
    vga_de   : out std_logic;   -- data enable: '1' during active video

    -- VIA Port B output (exposed for board LEDs etc.)
    via_portb : out data_t;

    -- UART (serial keyboard in / echo out)
    uart_rx       : in  std_logic;
    uart_tx_data  : out data_t;
    uart_tx_valid : out std_logic;
    uart_tx_busy  : in  std_logic := '0';  -- from uart_tx_ser.busy

    -- Debug bus
    dbg_cpu_addr : out addr_t;
    dbg_cpu_data : out data_t;
    dbg_cpu_din  : out data_t;
    dbg_cpu_we   : out std_logic;
    dbg_cpu_sync : out std_logic
  );
end entity;

architecture rtl of sbc_minimal_top is
  -- CPU bus
  signal cpu_addr   : addr_t   := (others => '0');
  signal cpu_dout   : data_t   := (others => '0');
  signal cpu_din    : data_t   := (others => '0');
  signal cpu_we     : std_logic := '0';
  signal cpu_sync   : std_logic := '0';
  signal cpu_enable : std_logic := '0';
  signal cpu_bus_we : std_logic := '0';
  signal cpu_rdy    : std_logic := '1';
  signal cpu_irq_n  : std_logic := '1';

  signal dev_sel : device_sel_t;

  -- Memory outputs
  signal zp_dout   : data_t;
  signal sram_dout : data_t;
  signal vram_dout : data_t;
  signal vic_reg_dout : data_t;
  signal rom_dout  : data_t;
  signal via_dout  : data_t;
  signal uart_dout : data_t;

  -- Write enables
  signal zp_cs      : std_logic;
  signal zp_we      : std_logic;
  signal sram_we    : std_logic;
  signal vram_we    : std_logic;
  signal vram_we_mux : std_logic;
  signal vic_reg_we : std_logic;
  signal via_cs     : std_logic;
  signal uart_cs    : std_logic;

  -- VRAM bus mux
  signal vram_addr : std_logic_vector(10 downto 0);

  -- VIC bus steal
  signal vic_addr     : addr_t;
  signal vic_stealing : std_logic;
  signal vic_cursor_x : std_logic_vector(6 downto 0) := (others => '0');
  signal vic_cursor_y : std_logic_vector(4 downto 0) := (others => '0');
  signal vic_text_color : data_t := x"01";  -- $9003: foreground color (default: white)
  signal vic_bg_color   : data_t := x"00";  -- $9004: background color (default: black)
  signal vic_mode_reg   : data_t := x"00";  -- $9000: bitmap, RGB332, framebuffer bank
  signal vic_text_attr  : data_t := x"00";  -- $9005: text attributes (bit1 = 80 columns)
  signal vic_fetch_bitmap : std_logic;

  -- Banked bitmap RAM (16 KB through the $6000-$7FFF CPU window)
  signal bitmap_dout     : data_t;
  signal bitmap_addr     : std_logic_vector(13 downto 0);
  signal bitmap_we       : std_logic;
  signal bitmap_din_mux  : data_t;
  signal bitmap_cpu_we   : std_logic;
  signal bitmap_wr_pending : std_logic := '0';
  signal bitmap_wr_addr  : std_logic_vector(13 downto 0) := (others => '0');
  signal bitmap_wr_data  : data_t := (others => '0');
  signal vram_data_sel   : std_logic := '0';
  signal vram_data_mux   : data_t;

  -- Char ROM
  signal char_addr : std_logic_vector(9 downto 0);
  signal char_data : data_t;

  -- IRQs
  signal via_irq  : std_logic;
  signal uart_irq : std_logic;

  -- UART RX
  signal uart_rx_data  : data_t;
  signal uart_rx_valid : std_logic;

begin
  -- T65 div-2 clock enable
  process(clk)
  begin
    if rising_edge(clk) then
      if reset_n = '0' then
        cpu_enable <= '0';
      else
        cpu_enable <= not cpu_enable;
      end if;
    end if;
  end process;

  cpu_bus_we <= cpu_we and not cpu_enable;
  cpu_rdy    <= not vic_stealing and not bitmap_wr_pending;
  cpu_irq_n  <= not (via_irq or uart_irq);

  -- Fast internal RAM for 6502 Zero Page ($0000-$00FF) and stack ($0100-$01FF).
  zp_cs   <= '1' when dev_sel = DEV_SRAM and cpu_addr(15 downto 9) = "0000000" else '0';
  zp_we   <= cpu_bus_we when zp_cs = '1' else '0';

  -- Write enables
  sram_we <= cpu_bus_we when dev_sel = DEV_SRAM and zp_cs = '0' else '0';
  vram_we <= cpu_bus_we when dev_sel = DEV_VIC_TEXT else '0';
  vic_reg_we <= cpu_bus_we when dev_sel = DEV_VIC_REG else '0';
  via_cs  <= '1'        when dev_sel = DEV_VIA      else '0';
  uart_cs <= '1'        when dev_sel = DEV_UART     else '0';

  -- VRAM bus mux: VIC takes over during steal
  vram_addr   <= vic_addr(10 downto 0) when vic_stealing = '1' and vic_fetch_bitmap = '0'
                 else cpu_addr(10 downto 0);
  vram_we_mux <= '0' when vic_stealing = '1' else vram_we;

  -- Bitmap RAM bus mux with deferred-write latch: a CPU bitmap write that
  -- collides with a VIC steal is held in bitmap_wr_* and committed on the next
  -- non-steal cycle. The CPU is stalled via cpu_rdy until then, so no POKE is lost.
  bitmap_cpu_we <= cpu_bus_we when dev_sel = DEV_VIC_BMP else '0';

  bitmap_addr <= vic_addr(13 downto 0)
                 when vic_stealing = '1' and vic_fetch_bitmap = '1' else
                 bitmap_wr_addr when bitmap_wr_pending = '1' and vic_stealing = '0' else
                 vic_mode_reg(2) &
                 std_logic_vector(resize(unsigned(cpu_addr) - ADDR_VIC_BMP_BASE, 13));
  bitmap_we   <= '1' when bitmap_wr_pending = '1' and vic_stealing = '0' else
                 '0' when vic_stealing = '1' else bitmap_cpu_we;
  bitmap_din_mux <= bitmap_wr_data when bitmap_wr_pending = '1' and vic_stealing = '0'
                    else cpu_dout;

  process(clk)
  begin
    if rising_edge(clk) then
      if reset_n = '0' then
        bitmap_wr_pending <= '0';
        bitmap_wr_addr    <= (others => '0');
        bitmap_wr_data    <= (others => '0');
      elsif bitmap_wr_pending = '1' and vic_stealing = '0' then
        bitmap_wr_pending <= '0';
      elsif bitmap_cpu_we = '1' and vic_stealing = '1' then
        bitmap_wr_pending <= '1';
        bitmap_wr_addr    <= vic_mode_reg(2) &
                             std_logic_vector(resize(unsigned(cpu_addr) - ADDR_VIC_BMP_BASE, 13));
        bitmap_wr_data    <= cpu_dout;
      end if;
    end if;
  end process;

  -- VIC data mux: select bitmap or VRAM data (registered to match sync RAM latency)
  process(clk)
  begin
    if rising_edge(clk) then
      vram_data_sel <= vic_fetch_bitmap;
    end if;
  end process;
  vram_data_mux <= bitmap_dout when vram_data_sel = '1' else vram_dout;

  -- CPU data mux
  process(dev_sel, zp_cs, zp_dout, sram_dout, rom_dout, vram_dout, vic_reg_dout, via_dout, uart_dout, bitmap_dout)
  begin
    case dev_sel is
      when DEV_SRAM =>
        if zp_cs = '1' then
          cpu_din <= zp_dout;
        else
          cpu_din <= sram_dout;
        end if;
      when DEV_ROM =>
        cpu_din <= rom_dout;
      when DEV_VIC_TEXT =>
        cpu_din <= vram_dout;
      when DEV_VIC_REG =>
        cpu_din <= vic_reg_dout;
      when DEV_VIC_BMP =>
        cpu_din <= bitmap_dout;
      when DEV_VIA =>
        cpu_din <= via_dout;
      when DEV_UART =>
        cpu_din <= uart_dout;
      when others =>
        cpu_din <= x"FF";
    end case;
  end process;

  process(clk)
  begin
    if rising_edge(clk) then
      if reset_n = '0' then
        vic_cursor_x <= (others => '0');
        vic_cursor_y <= (others => '0');
        vic_mode_reg <= (others => '0');
        vic_text_attr <= (others => '0');
      elsif vic_reg_we = '1' then
        case cpu_addr(3 downto 0) is
          when x"0" =>
            vic_mode_reg <= cpu_dout;
          when x"1" =>
            if unsigned(cpu_dout(6 downto 0)) < to_unsigned(80, 7) then
              vic_cursor_x <= cpu_dout(6 downto 0);
            end if;
          when x"2" =>
            if unsigned(cpu_dout(4 downto 0)) < to_unsigned(25, 5) then
              vic_cursor_y <= cpu_dout(4 downto 0);
            end if;
          when x"3" =>
            vic_text_color <= cpu_dout;
          when x"4" =>
            vic_bg_color <= cpu_dout;
          when x"5" =>
            vic_text_attr <= cpu_dout;
          when others =>
            null;
        end case;
      end if;
    end if;
  end process;

  process(cpu_addr, vic_cursor_x, vic_cursor_y, vic_text_color, vic_bg_color, vic_mode_reg, vic_text_attr)
  begin
    case cpu_addr(3 downto 0) is
      when x"0" =>
        vic_reg_dout <= vic_mode_reg;
      when x"1" =>
        vic_reg_dout <= '0' & vic_cursor_x;
      when x"2" =>
        vic_reg_dout <= "000" & vic_cursor_y;
      when x"3" =>
        vic_reg_dout <= vic_text_color;
      when x"4" =>
        vic_reg_dout <= vic_bg_color;
      when x"5" =>
        vic_reg_dout <= vic_text_attr;
      when others =>
        vic_reg_dout <= x"00";
    end case;
  end process;

  -- -------------------------------------------------------------------------
  decode_i : entity work.bus_decode
    port map (addr => cpu_addr, sel => dev_sel);

  cpu_i : entity work.t65_adapter
    port map (
      clk      => clk,
      reset_n  => reset_n,
      enable   => cpu_enable,
      rdy      => cpu_rdy,
      irq_n    => cpu_irq_n,
      nmi_n    => '1',
      data_in  => cpu_din,
      addr     => cpu_addr,
      data_out => cpu_dout,
      we       => cpu_we,
      sync     => cpu_sync
    );

  zp_ram_i : entity work.sync_ram
    generic map (ADDR_WIDTH => 9, ASYNC_READ => false)
    port map (clk => clk, we => zp_we,
              addr => cpu_addr(8 downto 0), din => cpu_dout, dout => zp_dout);

  sram_i : entity work.sync_ram
    generic map (ADDR_WIDTH => 12, ASYNC_READ => false)
    port map (clk => clk, we => sram_we,
              addr => cpu_addr(11 downto 0), din => cpu_dout, dout => sram_dout);

  vram_i : entity work.sync_ram
    generic map (ADDR_WIDTH => 11, ASYNC_READ => false)
    port map (clk => clk, we => vram_we_mux,
              addr => vram_addr, din => cpu_dout, dout => vram_dout);

  bitmap_ram_i : entity work.sync_ram
    generic map (ADDR_WIDTH => 14, ASYNC_READ => false)
    port map (clk => clk, we => bitmap_we,
              addr => bitmap_addr, din => bitmap_din_mux, dout => bitmap_dout);

  rom_i : entity work.rom
    generic map (ADDR_WIDTH => 11, INIT_FILE => ROM_INIT_FILE, ASYNC_READ => false)
    port map (clk => clk, addr => cpu_addr(10 downto 0), dout => rom_dout);

  -- -------------------------------------------------------------------------
  -- VIA 6522: Timer 1 generates IRQ; Port B goes to board LEDs
  -- -------------------------------------------------------------------------
  via_i : entity work.via6522
    port map (
      clk       => clk,
      reset_n   => reset_n,
      cs        => via_cs,
      we        => cpu_bus_we,
      addr      => cpu_addr,
      din       => cpu_dout,
      dout      => via_dout,
      porta_in  => (others => '0'),
      portb_in  => (others => '0'),
      porta_out => open,
      portb_out => via_portb,
      irq       => via_irq
    );

  -- -------------------------------------------------------------------------
  -- UART 6551: TX only for this demo (RX not connected)
  -- -------------------------------------------------------------------------
  uart_i : entity work.uart6551
    port map (
      clk      => clk,
      reset_n  => reset_n,
      cs       => uart_cs,
      we       => cpu_bus_we,
      addr     => cpu_addr,
      din      => cpu_dout,
      dout     => uart_dout,
      rx_data  => uart_rx_data,
      rx_valid => uart_rx_valid,
      tx_data  => uart_tx_data,
      tx_valid => uart_tx_valid,
      tx_busy  => uart_tx_busy,
      irq      => uart_irq
    );

  uart_rx_i : entity work.uart_rx_ser
    generic map (CLK_HZ => UART_CLK_HZ)
    port map (
      clk     => clk,
      reset_n => reset_n,
      rx      => uart_rx,
      data    => uart_rx_data,
      valid   => uart_rx_valid
    );

  -- -------------------------------------------------------------------------
  char_i : entity work.char_rom
    port map (addr => char_addr, dout => char_data);

  vic_i : entity work.vic_vga
    generic map (CLK_DIV => CLK_DIV, VGA_640 => VGA_640)
    port map (
      clk          => clk,
      reset_n      => reset_n,
      vic_addr     => vic_addr,
      vram_data    => vram_data_mux,
      vic_stealing => vic_stealing,
      char_addr    => char_addr,
      char_data    => char_data,
      cursor_x     => vic_cursor_x,
      cursor_y     => vic_cursor_y,
      cursor_enable => '1',
      bitmap_mode      => vic_mode_reg(0),
      color256_mode    => vic_mode_reg(1),
      color64_mode     => vic_mode_reg(3),
      cell_bg_mode     => vic_text_attr(0),
      text80_mode      => vic_text_attr(1),
      text_color       => vic_text_color(3 downto 0),
      bg_color         => vic_bg_color(3 downto 0),
      vic_fetch_bitmap => vic_fetch_bitmap,
      vga_hs       => vga_hs,
      vga_vs       => vga_vs,
      vga_de       => vga_de,
      vga_r        => vga_r,
      vga_g        => vga_g,
      vga_b        => vga_b
    );

  dbg_cpu_addr <= cpu_addr;
  dbg_cpu_data <= cpu_dout;
  dbg_cpu_din  <= cpu_din;
  dbg_cpu_we   <= cpu_bus_we;
  dbg_cpu_sync <= cpu_sync;

end architecture;
