rudolfstepan/6502-sbc-fpga/boards/tang_primer_20k/c64_ddr/rtl/tang20k_c64_ddr_top.vhd

-- Tang Primer 20K board top -- native C64 over HDMI.
--
-- Reuses the SBC board's proven clock/HDMI plumbing (tang20k_hdmi_tx: 27 MHz ->
-- 135 MHz TMDS + 27 MHz pixel), the PT8211 audio DAC, and the local DDR3
-- bridge. The machine itself is the c64_ddr-local c64_core_ddr fork.
--
-- KEY[0] = T10 (active-low reset button) -> C64 reset.
-- PS/2 keyboard on PMOD0 (T7 clk / T8 data).
-- HDMI TMDS on the on-board connector. Audio on the dock PT8211.
library ieee;
use ieee.std_logic_1164.all;
use ieee.numeric_std.all;

entity tang20k_c64_ddr_top is
  port (
    clk_27mhz  : in  std_logic;
    key        : in  std_logic_vector(0 downto 0);  -- KEY[0] = reset button (T10)

    ps2_clk    : in  std_logic;
    ps2_data   : in  std_logic;

    dac_bck    : out std_logic;
    dac_ws     : out std_logic;
    dac_din    : out std_logic;
    pa_en      : out std_logic;

    tmds_clk_p : out std_logic;
    tmds_clk_n : out std_logic;
    tmds_d_p   : out std_logic_vector(2 downto 0);
    tmds_d_n   : out std_logic_vector(2 downto 0);

    -- SD card in SPI mode (PMOD1 breakout, same pins as the MiSTer probe).
    sd_dclk    : out std_logic;
    sd_ncs     : out std_logic;
    sd_mosi    : out std_logic;
    sd_miso    : in  std_logic;

    -- Board LEDs, active-low:
    --   LED0 = 1541 read/head-read mode
    --   LED1 = 1541 write/head-write mode
    --   LED2 = drive SD read transfer
    --   LED3 = drive SD write flush
    led        : out std_logic_vector(3 downto 0);

    -- CH340 USB-UART. In normal C64 mode this is the host-disk UART used by
    -- the virtual 1541 server. Sending the monitor wake sequence from the PC
    -- enters the UART monitor/loader, which owns the link until "G".
    uart_tx    : out std_logic;
    uart_rx    : in  std_logic;

    -- DDR3 SDRAM pins: the c64_ddr-local core uses the on-board DDR3 as its
    -- 64K main RAM through ddr3_byte_bridge.
    ddr_addr    : out   std_logic_vector(13 downto 0);
    ddr_bank    : out   std_logic_vector(2 downto 0);
    ddr_cs      : out   std_logic;
    ddr_ras     : out   std_logic;
    ddr_cas     : out   std_logic;
    ddr_we      : out   std_logic;
    ddr_ck      : out   std_logic;
    ddr_ck_n    : out   std_logic;
    ddr_cke     : out   std_logic;
    ddr_odt     : out   std_logic;
    ddr_reset_n : out   std_logic;
    ddr_dm      : out   std_logic_vector(1 downto 0);
    ddr_dq      : inout std_logic_vector(15 downto 0);
    ddr_dqs     : inout std_logic_vector(1 downto 0);
    ddr_dqs_n   : inout std_logic_vector(1 downto 0)
  );
end entity;

architecture rtl of tang20k_c64_ddr_top is
  component sd_card_top
    generic (
      SPI_LOW_SPEED_DIV  : integer := 268;
      SPI_HIGH_SPEED_DIV : integer := 2
    );
    port (
      clk                    : in  std_logic;
      rst                    : in  std_logic;
      SD_nCS                 : out std_logic;
      SD_DCLK                : out std_logic;
      SD_MOSI                : out std_logic;
      SD_MISO                : in  std_logic;
      sd_init_done           : out std_logic;
      sd_sec_read            : in  std_logic;
      sd_sec_read_addr       : in  std_logic_vector(31 downto 0);
      sd_sec_read_data       : out std_logic_vector(7 downto 0);
      sd_sec_read_data_valid : out std_logic;
      sd_sec_read_end        : out std_logic;
      sd_sec_write           : in  std_logic;
      sd_sec_write_addr      : in  std_logic_vector(31 downto 0);
      sd_sec_write_data      : in  std_logic_vector(7 downto 0);
      sd_sec_write_data_req  : out std_logic;
      sd_sec_write_end       : out std_logic;
      debug_sec_state        : out std_logic_vector(4 downto 0);
      debug_cmd_state        : out std_logic_vector(3 downto 0);
      debug_cmd_error        : out std_logic
    );
  end component;

  component DDR3_Memory_Interface_Top
    port (
      clk                 : in    std_logic;
      memory_clk          : in    std_logic;
      pll_lock            : in    std_logic;
      rst_n               : in    std_logic;
      app_burst_number    : in    std_logic_vector(5 downto 0);
      cmd_ready           : out   std_logic;
      cmd                 : in    std_logic_vector(2 downto 0);
      cmd_en              : in    std_logic;
      addr                : in    std_logic_vector(27 downto 0);
      wr_data_rdy         : out   std_logic;
      wr_data             : in    std_logic_vector(127 downto 0);
      wr_data_en          : in    std_logic;
      wr_data_end         : in    std_logic;
      wr_data_mask        : in    std_logic_vector(15 downto 0);
      rd_data             : out   std_logic_vector(127 downto 0);
      rd_data_valid       : out   std_logic;
      rd_data_end         : out   std_logic;
      sr_req              : in    std_logic;
      ref_req             : in    std_logic;
      sr_ack              : out   std_logic;
      ref_ack             : out   std_logic;
      init_calib_complete : out   std_logic;
      clk_out             : out   std_logic;
      ddr_rst             : out   std_logic;
      burst               : in    std_logic;
      O_ddr_addr          : out   std_logic_vector(13 downto 0);
      O_ddr_ba            : out   std_logic_vector(2 downto 0);
      O_ddr_cs_n          : out   std_logic;
      O_ddr_ras_n         : out   std_logic;
      O_ddr_cas_n         : out   std_logic;
      O_ddr_we_n          : out   std_logic;
      O_ddr_clk           : out   std_logic;
      O_ddr_clk_n         : out   std_logic;
      O_ddr_cke           : out   std_logic;
      O_ddr_odt           : out   std_logic;
      O_ddr_reset_n       : out   std_logic;
      O_ddr_dqm           : out   std_logic_vector(1 downto 0);
      IO_ddr_dq           : inout std_logic_vector(15 downto 0);
      IO_ddr_dqs          : inout std_logic_vector(1 downto 0);
      IO_ddr_dqs_n        : inout std_logic_vector(1 downto 0)
    );
  end component;

  component Gowin_rPLL
    port (
      clkout : out std_logic;
      lock   : out std_logic;
      reset  : in  std_logic;
      clkin  : in  std_logic
    );
  end component;

  -- UART monitor/loader on/off. This is the SMALL c64_prg_upload_monitor from
  -- the MiSTer probe board (L/./G subset for tools/c64_uart_prg_loader.py,
  -- a few hundred LUTs) -- the full FLAT_64K uart_debug_monitor (~2.1k LUTs)
  -- no longer fits next to the SD floppy.
  constant ENABLE_UART_MONITOR : boolean := true;
  -- Diagnostic/compatibility variant: use the Python virtual-1541 UART server
  -- instead of the SD-card D64 backend, and do not auto-install the SD LOAD
  -- hook. KERNAL LOAD then falls through to the normal IEC path.
  constant USE_PYTHON_V1541    : boolean := false;
  constant ENABLE_SD_HOOK_BOOT : boolean := true;
  constant C64_DRIVE_BACKEND   : integer := 3;     -- 2 = virtual 1541 UART, 3 = SD D64
  constant C64_DRIVE_SD_WRITE  : boolean := true;  -- only meaningful for backend 3

  -- Four-byte monitor wake sequence. A single magic byte is unsafe once the
  -- same UART also carries arbitrary D64/PRG binary data for the virtual 1541.
  constant MONITOR_MAGIC0 : std_logic_vector(7 downto 0) := x"A5";
  constant MONITOR_MAGIC1 : std_logic_vector(7 downto 0) := x"5A";
  constant MONITOR_MAGIC2 : std_logic_vector(7 downto 0) := x"C3";
  constant MONITOR_MAGIC3 : std_logic_vector(7 downto 0) := x"3C";
  -- Short press = normal C64 reset. Hold KEY[0] for ~1 s to request a cold
  -- FPGA reset that clears C64 RAM before BASIC/KERNAL restarts.
  constant LONG_RESET_CYCLES      : integer := 27_000_000;
  constant COLD_RESET_HOLD_CYCLES : integer := 70_000;
  constant C64_RESET_HOLD_CYCLES  : integer := 270_000; -- 10 ms after DDR/boot
  constant C64_AUTO_RESET_DELAY_CYCLES : integer := 6_750_000; -- 250 ms running
  constant C64_AUTO_RESET_PULSE_CYCLES : integer := 1_350_000; -- 50 ms reset pulse

  signal clk_pix  : std_logic;
  signal clk_sys  : std_logic;
  signal pll_lock : std_logic;

  signal reset_n   : std_logic;
  signal base_reset_n : std_logic;
  signal rst_sync  : std_logic_vector(2 downto 0) := (others => '0');
  signal key0_sync : std_logic_vector(2 downto 0) := (others => '1');
  signal reset_press_cnt : integer range 0 to LONG_RESET_CYCLES := 0;
  signal cold_hold_cnt   : integer range 0 to COLD_RESET_HOLD_CYCLES := 0;
  signal cold_reset      : std_logic := '0';

  signal vga_hs, vga_vs, vga_de : std_logic;
  signal vga_r, vga_b : std_logic_vector(4 downto 0);
  signal vga_g        : std_logic_vector(5 downto 0);
  signal audio        : std_logic_vector(15 downto 0);

  signal dbg_addr   : std_logic_vector(15 downto 0);
  signal dbg_we     : std_logic;
  signal dbg_do     : std_logic_vector(7 downto 0);
  signal dbg_di     : std_logic_vector(7 downto 0);
  signal dbg_sync   : std_logic;
  signal dbg_phi    : std_logic;
  signal dbg_status : std_logic_vector(15 downto 0);
  signal dbg_cia1   : std_logic_vector(31 downto 0);
  signal dbg_iec    : std_logic_vector(31 downto 0);
  signal dbg_regs   : std_logic_vector(63 downto 0);

  signal dbg_uart_tx : std_logic;
  signal c64_disk_uart_tx : std_logic;

  signal mon_rx_data    : std_logic_vector(7 downto 0);
  signal mon_rx_valid   : std_logic;
  signal mon_tx_data    : std_logic_vector(7 downto 0);
  signal mon_tx_valid   : std_logic;
  signal mon_tx_busy    : std_logic;
  signal mon_uart_tx    : std_logic;
  signal mon_active     : std_logic;
  signal mon_enter      : std_logic := '0';
  signal mon_magic_idx  : integer range 0 to 3 := 0;
  signal mon_mem_req    : std_logic;
  signal mon_mem_we     : std_logic;
  signal mon_mem_addr   : std_logic_vector(15 downto 0);
  signal mon_mem_wdata  : std_logic_vector(7 downto 0);
  signal mon_mem_rdata  : std_logic_vector(7 downto 0);
  signal mon_mem_ready  : std_logic;

  -- ---- SD floppy (register map + arbiter identical to the MiSTer probe) ----
  signal sd_init_done   : std_logic;
  signal sd_card_sec_read      : std_logic;
  signal sd_card_sec_read_addr : std_logic_vector(31 downto 0);
  signal sd_sec_read_data  : std_logic_vector(7 downto 0);
  signal sd_sec_read_valid : std_logic;
  signal sd_sec_read_end   : std_logic;
  signal drive_sd_sec_read       : std_logic;
  signal drive_sd_sec_read_addr  : std_logic_vector(31 downto 0);
  signal drive_sd_sec_read_valid : std_logic;
  signal drive_sd_sec_read_end   : std_logic;
  -- Drive (1541 backend) write channel, same request/grant scheme as reads.
  signal drive_sd_sec_write      : std_logic;
  signal drive_sd_sec_write_addr : std_logic_vector(31 downto 0);
  signal drive_sd_sec_write_data : std_logic_vector(7 downto 0);
  signal drive_sd_wr_data_req    : std_logic;
  signal drive_sd_wr_end         : std_logic;
  signal drive_led      : std_logic;
  signal drive_read_active  : std_logic;
  signal drive_write_active : std_logic;
  signal drive_write_byte_pulse   : std_logic;
  signal drive_write_commit_pulse : std_logic;
  signal drive_write_block_done_pulse : std_logic;
  signal drive_write_checksum_error_pulse : std_logic;
  signal drive_write_checksum_calc : std_logic_vector(7 downto 0);
  signal drive_write_checksum_recv : std_logic_vector(7 downto 0);
  signal drive_write_prev_data : std_logic_vector(7 downto 0);
  signal drive_write_last_data : std_logic_vector(7 downto 0);
  signal drive_write_debug : std_logic_vector(7 downto 0);
  signal drive_write_trace_addr : std_logic_vector(4 downto 0) := (others => '0');
  signal drive_write_trace_data : std_logic_vector(31 downto 0);
  signal drive_write_trace_count : std_logic_vector(5 downto 0);
  signal drive_write_trace_clear : std_logic := '0';
  signal led_hold_read      : unsigned(21 downto 0) := (others => '0');
  signal led_hold_write     : unsigned(21 downto 0) := (others => '0');
  signal led_hold_sd_read   : unsigned(21 downto 0) := (others => '0');
  signal led_hold_sd_write  : unsigned(21 downto 0) := (others => '0');
  constant LED_HOLD_CYCLES  : unsigned(21 downto 0) := to_unsigned(2_700_000, 22);

  -- Debug counters for the 1541 write-back path, readable at $DF07
  -- (bits 7:4 card-accepted drive writes, bits 3:0 granted drive writes).
  -- Deliberately NOT cleared by reset_n so a hung SAVE can be diagnosed
  -- after a short reset: 0x00 = no flush was ever requested (GCR decode
  -- never committed), grants>done = the SD write hangs or the card
  -- rejected the block (sd_cmd_error), grants=done but climbing = the
  -- DOS is stuck in a write/verify retry loop.
  signal dbg_wr_grant : unsigned(3 downto 0) := (others => '0');
  signal dbg_wr_done  : unsigned(3 downto 0) := (others => '0');
  signal dbg_gcr_byte_seen : unsigned(3 downto 0) := (others => '0');
  signal dbg_gcr_commit    : unsigned(3 downto 0) := (others => '0');
  signal dbg_gcr_block_done : unsigned(3 downto 0) := (others => '0');
  signal dbg_gcr_checksum_error : unsigned(3 downto 0) := (others => '0');
  signal dbg_sd_wr_end_any : unsigned(3 downto 0) := (others => '0');
  signal dbg_sd_wr_error   : unsigned(3 downto 0) := (others => '0');

  -- Raw write channel of sd_card_top (shared, granted by the arbiter).
  signal sd_wr_data_req : std_logic;
  signal sd_wr_end      : std_logic;
  -- cmd_req_error from sd_card_cmd; during the sd_wr_end pulse it still holds
  -- the just-finished block write's status (no data-response token, rejected
  -- data or busy timeout), so it is sampled exactly then.
  signal sd_cmd_error   : std_logic;
  signal sd_wr_data     : std_logic_vector(7 downto 0);
  signal sd_issue_write : std_logic := '0';
  signal sd_xfer_write  : std_logic := '0';   -- current transfer is a write

  signal exp2_cs    : std_logic;
  signal exp2_we    : std_logic;
  signal exp2_addr  : std_logic_vector(7 downto 0);
  signal exp2_wdata : std_logic_vector(7 downto 0);
  signal exp2_rdata : std_logic_vector(7 downto 0);
  signal disk_io_data : std_logic_vector(7 downto 0);

  signal sd_mount_lba_reg : std_logic_vector(31 downto 0) := (others => '0');
  signal sd_mount_strobe  : std_logic := '0';
  -- Mount LBA LATCHED at the $DF04 strobe.  $DF00-$DF03 double as the raw
  -- block-read/-write LBA ($DF0D/$DF0E bit1), so the hook/menu overwrites the
  -- live register while parsing FAT16; every mounted-D64 track/sector access
  -- must use this latched copy (the 1541 backend latches likewise).
  signal fast_mount_lba   : std_logic_vector(31 downto 0) := (others => '0');
  type fast_buf_t is array(0 to 255) of std_logic_vector(7 downto 0);
  signal fast_buf : fast_buf_t := (others => (others => '0'));
  type fast_state_t is (FAST_IDLE, FAST_WAIT, FW_WRITE);
  signal fast_state : fast_state_t := FAST_IDLE;
  signal fast_track_reg  : std_logic_vector(7 downto 0) := x"12";
  signal fast_sector_reg : std_logic_vector(4 downto 0) := "00001";
  signal fast_offset_reg : unsigned(7 downto 0) := (others => '0');
  signal fast_ready      : std_logic := '0';
  signal fast_error      : std_logic := '0';
  signal fast_map_valid  : std_logic;
  signal fast_map_index  : std_logic_vector(9 downto 0);
  signal fast_map_error  : std_logic_vector(7 downto 0);
  signal fast_upper_half : std_logic := '0';
  signal fast_raw_pos    : unsigned(9 downto 0) := (others => '0');
  -- ~0.62 s at 27 MHz; well above a worst-case SPI sector read.
  constant FAST_TIMEOUT  : unsigned(23 downto 0) := (others => '1');
  signal fast_wait_cnt   : unsigned(23 downto 0) := (others => '0');
  signal fast_req_pend   : std_logic := '0';
  signal fast_req_addr   : std_logic_vector(31 downto 0) := (others => '0');
  -- $DF0x write path: the RMW pre-read fills rmw_buf with the untouched half
  -- of the 512-byte block, then FW_WRITE streams fast_buf/rmw_buf back out.
  signal rmw_buf         : fast_buf_t := (others => (others => '0'));
  signal fast_rmw        : std_logic := '0';  -- FAST_WAIT read is an RMW pre-read
  signal fast_wrreq_pend : std_logic := '0';
  signal fast_wr_idx     : unsigned(9 downto 0) := (others => '0');
  signal fast_wr_byte    : std_logic_vector(7 downto 0) := (others => '0');
  -- Single async read port per buffer (a second read port stops Gowin from
  -- extracting the 256x8 arrays as SSRAM and costs >1.5k LUTs each): during
  -- FW_WRITE the streaming index borrows fast_buf's port; the $DF0C readback
  -- is meaningless then anyway (window is busy).
  signal fast_rd_addr    : unsigned(7 downto 0);
  signal fast_buf_rd     : std_logic_vector(7 downto 0);
  signal rmw_buf_rd      : std_logic_vector(7 downto 0);
  -- Single write port per buffer: enable/address/data are fully muxed
  -- combinationally and each array has exactly ONE write statement.  Multiple
  -- textual writes (CPU store + SD capture) make the synthesizer fall back
  -- from SSRAM to registers+muxes (~2k LUTs for a 256x8 array).
  signal fb_cpu_we       : std_logic;
  signal fb_sd_we        : std_logic;
  signal fb_we           : std_logic;
  signal fb_addr         : unsigned(7 downto 0);
  signal fb_data         : std_logic_vector(7 downto 0);
  signal rmw_we          : std_logic;
  signal drive_req_pend  : std_logic := '0';
  signal drive_req_addr  : std_logic_vector(31 downto 0) := (others => '0');
  signal drive_wrreq_pend : std_logic := '0';
  signal drive_wrreq_addr : std_logic_vector(31 downto 0) := (others => '0');
  signal sd_mounted      : std_logic := '0';
  signal sd_owner_fast   : std_logic := '0';
  signal sd_owner_boot   : std_logic := '0';
  signal sd_xfer_busy    : std_logic := '0';
  signal sd_issue_read   : std_logic := '0';
  signal sd_issue_addr   : std_logic_vector(31 downto 0) := (others => '0');

  -- ---- SD hook boot loader + write shim onto the c64_core monitor port ----
  signal boot_req_pend   : std_logic := '0';
  signal boot_req_addr   : std_logic_vector(31 downto 0) := (others => '0');
  signal boot_sd_sec_read : std_logic;
  signal boot_sd_sec_read_addr : std_logic_vector(31 downto 0);
  signal boot_sd_valid   : std_logic;
  signal boot_sd_end     : std_logic;
  signal boot_mem_we     : std_logic;
  signal boot_mem_addr   : std_logic_vector(15 downto 0);
  signal boot_mem_wdata  : std_logic_vector(7 downto 0);
  signal boot_active     : std_logic;
  signal boot_done       : std_logic;
  signal boot_status     : std_logic_vector(7 downto 0);
  -- Small FIFO between the boot loader's per-byte writes and the monitor
  -- port's req/ready handshake (SPI bytes arrive ~127 clks apart, the
  -- handshake takes a few clks, so depth 4 is generous).
  constant BQ_DEPTH : integer := 4;
  type bq_addr_t is array (0 to BQ_DEPTH-1) of std_logic_vector(15 downto 0);
  type bq_data_t is array (0 to BQ_DEPTH-1) of std_logic_vector(7 downto 0);
  signal bq_addr : bq_addr_t := (others => (others => '0'));
  signal bq_data : bq_data_t := (others => (others => '0'));
  signal bq_cnt  : integer range 0 to BQ_DEPTH := 0;
  type bq_state_t is (BQ_IDLE, BQ_REQ, BQ_WAIT);
  signal bq_state : bq_state_t := BQ_IDLE;
  signal boot_owns : std_logic;

  -- c64_core monitor port after the boot/monitor mux
  signal core_mon_hold  : std_logic;
  signal core_mon_req   : std_logic;
  signal core_mon_we    : std_logic;
  signal core_mon_addr  : std_logic_vector(15 downto 0);
  signal core_mon_wdata : std_logic_vector(7 downto 0);
  signal core_mon_ready : std_logic;
  signal bq_cur_addr    : std_logic_vector(15 downto 0) := (others => '0');
  signal bq_cur_data    : std_logic_vector(7 downto 0) := (others => '0');

  -- ---- DDR3 main RAM backend for the local c64_ddr core fork ----
  signal c64_reset_n        : std_logic;
  signal c64_reset_reg      : std_logic := '0';
  signal c64_reset_cnt      : integer range 0 to C64_RESET_HOLD_CYCLES := C64_RESET_HOLD_CYCLES;
  signal auto_board_reset_n : std_logic := '1';
  signal c64_auto_delay_cnt : integer range 0 to C64_AUTO_RESET_DELAY_CYCLES := C64_AUTO_RESET_DELAY_CYCLES;
  signal c64_auto_pulse_cnt : integer range 0 to C64_AUTO_RESET_PULSE_CYCLES := C64_AUTO_RESET_PULSE_CYCLES;
  type c64_reset_state_t is (CR_WAIT_RAM, CR_INITIAL_HOLD, CR_RUN_DELAY, CR_AUTO_PULSE, CR_DONE);
  signal c64_reset_state : c64_reset_state_t := CR_WAIT_RAM;
  signal ddr_memory_clk     : std_logic;
  signal ddr_pll_lock       : std_logic;
  signal ddr_clk_x1         : std_logic;
  signal ddr_calib_complete : std_logic;
  signal app_cmd            : std_logic_vector(2 downto 0);
  signal app_cmd_en         : std_logic;
  signal app_cmd_rdy        : std_logic;
  signal app_addr27         : std_logic_vector(26 downto 0);
  signal app_addr28         : std_logic_vector(27 downto 0);
  constant DDR_RST_HOLD     : integer := 1023;
  constant DDR_CAL_WAIT     : integer := 540_000;
  type ddr_rst_state_t is (DR_ASSERT, DR_WAIT_CAL);
  signal ddr_rst_state      : ddr_rst_state_t := DR_ASSERT;
  signal ddr_rst_n          : std_logic := '0';
  signal ddr_lock_sync      : std_logic_vector(1 downto 0) := (others => '0');
  signal ddr_cal_sync       : std_logic_vector(1 downto 0) := (others => '0');
  signal ddr_rst_cnt        : integer range 0 to DDR_CAL_WAIT := 0;
  signal app_wren           : std_logic;
  signal app_wdata          : std_logic_vector(127 downto 0);
  signal app_wdata_end      : std_logic;
  signal app_wdata_mask     : std_logic_vector(15 downto 0);
  signal app_wdata_rdy      : std_logic;
  signal app_rdata          : std_logic_vector(127 downto 0);
  signal app_rdata_valid    : std_logic;
  signal c64_ram_req        : std_logic;
  signal c64_ram_we         : std_logic;
  signal c64_ram_addr       : std_logic_vector(15 downto 0);
  signal c64_ram_din        : std_logic_vector(7 downto 0);
  signal c64_ram_dout       : std_logic_vector(7 downto 0);
  signal c64_ram_ack        : std_logic;
  signal ram_ready          : std_logic;
  signal ram_test_active    : std_logic;
  signal ram_test_done      : std_logic;
  signal ram_test_error     : std_logic;
  signal ram_test_phase     : std_logic_vector(3 downto 0);
  signal ram_test_addr      : std_logic_vector(15 downto 0);
  signal ram_test_fail_addr : std_logic_vector(15 downto 0);
  signal ram_test_expected  : std_logic_vector(7 downto 0);
  signal ram_test_actual    : std_logic_vector(7 downto 0);

  -- DIAG heartbeat taps -- DISABLED (placement experiment). Re-enable the led port,
  -- the .cst led pins, dbg_cia1_irq in c64_core, and this whole block together.
  -- signal dbg_sync     : std_logic;
  -- signal dbg_cia1_irq : std_logic;
  -- signal sync_d       : std_logic := '0';
  -- signal cpu_cnt      : unsigned(19 downto 0) := (others => '0');
  -- signal irq_low_cnt  : unsigned(21 downto 0) := (others => '0');
  -- signal irq_stuck    : std_logic := '0';
begin
  pa_en <= '1';   -- enable dock audio power amplifier
  reset_n <= base_reset_n and auto_board_reset_n;
  c64_reset_n <= c64_reset_reg and reset_n;

  led(0) <= not ddr_pll_lock       when ram_ready = '0' else
            '0' when led_hold_read     /= 0 else '1';
  led(1) <= not ddr_calib_complete when ram_ready = '0' else
            '0' when led_hold_write    /= 0 else '1';
  led(2) <= not ram_test_active    when ram_ready = '0' else
            '0' when led_hold_sd_read  /= 0 else '1';
  led(3) <= '0' when ram_test_error = '1' else
            '0' when led_hold_sd_write /= 0 else '1';

  process(clk_pix)
  begin
    if rising_edge(clk_pix) then
      if reset_n = '0' then
        led_hold_read     <= (others => '0');
        led_hold_write    <= (others => '0');
        led_hold_sd_read  <= (others => '0');
        led_hold_sd_write <= (others => '0');
      else
        if drive_read_active = '1' then
          led_hold_read <= LED_HOLD_CYCLES;
        elsif led_hold_read /= 0 then
          led_hold_read <= led_hold_read - 1;
        end if;

        if drive_write_active = '1' then
          led_hold_write <= LED_HOLD_CYCLES;
        elsif led_hold_write /= 0 then
          led_hold_write <= led_hold_write - 1;
        end if;

        if (sd_xfer_busy = '1' and sd_owner_fast = '0' and sd_owner_boot = '0'
            and sd_xfer_write = '0') or drive_sd_sec_read = '1' then
          led_hold_sd_read <= LED_HOLD_CYCLES;
        elsif led_hold_sd_read /= 0 then
          led_hold_sd_read <= led_hold_sd_read - 1;
        end if;

        if (sd_xfer_busy = '1' and sd_owner_fast = '0' and sd_owner_boot = '0'
            and sd_xfer_write = '1') or drive_sd_sec_write = '1' then
          led_hold_sd_write <= LED_HOLD_CYCLES;
        elsif led_hold_sd_write /= 0 then
          led_hold_sd_write <= led_hold_sd_write - 1;
        end if;
      end if;
    end if;
  end process;

  -- process(clk_pix)
  -- begin
  --   if rising_edge(clk_pix) then
  --     sync_d <= dbg_sync;
  --     if dbg_sync = '1' and sync_d = '0' then
  --       cpu_cnt <= cpu_cnt + 1;
  --     end if;
  --     if dbg_cia1_irq = '1' then
  --       irq_low_cnt <= (others => '0');
  --     elsif irq_low_cnt(21) = '1' then
  --       irq_stuck <= '1';
  --     else
  --       irq_low_cnt <= irq_low_cnt + 1;
  --     end if;
  --   end if;
  -- end process;
  -- led(0) <= not irq_stuck;
  -- led(1) <= cpu_cnt(19);

  -- The virtual 1541 protocol is binary, so the debug stream must not share the
  -- line while the C64 is running. The monitor still preempts the link after the
  -- wake-sequence handshake.
  uart_tx <= mon_uart_tx when mon_active = '1' else c64_disk_uart_tx;

  -- Reset: hold until the PLL locks and the button is released, in the pixel domain.
  -- A long button press requests a cold reset and keeps the core reset long
  -- enough for c64_core to scrub 64K RAM + colour RAM.
  process(clk_pix)
  begin
    if rising_edge(clk_pix) then
      key0_sync <= key0_sync(1 downto 0) & key(0);
      rst_sync  <= rst_sync(1 downto 0) & (pll_lock and key0_sync(2) and not cold_reset);

      if pll_lock = '0' then
        reset_press_cnt <= 0;
        cold_hold_cnt   <= 0;
        cold_reset      <= '0';
      elsif key0_sync(2) = '0' then
        if reset_press_cnt < LONG_RESET_CYCLES then
          reset_press_cnt <= reset_press_cnt + 1;
        end if;

        if reset_press_cnt = LONG_RESET_CYCLES - 1 then
          cold_reset    <= '1';
          cold_hold_cnt <= COLD_RESET_HOLD_CYCLES;
        elsif cold_reset = '1' then
          cold_hold_cnt <= COLD_RESET_HOLD_CYCLES;
        end if;
      else
        reset_press_cnt <= 0;
        if cold_hold_cnt > 0 then
          cold_reset    <= '1';
          cold_hold_cnt <= cold_hold_cnt - 1;
        else
          cold_reset <= '0';
        end if;
      end if;
    end if;
  end process;
  base_reset_n <= rst_sync(2);

  -- Release the C64 only after DDR is ready, then emulate the short manual
  -- reset pulse that reliably recovers the VIC after the board has warmed up.
  -- The automatic pulse resets only the C64 core.  Keeping reset_n high avoids
  -- restarting the SD controller/boot loader after the hook has just been
  -- copied, so the disk menu does not reach READY before sd_init_done returns.
  -- While boot_owns is high before the one-shot pulse, keep the core alive so
  -- the monitor RAM handshake can drain; the CPU is parked by monitor_hold.
  process(clk_pix)
  begin
    if rising_edge(clk_pix) then
      if base_reset_n = '0' then
        c64_reset_reg <= '0';
        auto_board_reset_n <= '1';
        c64_reset_state <= CR_WAIT_RAM;
        c64_reset_cnt <= C64_RESET_HOLD_CYCLES;
        c64_auto_delay_cnt <= C64_AUTO_RESET_DELAY_CYCLES;
        c64_auto_pulse_cnt <= C64_AUTO_RESET_PULSE_CYCLES;
      elsif boot_owns = '1' and c64_reset_state /= CR_AUTO_PULSE
            and c64_reset_state /= CR_DONE then
        c64_reset_reg <= '1';
        auto_board_reset_n <= '1';
        c64_reset_state <= CR_WAIT_RAM;
        c64_reset_cnt <= C64_RESET_HOLD_CYCLES;
        c64_auto_delay_cnt <= C64_AUTO_RESET_DELAY_CYCLES;
        c64_auto_pulse_cnt <= C64_AUTO_RESET_PULSE_CYCLES;
      else
        case c64_reset_state is
          when CR_WAIT_RAM =>
            c64_reset_reg <= '0';
            auto_board_reset_n <= '1';
            c64_reset_cnt <= C64_RESET_HOLD_CYCLES;
            c64_auto_delay_cnt <= C64_AUTO_RESET_DELAY_CYCLES;
            c64_auto_pulse_cnt <= C64_AUTO_RESET_PULSE_CYCLES;
            if ram_ready = '1' then
              c64_reset_state <= CR_INITIAL_HOLD;
            end if;

          when CR_INITIAL_HOLD =>
            c64_reset_reg <= '0';
            auto_board_reset_n <= '1';
            if ram_ready = '0' then
              c64_reset_state <= CR_WAIT_RAM;
            elsif c64_reset_cnt > 0 then
              c64_reset_cnt <= c64_reset_cnt - 1;
            else
              c64_reset_reg <= '1';
              c64_reset_state <= CR_RUN_DELAY;
            end if;

          when CR_RUN_DELAY =>
            c64_reset_reg <= '1';
            auto_board_reset_n <= '1';
            if ram_ready = '0' then
              c64_reset_reg <= '0';
              c64_reset_state <= CR_WAIT_RAM;
            elsif c64_auto_delay_cnt > 0 then
              c64_auto_delay_cnt <= c64_auto_delay_cnt - 1;
            else
              c64_reset_reg <= '0';
              auto_board_reset_n <= '1';
              c64_auto_pulse_cnt <= C64_AUTO_RESET_PULSE_CYCLES;
              c64_reset_state <= CR_AUTO_PULSE;
            end if;

          when CR_AUTO_PULSE =>
            c64_reset_reg <= '0';
            auto_board_reset_n <= '1';
            if c64_auto_pulse_cnt > 0 then
              c64_auto_pulse_cnt <= c64_auto_pulse_cnt - 1;
            else
              c64_reset_reg <= '1';
              auto_board_reset_n <= '1';
              c64_reset_state <= CR_DONE;
            end if;

          when CR_DONE =>
            auto_board_reset_n <= '1';
            if ram_ready = '1' then
              c64_reset_reg <= '1';
            else
              c64_reset_reg <= '0';
            end if;
        end case;
      end if;
    end if;
  end process;

  -- ===================== SD floppy =====================
  -- Register map, arbiter and boot flow are identical to the MiSTer C64 probe
  -- board (tang20k_mister_c64_probe_top), so the same FAT16 card, resident SD
  -- hook and disk menu work unchanged.
  --
  -- SD D64 mount register window in C64 I/O2:
  --   $DF00-$DF03  selected .d64 start LBA, little-endian.  NOTE: this is a
  --                live scratch register (also the raw-read/-write LBA for
  --                $DF0D/$DF0E bit1); the mount base used by the $DF08-$DF0B
  --                track/sector window and the $DF0E sector write is LATCHED
  --                from here at the $DF04 strobe (fast_mount_lba), so later
  --                raw accesses cannot silently move the mounted image.
  --   $DF04        write bit0=1 to mount/invalidate the cached sector
  --   $DF05        status: bit0 SD init done, bit1 drive active,
  --                bit2 D64 mounted, bit7 packed-D64 mode
  --   $DF06        hook boot loader status: bit0 done, bit1 success,
  --                bit2 header seen, bit3 gave up, bit4 SD seen,
  --                bits7:5 copy attempts
  --
  -- Tang fastload sector window:
  --   $DF08        D64 track (1-based)
  --   $DF09        D64 sector
  --   $DF0A        byte offset inside buffered sector
  --   $DF0B        write bit0=1 to read sector, bit1=1 to clear error
  --                read status: bit0 SD ready, bit1 busy, bit2 sector ready,
  --                bit3 error, bit4 D64 mounted, bit7 packed-D64 mode
  --   $DF0C        buffered sector byte at $DF0A
  --   $DF0D        write bit0=1 to read the raw 512-byte SD block at the
  --                $DF00-$DF03 LBA (no mount required), bit1 selects the
  --                buffered 256-byte half; poll $DF0B, read via $DF0A/$DF0C.
  --                Lets the C64 parse the FAT16 filesystem itself.
  --   $DF0C  W     store a byte at offset $DF0A into the sector buffer
  --                (fill the buffer before a $DF0E write command).
  --   $DF0E  W     bit0=1: write the buffered 256 bytes to the mounted D64
  --                at track/sector $DF08/$DF09 (read-modify-write of the
  --                512-byte SD block, the other half is preserved).
  --                bit1=1: raw write of the buffered 256 bytes into the SD
  --                block at the $DF00-$DF03 LBA, bit2 selects the half
  --                (no mount required; counterpart of the $DF0D raw read).
  --                Poll $DF0B: busy bit1, done bit2 (fast_ready), error bit3.
  exp2_rdata <= disk_io_data when exp2_addr(7 downto 4) = "0000"
                              or exp2_addr(7 downto 4) = "0001"
                else x"FF";

  fast_rd_addr <= fast_wr_idx(7 downto 0) when fast_state = FW_WRITE
                  else fast_offset_reg;
  fast_buf_rd  <= fast_buf(to_integer(fast_rd_addr));
  rmw_buf_rd   <= rmw_buf(to_integer(fast_wr_idx(7 downto 0)));

  -- fast_buf write port: CPU store to $DF0C, or the SD capture of a normal
  -- fastload/raw read (the RMW pre-read goes to rmw_buf instead).
  fb_cpu_we <= '1' when exp2_we = '1' and exp2_addr(7 downto 4) = "0000"
                    and to_integer(unsigned(exp2_addr(3 downto 0))) = 12
               else '0';
  fb_sd_we  <= '1' when fast_state = FAST_WAIT and fast_rmw = '0'
                    and sd_owner_fast = '1' and sd_xfer_busy = '1'
                    and sd_sec_read_valid = '1'
                    and fast_raw_pos(8) = fast_upper_half
               else '0';
  fb_we   <= fb_cpu_we or fb_sd_we;
  fb_addr <= fast_offset_reg when fb_cpu_we = '1' else fast_raw_pos(7 downto 0);
  fb_data <= exp2_wdata      when fb_cpu_we = '1' else sd_sec_read_data;

  -- rmw_buf write port: the RMW pre-read parks the untouched block half here.
  rmw_we <= '1' when fast_state = FAST_WAIT and fast_rmw = '1'
                 and sd_owner_fast = '1' and sd_xfer_busy = '1'
                 and sd_sec_read_valid = '1'
                 and fast_raw_pos(8) /= fast_upper_half
            else '0';

  process(exp2_addr, sd_mount_lba_reg, sd_init_done, drive_led, sd_mounted,
          fast_track_reg, fast_sector_reg, fast_offset_reg, fast_ready,
          fast_error, fast_state, fast_buf_rd, boot_status,
          dbg_wr_grant, dbg_wr_done, dbg_gcr_byte_seen, dbg_gcr_commit,
          dbg_gcr_block_done, dbg_gcr_checksum_error,
          dbg_sd_wr_end_any, dbg_sd_wr_error,
          drive_write_checksum_calc, drive_write_checksum_recv,
          drive_write_prev_data, drive_write_last_data, drive_write_debug,
          drive_write_trace_data, drive_write_trace_count)
  begin
    case exp2_addr(7 downto 4) is
      when "0000" =>
        case to_integer(unsigned(exp2_addr(3 downto 0))) is
          when 0 => disk_io_data <= drive_write_checksum_calc;
          when 1 => disk_io_data <= drive_write_checksum_recv;
          when 2 => disk_io_data <= drive_write_prev_data;
          when 3 => disk_io_data <= drive_write_last_data;
          when 4 => disk_io_data <= drive_write_debug;
          when 5 => disk_io_data <= "1" & "0000" & sd_mounted & drive_led & sd_init_done;
          when 6 => disk_io_data <= boot_status;
          when 7 => disk_io_data <= std_logic_vector(dbg_wr_done) & std_logic_vector(dbg_wr_grant);
          when 8 => disk_io_data <= fast_track_reg;
          when 9 => disk_io_data <= "000" & fast_sector_reg;
          when 10 => disk_io_data <= std_logic_vector(fast_offset_reg);
          when 11 =>
            if fast_state = FAST_IDLE then
              disk_io_data <= "1" & "00" & sd_mounted & fast_error & fast_ready & "0" & sd_init_done;
            else
              disk_io_data <= "1" & "00" & sd_mounted & fast_error & fast_ready & "1" & sd_init_done;
            end if;
          when 12 => disk_io_data <= fast_buf_rd;
          when 13 => disk_io_data <= std_logic_vector(dbg_gcr_checksum_error) & std_logic_vector(dbg_gcr_block_done);
          when 14 => disk_io_data <= std_logic_vector(dbg_sd_wr_error) & std_logic_vector(dbg_sd_wr_end_any);
          when 15 => disk_io_data <= std_logic_vector(dbg_gcr_commit) & std_logic_vector(dbg_gcr_byte_seen);
          when others => disk_io_data <= (others => '0');
        end case;
      when "0001" =>
        case to_integer(unsigned(exp2_addr(3 downto 0))) is
          when 0 => disk_io_data <= "00" & drive_write_trace_count;
          when 1 => disk_io_data <= drive_write_trace_data(31 downto 24);
          when 2 => disk_io_data <= drive_write_trace_data(23 downto 16);
          when 3 => disk_io_data <= drive_write_trace_data(15 downto 8);
          when 4 => disk_io_data <= drive_write_trace_data(7 downto 0);
          when others => disk_io_data <= x"FF";
        end case;
      when others =>
        disk_io_data <= x"FF";
    end case;
  end process;

  fast_map_i : entity work.d64_sector_map
    port map (
      track        => fast_track_reg,
      sector       => "000" & fast_sector_reg,
      valid        => fast_map_valid,
      sector_index => fast_map_index,
      error_code   => fast_map_error
    );

  -- SD access arbiter: the 1541 drive backend, the $DF08 fastload window and
  -- the power-up boot loader all read whole 512-byte blocks from sd_card_top.
  -- Requests are latched and the controller is granted to one owner per
  -- complete transfer, so no side can steal another's data stream mid-sector.
  sd_card_sec_read      <= sd_issue_read;
  sd_card_sec_read_addr <= sd_issue_addr;
  drive_sd_sec_read_valid <= sd_sec_read_valid when sd_owner_fast = '0' and sd_owner_boot = '0' and sd_xfer_busy = '1' and sd_xfer_write = '0' else '0';
  drive_sd_sec_read_end   <= sd_sec_read_end   when sd_owner_fast = '0' and sd_owner_boot = '0' and sd_xfer_busy = '1' and sd_xfer_write = '0' else '0';
  boot_sd_valid <= sd_sec_read_valid when sd_owner_boot = '1' and sd_xfer_busy = '1' and sd_xfer_write = '0' else '0';
  boot_sd_end   <= sd_sec_read_end   when sd_owner_boot = '1' and sd_xfer_busy = '1' and sd_xfer_write = '0' else '0';

  -- Write-channel routing: the drive and the $DF0x window share sd_card_top's
  -- byte-request/byte handshake; only the granted owner sees it.
  drive_sd_wr_data_req <= sd_wr_data_req when sd_owner_fast = '0' and sd_owner_boot = '0' and sd_xfer_busy = '1' and sd_xfer_write = '1' else '0';
  drive_sd_wr_end      <= sd_wr_end      when sd_owner_fast = '0' and sd_owner_boot = '0' and sd_xfer_busy = '1' and sd_xfer_write = '1' else '0';
  sd_wr_data <= fast_wr_byte when sd_owner_fast = '1' else drive_sd_sec_write_data;

  process(clk_pix)
  begin
    if rising_edge(clk_pix) then
      sd_mount_strobe <= '0';
      sd_issue_read <= '0';
      sd_issue_write <= '0';
      drive_write_trace_clear <= '0';

      -- Registered read of the outgoing write byte.  fast_wr_idx points at the
      -- byte the NEXT data request will transmit; the controller samples the
      -- byte one cycle after its request, which matches this one-cycle-late
      -- registered mux exactly (spi_master latches data once per byte).
      -- (fast_buf_rd follows fast_wr_idx in FW_WRITE via fast_rd_addr.)
      if fast_wr_idx(8) = fast_upper_half then
        fast_wr_byte <= fast_buf_rd;
      else
        fast_wr_byte <= rmw_buf_rd;
      end if;

      -- Single write port per buffer (see fb_*/rmw_we above).
      if fb_we = '1' then
        fast_buf(to_integer(fb_addr)) <= fb_data;
      end if;
      if rmw_we = '1' then
        rmw_buf(to_integer(fast_raw_pos(7 downto 0))) <= sd_sec_read_data;
      end if;

      if reset_n = '0' then
        sd_mount_lba_reg <= (others => '0');
        drive_write_trace_addr <= (others => '0');
        drive_write_trace_clear <= '1';
        fast_mount_lba <= (others => '0');
        sd_mounted <= '0';
        fast_state <= FAST_IDLE;
        fast_track_reg <= x"12";
        fast_sector_reg <= "00001";
        fast_offset_reg <= (others => '0');
        fast_ready <= '0';
        fast_error <= '0';
        fast_req_pend <= '0';
        fast_req_addr <= (others => '0');
        fast_upper_half <= '0';
        fast_raw_pos <= (others => '0');
        fast_wait_cnt <= (others => '0');
        fast_rmw <= '0';
        fast_wrreq_pend <= '0';
        fast_wr_idx <= (others => '0');
        drive_req_pend <= '0';
        drive_req_addr <= (others => '0');
        drive_wrreq_pend <= '0';
        drive_wrreq_addr <= (others => '0');
        boot_req_pend <= '0';
        boot_req_addr <= (others => '0');
        sd_owner_fast <= '0';
        sd_owner_boot <= '0';
        sd_xfer_busy <= '0';
        sd_xfer_write <= '0';
      else
        -- Latch drive and boot-loader sector requests so they survive a
        -- running transfer; each requester waits on sd_sec_read_end and
        -- never has more than one request outstanding.
        if drive_sd_sec_read = '1' then
          drive_req_pend <= '1';
          drive_req_addr <= drive_sd_sec_read_addr;
        end if;
        if drive_sd_sec_write = '1' then
          drive_wrreq_pend <= '1';
          drive_wrreq_addr <= drive_sd_sec_write_addr;
        end if;
        if drive_write_byte_pulse = '1' and dbg_gcr_byte_seen /= 15 then
          dbg_gcr_byte_seen <= dbg_gcr_byte_seen + 1;
        end if;
        if drive_write_commit_pulse = '1' and dbg_gcr_commit /= 15 then
          dbg_gcr_commit <= dbg_gcr_commit + 1;
        end if;
        if drive_write_block_done_pulse = '1' and dbg_gcr_block_done /= 15 then
          dbg_gcr_block_done <= dbg_gcr_block_done + 1;
        end if;
        if drive_write_checksum_error_pulse = '1' and dbg_gcr_checksum_error /= 15 then
          dbg_gcr_checksum_error <= dbg_gcr_checksum_error + 1;
        end if;
        if boot_sd_sec_read = '1' then
          boot_req_pend <= '1';
          boot_req_addr <= boot_sd_sec_read_addr;
        end if;

        case fast_state is
          when FAST_IDLE =>
            null;

          when FAST_WAIT =>
            -- (the byte captures themselves go through the single fast_buf /
            -- rmw_buf write ports above, gated by fb_sd_we / rmw_we)
            fast_wait_cnt <= fast_wait_cnt + 1;
            if sd_owner_fast = '1' and sd_xfer_busy = '1' then
              if sd_sec_read_valid = '1' then
                fast_raw_pos <= fast_raw_pos + 1;
              end if;
              if sd_sec_read_end = '1' then
                if fast_rmw = '1' then
                  -- Both halves assembled; request the block write.
                  fast_wrreq_pend <= '1';
                  fast_wr_idx <= (others => '0');
                  fast_wait_cnt <= (others => '0');
                  fast_state <= FW_WRITE;
                else
                  fast_ready <= '1';
                  fast_state <= FAST_IDLE;
                end if;
              end if;
            end if;
            if fast_wait_cnt = FAST_TIMEOUT then
              fast_error <= '1';
              fast_req_pend <= '0';
              fast_rmw <= '0';
              fast_state <= FAST_IDLE;
            end if;

          when FW_WRITE =>
            fast_wait_cnt <= fast_wait_cnt + 1;
            if sd_owner_fast = '1' and sd_xfer_busy = '1' and sd_xfer_write = '1' then
              if sd_wr_data_req = '1' then
                fast_wr_idx <= fast_wr_idx + 1;
              end if;
              if sd_wr_end = '1' then
                fast_ready <= '1';
                fast_rmw <= '0';
                -- Card refused the block (no data-response token, data
                -- rejected or busy timeout) -> report it on $DF0B bit3.
                if sd_cmd_error = '1' then
                  fast_error <= '1';
                end if;
                fast_state <= FAST_IDLE;
              end if;
            end if;
            if fast_wait_cnt = FAST_TIMEOUT then
              fast_error <= '1';
              fast_wrreq_pend <= '0';
              fast_rmw <= '0';
              fast_state <= FAST_IDLE;
            end if;
        end case;

        if exp2_we = '1' and exp2_addr = x"10" then
          drive_write_trace_addr <= exp2_wdata(4 downto 0);
          if exp2_wdata(7) = '1' then
            drive_write_trace_clear <= '1';
          end if;
        end if;

        if exp2_we = '1' and exp2_addr(7 downto 4) = "0000" then
          case to_integer(unsigned(exp2_addr(3 downto 0))) is
            when 0 => sd_mount_lba_reg(7 downto 0) <= exp2_wdata;
            when 1 => sd_mount_lba_reg(15 downto 8) <= exp2_wdata;
            when 2 => sd_mount_lba_reg(23 downto 16) <= exp2_wdata;
            when 3 => sd_mount_lba_reg(31 downto 24) <= exp2_wdata;
            when 4 =>
              if exp2_wdata(0) = '1' then
                sd_mount_strobe <= '1';
                sd_mounted <= '1';
                -- Latch the mount base: $DF00-$DF03 keeps changing afterwards
                -- (raw-read/-write LBA), the mounted image must not move.
                fast_mount_lba <= sd_mount_lba_reg;
              end if;
            when 15 =>
              if exp2_wdata(0) = '1' then
                dbg_wr_grant <= (others => '0');
                dbg_wr_done <= (others => '0');
                dbg_gcr_byte_seen <= (others => '0');
                dbg_gcr_commit <= (others => '0');
                dbg_gcr_block_done <= (others => '0');
                dbg_gcr_checksum_error <= (others => '0');
                dbg_sd_wr_end_any <= (others => '0');
                dbg_sd_wr_error <= (others => '0');
              end if;
            when 8 =>
              fast_track_reg <= exp2_wdata;
            when 9 =>
              fast_sector_reg <= exp2_wdata(4 downto 0);
            when 10 =>
              fast_offset_reg <= unsigned(exp2_wdata);
            when 11 =>
              if exp2_wdata(1) = '1' then
                fast_error <= '0';
              end if;
              if exp2_wdata(0) = '1' and fast_state = FAST_IDLE then
                fast_ready <= '0';
                -- Refuse to start while an aborted fastload transfer is
                -- still draining, so its tail cannot be mistaken for the
                -- new sector's data.
                if sd_init_done = '1' and sd_mounted = '1'
                   and fast_map_valid = '1'
                   and not (sd_xfer_busy = '1' and sd_owner_fast = '1') then
                  fast_req_addr <= std_logic_vector(unsigned(fast_mount_lba)
                                 + resize(unsigned(fast_map_index(9 downto 1)), 32));
                  fast_upper_half <= fast_map_index(0);
                  fast_req_pend <= '1';
                  fast_raw_pos <= (others => '0');
                  fast_wait_cnt <= (others => '0');
                  fast_error <= '0';
                  fast_state <= FAST_WAIT;
                else
                  fast_error <= '1';
                end if;
              end if;
            when 12 =>
              -- Fill the sector buffer for a following $DF0E write command
              -- (the actual store goes through the fast_buf write port above,
              -- gated by fb_cpu_we).
              null;
            when 13 =>
              -- Raw block read: LBA straight from $DF00-$DF03 instead of the
              -- track/sector map, so the mount guard does not apply here.
              if exp2_wdata(0) = '1' and fast_state = FAST_IDLE then
                fast_ready <= '0';
                if sd_init_done = '1'
                   and not (sd_xfer_busy = '1' and sd_owner_fast = '1') then
                  fast_req_addr <= sd_mount_lba_reg;
                  fast_upper_half <= exp2_wdata(1);
                  fast_req_pend <= '1';
                  fast_raw_pos <= (others => '0');
                  fast_wait_cnt <= (others => '0');
                  fast_error <= '0';
                  fast_state <= FAST_WAIT;
                else
                  fast_error <= '1';
                end if;
              end if;
            when 14 =>
              -- Sector/raw block write.  Both variants start with the RMW
              -- pre-read (fast_rmw='1'): the block is read once to capture the
              -- untouched 256-byte half, then written back with fast_buf in
              -- the selected half.
              if fast_state = FAST_IDLE then
                if exp2_wdata(0) = '1' then
                  -- write fast_buf to the mounted D64 at $DF08/$DF09
                  fast_ready <= '0';
                  if sd_init_done = '1' and sd_mounted = '1'
                     and fast_map_valid = '1'
                     and not (sd_xfer_busy = '1' and sd_owner_fast = '1') then
                    fast_req_addr <= std_logic_vector(unsigned(fast_mount_lba)
                                   + resize(unsigned(fast_map_index(9 downto 1)), 32));
                    fast_upper_half <= fast_map_index(0);
                    fast_rmw <= '1';
                    fast_req_pend <= '1';
                    fast_raw_pos <= (others => '0');
                    fast_wait_cnt <= (others => '0');
                    fast_error <= '0';
                    fast_state <= FAST_WAIT;
                  else
                    fast_error <= '1';
                  end if;
                elsif exp2_wdata(1) = '1' then
                  -- raw write of fast_buf into the block at $DF00-$DF03,
                  -- bit2 selects the half (counterpart of the $DF0D raw read)
                  fast_ready <= '0';
                  if sd_init_done = '1'
                     and not (sd_xfer_busy = '1' and sd_owner_fast = '1') then
                    fast_req_addr <= sd_mount_lba_reg;
                    fast_upper_half <= exp2_wdata(2);
                    fast_rmw <= '1';
                    fast_req_pend <= '1';
                    fast_raw_pos <= (others => '0');
                    fast_wait_cnt <= (others => '0');
                    fast_error <= '0';
                    fast_state <= FAST_WAIT;
                  else
                    fast_error <= '1';
                  end if;
                end if;
              end if;
            when others =>
              null;
          end case;
        end if;

        -- Grant the SD controller to one requester per whole transfer.
        -- The power-up boot loader goes first (the C64 is parked anyway),
        -- then the drive: the 1541 DOS is timing-sensitive while the
        -- fastload window simply polls a little longer.
        if sd_xfer_busy = '0' then
          if boot_req_pend = '1' then
            sd_issue_read <= '1';
            sd_issue_addr <= boot_req_addr;
            sd_owner_fast <= '0';
            sd_owner_boot <= '1';
            sd_xfer_write <= '0';
            sd_xfer_busy <= '1';
            boot_req_pend <= '0';
          elsif drive_req_pend = '1' then
            sd_issue_read <= '1';
            sd_issue_addr <= drive_req_addr;
            sd_owner_fast <= '0';
            sd_owner_boot <= '0';
            sd_xfer_write <= '0';
            sd_xfer_busy <= '1';
            drive_req_pend <= '0';
          elsif drive_wrreq_pend = '1' then
            sd_issue_write <= '1';
            sd_issue_addr <= drive_wrreq_addr;
            sd_owner_fast <= '0';
            sd_owner_boot <= '0';
            sd_xfer_write <= '1';
            sd_xfer_busy <= '1';
            drive_wrreq_pend <= '0';
            if dbg_wr_grant /= 15 then
              dbg_wr_grant <= dbg_wr_grant + 1;
            end if;
          elsif fast_req_pend = '1' then
            sd_issue_read <= '1';
            sd_issue_addr <= fast_req_addr;
            sd_owner_fast <= '1';
            sd_owner_boot <= '0';
            sd_xfer_write <= '0';
            sd_xfer_busy <= '1';
            fast_req_pend <= '0';
          elsif fast_wrreq_pend = '1' then
            sd_issue_write <= '1';
            sd_issue_addr <= fast_req_addr;
            sd_owner_fast <= '1';
            sd_owner_boot <= '0';
            sd_xfer_write <= '1';
            sd_xfer_busy <= '1';
            fast_wrreq_pend <= '0';
          end if;
        elsif (sd_xfer_write = '0' and sd_sec_read_end = '1')
           or (sd_xfer_write = '1' and sd_wr_end = '1') then
          sd_xfer_busy <= '0';
          -- Count only writes the card actually accepted; a rejected block
          -- (sd_cmd_error) keeps done behind grant, so $DF07 exposes it.
          if sd_xfer_write = '1' and sd_owner_fast = '0' and sd_owner_boot = '0'
             then
            if dbg_sd_wr_end_any /= 15 then
              dbg_sd_wr_end_any <= dbg_sd_wr_end_any + 1;
            end if;
            if sd_cmd_error = '1' then
              if dbg_sd_wr_error /= 15 then
                dbg_sd_wr_error <= dbg_sd_wr_error + 1;
              end if;
            elsif dbg_wr_done /= 15 then
              dbg_wr_done <= dbg_wr_done + 1;
            end if;
          end if;
        end if;
      end if;
    end if;
  end process;

  -- Standalone power-up loader: pulls the resident SD hook from the card
  -- (LBA 8, "C64HOOK1" header written by make_fat16_d64_card.py) into C64
  -- RAM while the CPU is parked, so no UART upload is needed. Disabled for
  -- the Python virtual-1541 variant so KERNAL LOAD uses the IEC path.
  gen_sd_hook_boot : if ENABLE_SD_HOOK_BOOT generate
    boot_i : entity work.c64_sd_hook_boot_loader
      generic map (
        HOOK_LBA => x"00000008",
        CLK_HZ   => 27_000_000
      )
      port map (
        clk     => clk_pix,
        reset_n => reset_n,
        sd_init_done           => sd_init_done,
        sd_sec_read            => boot_sd_sec_read,
        sd_sec_read_addr       => boot_sd_sec_read_addr,
        sd_sec_read_data       => sd_sec_read_data,
        sd_sec_read_data_valid => boot_sd_valid,
        sd_sec_read_end        => boot_sd_end,
        mem_we    => boot_mem_we,
        mem_addr  => boot_mem_addr,
        mem_wdata => boot_mem_wdata,
        active    => boot_active,
        done      => boot_done,
        status    => boot_status
      );
  end generate;

  gen_no_sd_hook_boot : if not ENABLE_SD_HOOK_BOOT generate
    boot_sd_sec_read <= '0';
    boot_sd_sec_read_addr <= (others => '0');
    boot_mem_we <= '0';
    boot_mem_addr <= (others => '0');
    boot_mem_wdata <= (others => '0');
    boot_active <= '0';
    boot_done <= '1';
    boot_status <= x"00";
  end generate;

  -- Boot-write shim: the boot loader emits one RAM write per SD byte; the
  -- c64_core monitor port wants a req/ready handshake. Queue a few bytes and
  -- replay them through the monitor port (which also parks the CPU via RDY,
  -- the native-core equivalent of the probe's whole-core pause).
  boot_owns <= '1' when boot_active = '1' or bq_cnt > 0 or bq_state /= BQ_IDLE
               else '0';
  core_mon_hold  <= boot_owns or mon_active;
  core_mon_req   <= '1' when bq_state = BQ_REQ else
                    (mon_mem_req and mon_active and not boot_owns);
  core_mon_we    <= '1' when boot_owns = '1' else mon_mem_we;
  core_mon_addr  <= bq_cur_addr when boot_owns = '1' else mon_mem_addr;
  core_mon_wdata <= bq_cur_data when boot_owns = '1' else mon_mem_wdata;
  mon_mem_ready  <= core_mon_ready when boot_owns = '0' else '0';

  process(clk_pix)
    variable cnt_v : integer range 0 to BQ_DEPTH;
  begin
    if rising_edge(clk_pix) then
      if reset_n = '0' then
        bq_cnt <= 0;
        bq_state <= BQ_IDLE;
      else
        cnt_v := bq_cnt;
        case bq_state is
          when BQ_IDLE =>
            if cnt_v > 0 then
              bq_cur_addr <= bq_addr(0);
              bq_cur_data <= bq_data(0);
              for i in 0 to BQ_DEPTH-2 loop
                bq_addr(i) <= bq_addr(i+1);
                bq_data(i) <= bq_data(i+1);
              end loop;
              cnt_v := cnt_v - 1;
              bq_state <= BQ_REQ;
            end if;
          when BQ_REQ =>
            bq_state <= BQ_WAIT;
          when BQ_WAIT =>
            if core_mon_ready = '1' then
              bq_state <= BQ_IDLE;
            end if;
        end case;
        if boot_mem_we = '1' and cnt_v < BQ_DEPTH then
          bq_addr(cnt_v) <= boot_mem_addr;
          bq_data(cnt_v) <= boot_mem_wdata;
          cnt_v := cnt_v + 1;
        end if;
        bq_cnt <= cnt_v;
      end if;
    end if;
  end process;

  sd_i : sd_card_top
    generic map (
      SPI_LOW_SPEED_DIV  => 268,
      SPI_HIGH_SPEED_DIV => 8
    )
    port map (
      clk                    => clk_pix,
      rst                    => not reset_n,
      SD_nCS                 => sd_ncs,
      SD_DCLK                => sd_dclk,
      SD_MOSI                => sd_mosi,
      SD_MISO                => sd_miso,
      sd_init_done           => sd_init_done,
      sd_sec_read            => sd_card_sec_read,
      sd_sec_read_addr       => sd_card_sec_read_addr,
      sd_sec_read_data       => sd_sec_read_data,
      sd_sec_read_data_valid => sd_sec_read_valid,
      sd_sec_read_end        => sd_sec_read_end,
      sd_sec_write           => sd_issue_write,
      sd_sec_write_addr      => sd_issue_addr,
      sd_sec_write_data      => sd_wr_data,
      sd_sec_write_data_req  => sd_wr_data_req,
      sd_sec_write_end       => sd_wr_end,
      debug_sec_state        => open,
      debug_cmd_state        => open,
      debug_cmd_error        => sd_cmd_error
    );

  -- HDMI TX also generates the system/pixel clocks from the 27 MHz oscillator.
  hdmi_i : entity work.tang20k_hdmi_tx
    generic map (
      HDMI_H_TOT   => 864,
      HDMI_V_TOT   => 625,
      HDMI_H_ACT   => 720,
      HDMI_V_ACT   => 576,
      HDMI_V_SYNC  => 581,
      HDMI_DI_LINE => 578,
      HDMI_AVI_576P => true
    )
    port map (
      clk_in   => clk_27mhz,
      reset_n  => '1',
      vga_de   => vga_de,
      vga_hs   => vga_hs,
      vga_vs   => vga_vs,
      vga_r    => vga_r,
      vga_g    => vga_g,
      vga_b    => vga_b,
      clk_sys  => clk_sys,
      clk_pix  => clk_pix,
      pll_lock => pll_lock,
      tmds_clk_p => tmds_clk_p,
      tmds_clk_n => tmds_clk_n,
      tmds_d_p   => tmds_d_p,
      tmds_d_n   => tmds_d_n
    );

  -- DDR3 controller + byte bridge. The c64_ddr core runs on clk_pix, so the
  -- bridge's sys side is clocked there; the Gowin app side uses clk_x1.
  ddr_cs     <= '0';
  app_addr28 <= '0' & app_addr27;

  ddr_reset_seq : process(clk_27mhz)
  begin
    if rising_edge(clk_27mhz) then
      ddr_lock_sync <= ddr_lock_sync(0) & ddr_pll_lock;
      ddr_cal_sync  <= ddr_cal_sync(0)  & ddr_calib_complete;

      if ddr_lock_sync(1) = '0' then
        ddr_rst_state <= DR_ASSERT;
        ddr_rst_cnt   <= 0;
        ddr_rst_n     <= '0';
      else
        case ddr_rst_state is
          when DR_ASSERT =>
            ddr_rst_n <= '0';
            if ddr_rst_cnt = DDR_RST_HOLD then
              ddr_rst_cnt   <= 0;
              ddr_rst_n     <= '1';
              ddr_rst_state <= DR_WAIT_CAL;
            else
              ddr_rst_cnt <= ddr_rst_cnt + 1;
            end if;

          when DR_WAIT_CAL =>
            ddr_rst_n <= '1';
            if ddr_cal_sync(1) = '1' then
              ddr_rst_cnt <= 0;
            elsif ddr_rst_cnt = DDR_CAL_WAIT then
              ddr_rst_cnt   <= 0;
              ddr_rst_state <= DR_ASSERT;
            else
              ddr_rst_cnt <= ddr_rst_cnt + 1;
            end if;
        end case;
      end if;
    end if;
  end process;

  ddr_mem_pll_i : Gowin_rPLL
    port map (
      clkout => ddr_memory_clk,
      lock   => ddr_pll_lock,
      reset  => '0',
      clkin  => clk_27mhz
    );

  ddr3_ip_i : DDR3_Memory_Interface_Top
    port map (
      clk                 => clk_27mhz,
      memory_clk          => ddr_memory_clk,
      pll_lock            => ddr_pll_lock,
      rst_n               => ddr_rst_n,
      app_burst_number    => (others => '0'),
      cmd_ready           => app_cmd_rdy,
      cmd                 => app_cmd,
      cmd_en              => app_cmd_en,
      addr                => app_addr28,
      wr_data_rdy         => app_wdata_rdy,
      wr_data             => app_wdata,
      wr_data_en          => app_wren,
      wr_data_end         => app_wdata_end,
      wr_data_mask        => app_wdata_mask,
      rd_data             => app_rdata,
      rd_data_valid       => app_rdata_valid,
      rd_data_end         => open,
      sr_req              => '0',
      ref_req             => '0',
      sr_ack              => open,
      ref_ack             => open,
      init_calib_complete => ddr_calib_complete,
      clk_out             => ddr_clk_x1,
      ddr_rst             => open,
      burst               => '1',
      O_ddr_addr          => ddr_addr,
      O_ddr_ba            => ddr_bank,
      O_ddr_cs_n          => open,
      O_ddr_ras_n         => ddr_ras,
      O_ddr_cas_n         => ddr_cas,
      O_ddr_we_n          => ddr_we,
      O_ddr_clk           => ddr_ck,
      O_ddr_clk_n         => ddr_ck_n,
      O_ddr_cke           => ddr_cke,
      O_ddr_odt           => ddr_odt,
      O_ddr_reset_n       => ddr_reset_n,
      O_ddr_dqm           => ddr_dm,
      IO_ddr_dq           => ddr_dq,
      IO_ddr_dqs          => ddr_dqs,
      IO_ddr_dqs_n        => ddr_dqs_n
    );

  ddr_bridge_i : entity work.ddr3_byte_bridge
    generic map (ADDR_BITS => 16, MASK_BIT_MASKS => true)
    port map (
      clk_sys   => clk_pix,
      rst_sys_n => pll_lock,
      req       => c64_ram_req,
      we        => c64_ram_we,
      addr      => c64_ram_addr,
      din       => c64_ram_din,
      dout      => c64_ram_dout,
      ack       => c64_ram_ack,
      ram_ready => ram_ready,

      ram_test_active    => ram_test_active,
      ram_test_done      => ram_test_done,
      ram_test_error     => ram_test_error,
      ram_test_phase     => ram_test_phase,
      ram_test_addr      => ram_test_addr,
      ram_test_fail_addr => ram_test_fail_addr,
      ram_test_expected  => ram_test_expected,
      ram_test_actual    => ram_test_actual,

      clk_x1              => ddr_clk_x1,
      init_calib_complete => ddr_calib_complete,
      dbg_pll_lock        => ddr_pll_lock,
      app_cmd             => app_cmd,
      app_cmd_en          => app_cmd_en,
      app_cmd_rdy         => app_cmd_rdy,
      app_addr            => app_addr27,
      app_wren            => app_wren,
      app_wdata           => app_wdata,
      app_wdata_end       => app_wdata_end,
      app_wdata_mask      => app_wdata_mask,
      app_wdata_rdy       => app_wdata_rdy,
      app_rdata           => app_rdata,
      app_rdata_valid     => app_rdata_valid
    );

  -- The C64 itself, clocked by the 27 MHz pixel clock (PHI2_DIV=27 -> ~1 MHz CPU,
  -- authentic C64 speed; the half-speed test (54) proved the hang is NOT a setup-
  -- margin path, so back to the correct rate).
  c64_i : entity work.c64_core_ddr
    generic map (
      -- true  = vic_ii_xl: cycle-based 6569 (badlines, border flip-flops,
      --         YSCROLL/RSEL, mid-line register effects, sprite Y-crunch,
      --         collision IRQs). In this DDR fork it reads the local 16K VIC
      --         shadow instead of touching DDR directly.
      -- false = simple line-buffer VIC for early bring-up.
      VIC_XL => true,
      IEC_BUS_MODEL => true,
      MISTER_1541_ENABLE => true,
      MISTER_1541_BACKEND => C64_DRIVE_BACKEND,
      MISTER_1541_BAUD => 230400,
      MISTER_1541_SD_WRITE => C64_DRIVE_SD_WRITE,
      HOST_UART_ENABLE => false
    )
    port map (
      clk      => clk_pix,
      reset_n  => c64_reset_n,
      cold_reset => cold_reset,
      sd_init_done           => sd_init_done,
      sd_sec_read            => drive_sd_sec_read,
      sd_sec_read_addr       => drive_sd_sec_read_addr,
      sd_sec_read_data       => sd_sec_read_data,
      sd_sec_read_data_valid => drive_sd_sec_read_valid,
      sd_sec_read_end        => drive_sd_sec_read_end,
      sd_sec_write           => drive_sd_sec_write,
      sd_sec_write_addr      => drive_sd_sec_write_addr,
      sd_sec_write_data      => drive_sd_sec_write_data,
      sd_sec_write_data_req  => drive_sd_wr_data_req,
      sd_sec_write_end       => drive_sd_wr_end,
      sd_mount_lba           => sd_mount_lba_reg,
      sd_mount_strobe        => sd_mount_strobe,
      drive_act_led          => drive_led,
      drive_read_active      => drive_read_active,
      drive_write_active     => drive_write_active,
      drive_write_byte_pulse   => drive_write_byte_pulse,
      drive_write_commit_pulse => drive_write_commit_pulse,
      drive_write_block_done_pulse => drive_write_block_done_pulse,
      drive_write_checksum_error_pulse => drive_write_checksum_error_pulse,
      drive_write_checksum_calc => drive_write_checksum_calc,
      drive_write_checksum_recv => drive_write_checksum_recv,
      drive_write_prev_data => drive_write_prev_data,
      drive_write_last_data => drive_write_last_data,
      drive_write_debug => drive_write_debug,
      drive_write_trace_addr => drive_write_trace_addr,
      drive_write_trace_data => drive_write_trace_data,
      drive_write_trace_count => drive_write_trace_count,
      drive_write_trace_clear => drive_write_trace_clear,
      exp2_cs    => exp2_cs,
      exp2_we    => exp2_we,
      exp2_addr  => exp2_addr,
      exp2_wdata => exp2_wdata,
      exp2_rdata => exp2_rdata,
      dbg_addr => dbg_addr,
      dbg_we   => dbg_we,
      dbg_do   => dbg_do,
      dbg_di   => dbg_di,
      dbg_sync => dbg_sync,
      dbg_phi  => dbg_phi,
      dbg_status => dbg_status,
      dbg_cia1 => dbg_cia1,
      dbg_iec => dbg_iec,
      dbg_regs => dbg_regs,
      -- dbg_cia1_irq => open,   -- (DIAG heartbeat tap -- disabled)
      vga_hs   => vga_hs,
      vga_vs   => vga_vs,
      vga_de   => vga_de,
      vga_r    => vga_r,
      vga_g    => vga_g,
      vga_b    => vga_b,
      ps2_clk  => ps2_clk,
      ps2_data => ps2_data,
      audio    => audio,
      uart_tx  => c64_disk_uart_tx,
      uart_rx  => uart_rx,
      monitor_hold      => core_mon_hold,
      monitor_mem_req   => core_mon_req,
      monitor_mem_we    => core_mon_we,
      monitor_mem_addr  => core_mon_addr,
      monitor_mem_wdata => core_mon_wdata,
      monitor_mem_rdata => mon_mem_rdata,
      monitor_mem_ready => core_mon_ready,
      ext_ram_req       => c64_ram_req,
      ext_ram_we        => c64_ram_we,
      ext_ram_addr      => c64_ram_addr,
      ext_ram_din       => c64_ram_din,
      ext_ram_dout      => c64_ram_dout,
      ext_ram_ack       => c64_ram_ack,
      ext_ram_ready     => ram_ready
    );

  dbg_uart_i : entity work.c64_dbg_uart
    generic map (CLK_HZ => 27_000_000, BAUD => 115_200)
    port map (
      clk        => clk_pix,
      reset_n    => reset_n,
      snp_addr   => dbg_addr,
      snp_we     => dbg_we,
      snp_do     => dbg_do,
      snp_di     => dbg_di,
      snp_sync   => dbg_sync,
      snp_phi    => dbg_phi,
      snp_status => dbg_status,
      snp_cia1   => dbg_cia1,
      snp_regs   => dbg_regs,
      uart_tx    => dbg_uart_tx
    );

  gen_no_monitor : if not ENABLE_UART_MONITOR generate
    mon_rx_data  <= (others => '0');
    mon_rx_valid <= '0';
    mon_tx_busy  <= '0';
    mon_uart_tx  <= '1';
    mon_active   <= '0';
    mon_mem_req  <= '0';
    mon_mem_we   <= '0';
    mon_mem_addr <= (others => '0');
    mon_mem_wdata <= (others => '0');
  end generate;

  gen_monitor : if ENABLE_UART_MONITOR generate

  mon_rx_i : entity work.uart_rx_ser
    generic map (CLK_HZ => 27_000_000, BAUD => 115_200)
    port map (
      clk     => clk_pix,
      reset_n => reset_n,
      rx      => uart_rx,
      data    => mon_rx_data,
      valid   => mon_rx_valid
    );

  mon_tx_i : entity work.uart_tx_ser
    generic map (CLK_HZ => 27_000_000, BAUD => 115_200)
    port map (
      clk     => clk_pix,
      reset_n => reset_n,
      data    => mon_tx_data,
      valid   => mon_tx_valid,
      tx      => mon_uart_tx,
      busy    => mon_tx_busy
    );

  -- A magic sequence acts as a soft monitor button. It must be longer than one
  -- byte because normal C64 mode now uses the same UART for arbitrary binary
  -- PRG/D64 traffic, and a single wake byte can naturally occur in game data.
  process(clk_pix)
  begin
    if rising_edge(clk_pix) then
      mon_enter <= '0';
      if reset_n = '0' or mon_active = '1' then
        mon_magic_idx <= 0;
      elsif mon_rx_valid = '1' then
        case mon_magic_idx is
          when 0 =>
            if mon_rx_data = MONITOR_MAGIC0 then
              mon_magic_idx <= 1;
            else
              mon_magic_idx <= 0;
            end if;
          when 1 =>
            if mon_rx_data = MONITOR_MAGIC1 then
              mon_magic_idx <= 2;
            elsif mon_rx_data = MONITOR_MAGIC0 then
              mon_magic_idx <= 1;
            else
              mon_magic_idx <= 0;
            end if;
          when 2 =>
            if mon_rx_data = MONITOR_MAGIC2 then
              mon_magic_idx <= 3;
            elsif mon_rx_data = MONITOR_MAGIC0 then
              mon_magic_idx <= 1;
            else
              mon_magic_idx <= 0;
            end if;
          when others =>
            if mon_rx_data = MONITOR_MAGIC3 then
              mon_enter <= '1';
            end if;
            mon_magic_idx <= 0;
        end case;
      end if;
    end if;
  end process;

  -- Small PRG upload monitor from the MiSTer probe (L aaaa / . / G), here
  -- with the M aaaa bbbb hex dump enabled (reads RAM under ROM/I/O through
  -- the same monitor memory port).
  monitor_i : entity work.c64_prg_upload_monitor
    generic map (ENABLE_DUMP => true)
    port map (
      clk       => clk_pix,
      reset_n   => reset_n,
      enter_btn => mon_enter,
      rx_data   => mon_rx_data,
      rx_valid  => mon_rx_valid,
      tx_busy   => mon_tx_busy,
      tx_data   => mon_tx_data,
      tx_valid  => mon_tx_valid,
      active    => mon_active,
      mem_req   => mon_mem_req,
      mem_we    => mon_mem_we,
      mem_addr  => mon_mem_addr,
      mem_wdata => mon_mem_wdata,
      mem_rdata => mon_mem_rdata,
      mem_ready => mon_mem_ready
    );

  end generate;

  -- Audio DAC (PT8211), pixel-clock domain (BCK_HALF=4 -> ~27/8 MHz BCK).
  dac_i : entity work.pt8211_dac
    generic map (BCK_HALF => 4)
    port map (
      clk     => clk_pix,
      reset_n => reset_n,
      sample  => audio,
      dac_bck => dac_bck,
      dac_ws  => dac_ws,
      dac_din => dac_din
    );
end architecture;
