rudolfstepan/6502-sbc-fpga/boards/tang_primer_20k/mister_c64_probe/rtl/sid_top_stub.sv

module sid_top
#(
	parameter MULTI_FILTERS = 1,
	parameter DUAL = 1,
	parameter N = DUAL ? 2 : 1
)
(
	input         reset,
	input         clk,
	input         ce_1m,

	input [N-1:0] cs,
	input         we,
	input   [4:0] addr,
	input   [7:0] data_in,
	output  [7:0] data_out,

	input  [12:0] fc_offset_l,
	input   [7:0] pot_x_l,
	input   [7:0] pot_y_l,
	input  [17:0] ext_in_l,
	output [17:0] audio_l,

	input  [12:0] fc_offset_r,
	input   [7:0] pot_x_r,
	input   [7:0] pot_y_r,
	input  [17:0] ext_in_r,
	output [17:0] audio_r,

	input [N-1:0] filter_en,
	input [N-1:0] mode,
	input [(N*2)-1:0] cfg,

	input         ld_clk,
	input  [11:0] ld_addr,
	input  [15:0] ld_data,
	input         ld_wr
);

assign data_out = 8'hFF;
assign audio_l = 18'd0;
assign audio_r = 18'd0;

endmodule
