rudolfstepan/6502-sbc-fpga/(commit log)

2026-06-04 docs(fpga): add comprehensive inline documentation to VHDL modules
    Add detailed inline documentation to all FPGA RTL modules (excluding T65 core),
    explaining architecture, functionality, and implementation details:
    - sbc_pkg: Memory map definitions and address range constants
    - bus_decode: Address-to-device mapping logic
    - sync_ram/rom: Memory read/write operations and initialization
    - via6522: 16-bit timers, parallel I/O, interrupt handling
    - uart6551: Serial communications with RX/TX buffering
    - t65_adapter: CPU core integration and signal mapping
    - cpu6502_slot: Test-mode CPU with instruction decoder
    - sbc_top/sbc_t65_top: System integration with peripheral connections
    Documentation inc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
2026-06-04 docs(fpga): create comprehensive structured documentation
    Add complete FPGA documentation suite in fpga/docs/:
    - INDEX.md: Navigation guide and quick links for all documentation
    - 01_ARCHITECTURE.md: System design, memory map, block diagrams, clocking
    - 02_MODULES.md: Module hierarchy, entity specifications, dependencies
    - 03_BUILDING.md: Build instructions, ROM conversion, FPGA synthesis
    - 04_TESTING.md: Test suite overview, running tests, structure
    - 05_COMPONENTS.md: Detailed component specs (VIA, UART, memory)
    - 06_SIMULATION.md: Advanced simulation, waveform analysis, debugging
    - 07_DEVELOPMENT.md: Coding standards, workflow, contribution guide
    Documentation covers:
    - System architect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
2026-06-04 docs(tier1): create detailed implementation plan for Tier 1 features
    Add comprehensive plan for Tier 1 (Critical Path) implementation:
    - Fix T65 Indirect Addressing (2 weeks)
    - Implement VIC Text Mode Display (3-4 weeks)
    - Complete UART Implementation (2-3 weeks)
    Each feature includes:
    - Problem statement and root cause analysis
    - Step-by-step implementation guide
    - Code examples and pseudocode
    - Testing strategy and success criteria
    - Timeline estimates
    - Risk assessment and mitigation
    Total estimated effort: 4-6 weeks
    Sequential implementation (each unblocks next)
    Ready to begin development.
2026-06-04 docs(t65-fix): add detailed analysis and diagnostic testbench
    Add comprehensive root cause analysis:
    - Diagnostic testbench showing CPU execution trace
    - Confirmed that 0x91 (STA \,Y) is SKIPPED
    - CPU jumps from C00C directly to C00E without executing indirect-Y write
    - Zero page setup works correctly (\=00, \=80)
    - VIC write to 0x8000 NEVER occurs
    Key finding: T65 core DOES support 0x91 opcode
    - Verified in T65_MCode.vhd lines 833-869
    - Indirect-Y addressing is implemented
    - Issue must be in adapter or signal timing
    Next: Investigate VDA signal and T65 read data path timing
2026-06-04 fix(t65): resolve indirect addressing read data corruption in SRAM module
    The T65 CPU indirect addressing mode was failing because zero page reads
    during multi-cycle instructions were returning undefined data. Root cause
    analysis identified that the sync_ram.vhd module had conflicting drivers:
    both a synchronous clocked process and a combinational asynchronous process
    were attempting to drive the dout signal simultaneously, causing signal
    corruption.
    Fixed by restructuring the memory module to use generate statements that
    ensure only ONE process drives dout at a time:
    - When ASYNC_READ=false: only synchronous process drives dout
    - When ASYNC_READ=true: only combinational process drives dout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
    [sync_ram.vhd]
2026-06-04 fix: correct VIC_BLIT address range constant in sbc_pkg.vhd
    Fixed typo in ADDR_VIC_BLIT_LAST: was 0x844F (33871), should be 0x884F (34895).
    The range 0x8840-0x844F was backwards (end address less than start address).
    Correct range is 0x8840-0x884F for 16-byte VIC blitter block.
    This was causing all address decode tests to fail for VIC_BLIT address block.
    All make test tests now pass successfully.
    [sbc_pkg.vhd]
2026-06-04 feat(uart): implement baud rate generator for UART6551
    Added Phase 1 of Feature 3 implementation:
    - Configurable baud rate clock divider (300-115200 baud)
    - 16x oversampling for serial data timing
    - Baud rate selection via CTRL register bits [3:0]
    - Support for standard baud rates with 100 MHz system clock
    Baud rate divider values calculated for 100 MHz clock:
    - 300 baud: divider=20833
    - 1200 baud: divider=5208
    - 9600 baud: divider=651 (default)
    - 115200 baud: divider=54
    Backward compatible with existing UART interface and register layout.
    All existing tests pass - no regressions.
    Baud rate generator tested and verified with dedicated testbench.
    Ready for Phase 2: Data format configuratio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
2026-06-04 feat(uart): add data format configuration (Phase 2)
    Implemented Phase 2 of UART Feature 3:
    - Support for configurable data lengths (5/6/7/8 bits)
    - Data format selection via CTRL register bits [1:0]:
    - 00 = 5 bits
    - 01 = 6 bits
    - 10 = 7 bits
    - 11 = 8 bits (default)
    - Helper function to calculate data length from CTRL
    - Data length signal updated when CTRL register changes
    - Compatible with Phase 1 baud rate configuration
    Data format can be combined with baud rate selection:
    - CTRL[1:0] = data format
    - CTRL[3:2] = baud rate selection
    Comprehensive testbench covers:
    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
2026-06-04 feat(uart): add parity support infrastructure (Phase 3)
    Implemented Phase 3 of UART Feature 3:
    - Parity generation function (odd/even)
    - Parity error detection on RX
    - Parity enable/disable control
    - Stop bits configuration (1 or 2 bits)
    - Configuration via CTRL register
    CTRL Register Final Layout:
    - CTRL[7:6] = Parity type (00=odd, 01=even)
    - CTRL[5] = Parity enable (0=off, 1=on)
    - CTRL[4] = Stop bits (0=1 stop, 1=2 stop)
    - CTRL[3:2] = Baud rate selection
    - CTRL[1:0] = Data length (00=5, 01=6, 10=7, 11=8 bits)
    Implementation Details:
    - calc_parity_8bit: Calculates parity for bits 0-6
    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
2026-06-04 feat(uart): add serial communication testbench for Feature 3
    Completes Feature 3 (Complete UART Implementation) with comprehensive
    testbench for realistic serial scenarios: configuration, transmit/receive,
    baud rate changes, reset, and TDRE flag verification. All 6 core scenarios
    pass (TX ready check is one-cycle pulse). Validates 8N1@115200, 7-bit@9600,
    19200@baud, and configuration persistence.
    All 13 existing system tests pass + serial communication test suite.
2026-06-04 feat(vic): implement VIC core module (Phase 1) for Feature 2
    Implements VIC core with text RAM (0x8000-0x87FF), color RAM (0x8800-0x88FF),
    and control registers (0x9000-0x900F). Replaces generic register stub with
    proper memory-backed implementation for 40×25 character text display.
    - Text RAM: 2KB for character codes (40×25 grid)
    - Color RAM: 256B for optional color information
    - Control Registers: 16 registers for display configuration
    - 0x9000: Horizontal scroll
    - 0x9001: Vertical scroll
    - 0x9002: Raster compare for interrupt
    - 0x9003: Mode register (display enable, interrupt control)
    - 0x9004: Color configuration
    - Comprehensive testbench verifying all memory regions
    All ex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
2026-06-04 feat(vic): implement character ROM (Phase 2) for Feature 2
    Creates ASCII character font ROM with 8x8 pixel patterns for 128 characters
    (0x00-0x7F). Includes standard printable ASCII characters, punctuation, and
    control characters. Combinational ROM with async read for zero latency.
    - 128 characters × 8 rows × 1 byte = 1KB ROM
    - Addressing: addr[9:3] = char code, addr[2:0] = pixel row
    - Output: 8-bit pixel data (one horizontal line of character)
    - Standard 8x8 bitmap patterns for legible rendering
    Character ROM testbench passes all 6 test suites:
    - Space character (blank)
    - 'A' character pattern
    - 'B' character pattern
    - '0' character pattern
    - DEL character (filled block)
    - Addressing ve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
2026-06-04 feat(vic): implement pixel generator (Phase 3) for Feature 2
    Creates pixel generator for VGA 640x480@60Hz output with 40x25 character grid.
    Generates video timing, maps pixel coordinates to character positions, reads
    text/color RAM and character ROM to produce pixel output stream.
    Key features:
    - VGA timing generation: 640x480 @ 60Hz with proper H/V sync signals
    - Pixel clock divider: 100 MHz → 25 MHz (÷4)
    - Character grid mapping: Converts pixel coordinates to 40x25 character grid
    - RAM address generation for text and color information
    - Character ROM lookup: Reads 8x8 character patterns
    - Combinational pixel output: White (0xFF) or black (0x00)
    - Wrapping address calculation to handle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
2026-06-04 fix: remove infinite waits from all testbenches to allow clean exit
    Testbenches were hanging due to:
    1. Infinite 'wait;' statements at end of test processes
    2. Combinational tests without termination (tb_bus_decode)
    Fixed by:
    - Removing infinite 'wait;' statements from testbenches
    - Adding 'finish;' statement to combinational tests
    - Using 'stop;' for tests with explicit termination
    Allows make test to complete and exit cleanly without hanging.
    [tb_bus_decode.vhd]
2026-06-04 fix: add finish statements to remaining testbenches
    Ensures all testbenches terminate properly:
    - tb_vic_core: Added finish to prevent test loop
    - tb_char_rom: Added finish to prevent test loop
    - tb_uart6551_*.vhd: Added finish for all UART tests
    - tb_vic_pixel_gen: Added finish to prevent infinite run
    Allows complete test suite to exit cleanly without hanging.
2026-06-04 feat(vic): implement raster interrupt (Phase 4) for Feature 2
    Adds raster line comparison and interrupt generation to VIC core:
    - Raster interrupt fires when current video line matches configured line
    - Supports enabling/disabling via MODE register bit 5
    - Raster line set via RASTER_CMP register (0x9002)
    - Interrupt flag cleared by reading STATUS register
    - Includes edge-detection logic to generate clean interrupt pulse
    Testbench validates:
    - Raster compare register configuration (0-255 line range)
    - MODE register raster IRQ enable/disable
    - Register read/write functionality
    - Configuration persistence
    All 6 raster interrupt tests pass.
    Feature 2 Progress: Phases 1-4 complete, Phase 5 pen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
2026-06-04 feat(vic): implement integration tests (Phase 5) for Feature 2 - COMPLETE
    Creates comprehensive integration test validating complete VIC display system:
    - VIC core with text/color RAM
    - Character ROM with ASCII font patterns
    - Pixel generator with VGA timing (640×480@60Hz)
    - Raster interrupt system
    Integration test validates:
    - Text RAM initialization and reading ('HELLO' example)
    - Display mode configuration (text mode, display on)
    - Raster interrupt setup
    - Pixel valid signal generation
    - Character ROM accessibility
    - VGA H/V sync signal generation
    All 7 integration tests pass.
    Feature 2 COMPLETE: All 5 phases fully implemented and tested.
    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
2026-06-04 feat(hardware): Add PIX16 Spartan-6 FPGA board support with VGA display
    - Created constraint file with pin assignments for XC6SLX9-2FTG256 board
    - Added pix16_board integration layer connecting VIC core to hardware I/O
    - Created pix16_top hierarchical wrapper for ISE implementation
    - Extended sbc_pkg with text_ram_t and color_ram_t type definitions
    - Updated Makefile with hardware build targets
    - Added comprehensive build documentation (BUILD_PIX16.md, HARDWARE_SUPPORT.md)
    - Created ISE project creation script for automated setup
    - Test pattern output configured (white display during active video area)
    - SDRAM interface pins mapped, controller stub ready for future implementation
    - Verified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
2026-06-05 feat(pix16): add button test harness and fix UCF pin assignments
    Replace cpu6502_slot+ROM bus master with test_runner module that maps
    the 4 on-board buttons to distinct display test routines:
    key[0] - Welcome message (clear + centered text)
    key[1] - Clear screen
    key[2] - Cycle all printable ASCII chars across screen
    key[3] - 6x16 character table
    Fix button pin constraints (C3/D3/E4/E3) taken from board manufacturer
    demo project 02_key_test; previous assignments (C12/P13/T14/R14) were
    incorrect for the FTG256 package and had been left commented out.
    test_runner includes 20 ms debounce and auto-runs welcome on power-up.
2026-06-05 add M25P16 SPI flash PROM files for persistent FPGA configuration
    Generated from pix16_top.bit via iMPACT PROM File Formatter (SPI Flash,
    16Mbit). Programs to 25P16V on-board SPI flash so the XC6SLX16 loads
    its bitstream automatically on power-up without JTAG.
2026-06-05 feat(pix16): minimal 6502 SBC with bus-stealing VIC and C64-style welcome screen
    Replace dual-port VIC architecture with a single-port VRAM design where the VIC
    steals 40 bus cycles per H-blank to prefetch characters into a line buffer,
    halting the T65 CPU via the RDY pin (2.5% overhead). This eliminates the
    Spartan-6 dual-port block RAM inference issue that produced no VGA signal.
    - vic_vga.vhd: new VIC combining bus-steal FSM, line buffer, char rendering,
    VGA timing (640x480 @60Hz) and RGB output in a single module
    - sbc_minimal_top.vhd: CPU + 4KB SRAM + 2KB VRAM (single-port, bus-muxed)
    + 2KB ROM + vic_vga; exposes VGA ports directly
    - pix16_sbc_minimal_top.vhd: thin PIX16 board wrap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
    [sbc_minimal_top.vhd, t65_adapter.vhd, vic_vga.vhd]
2026-06-05 feat(sbc): add VIA 6522 + UART 6551 with timer-driven IRQ display demo
    VIA Timer 1 fires every ~1.3 ms (period $FFFF at 50 MHz). Every 256 IRQs
    (~330 ms) the ISR increments a tick counter, writes two hex digits to VIC
    row 8, sends the byte via UART TX, and toggles VIA Port B bit 0 (LED blink).
    Assembly toolchain (ca65/ld65 from cc65):
    - fpga/asm/rom_demo.s clean 6502 assembly source
    - fpga/asm/rom_demo.cfg ld65 linker config (2 KB ROM at $F800)
    - fpga/asm/bin_to_fpga_hex.py binary -> FPGA sim hex converter
    - fpga/asm/Makefile build + install to fpga/sim/rom_welcome.hex
    VHDL changes:
    - sbc_minimal_top: add via6522 + uart6551, wire IRQ, expose via_portb
    - pix16_sbc_minimal_top: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
    [rom_demo.cfg]
2026-06-05 docs(fpga): update architecture and modules for VIA+UART+IRQ demo and asm toolchain
2026-06-05 feat(sbc): add SDRAM + UART diagnostics via USB (CH340C)
    SDRAM (32 KB at $0000-$7FFF):
    - sdram_ctrl.vhd VHDL SDRAM controller (50 MHz, CAS=3, refresh 7.5 us)
    + ctrl_idle output signals when controller is in S_IDLE
    - sdram_if.vhd 6502 single-byte bus adapter; waits for ctrl_idle before
    starting or completing any access — prevents deadlock during 300 us init
    and after write recovery (S_TWR/S_PRE/S_TRP)
    - sbc_sdram_top.vhd system top with 32 KB SDRAM, VRAM, VIC, VIA, UART
    - pix16_sbc_sdram_top.vhd PIX16 board wrapper; ODDR2 for sdram_clk
    UART diagnostics (115200 8N1):
    - uart_tx_ser.vhd 8N1 baud-rate serializer (50 MHz / 115200 = 434 div)
    - Both pix16_sbc_minimal_top and pix16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
    [sbc_sdram_top.vhd, sdram_ctrl.vhd, uart_tx_ser.vhd]
2026-06-05 added UART receiver peripheral, and updated the ROM demo to use it. Also updated the welcome message in the ROM to reflect the new capabilities of the system.
2026-06-05 Add UART reset diagnostics
    Emit reset-time system/debug information over UART before enabling IRQs,
    including memory map, UART/VIA status, timer config, and zero-page state.
    Wire UART TX busy back into the 6551 so TDRE reflects serializer readiness,
    preventing dropped characters during multi-line debug output. Regenerate the
    FPGA ROM hex with the updated monitor code.
    [sbc_minimal_top.vhd, sbc_sdram_top.vhd]
2026-06-05 Stabilize reset diagnostics and memory
    Route zero page and stack through internal FPGA RAM in the minimal and SDRAM top-levels so critical 6502 stack, IRQ, and zero-page traffic avoids the external/main RAM path.
    Extend the reset ROM diagnostics with a quick UART-reported system check for ZP, stack, RAM, VRAM, VIA, and UART state. Regenerate rom_welcome.hex and include the generated UART keyboard PROM artifacts.
    Update FPGA architecture, module, and PIX16 build documentation to describe the internal ZP/stack RAM, reset diagnostics, and expected console self-test output.
    [sbc_minimal_top.vhd, sbc_sdram_top.vhd]
2026-06-06 feat(fpga): add SD card bootloader for PIX16 SBC
    Load the SBC firmware image from the PIX16 SD card socket into a
    16 KB writable shadow-ROM RAM at power-up, keeping the FPGA bitstream
    stable and firmware upgradeable without re-synthesis.
    New RTL modules:
    - rtl/boot/sd_rom_loader.v - SPI SD sector reader, fills shadow RAM
    - rtl/boot/boot_debug_uart.vhd - UART TX debug output during boot
    - rtl/mem/boot_shadow_rom.vhd - 16 KB RAM that overlays the ROM window
    - rtl/mem/sdram_if.vhd / sdram_ctrl.vhd - SDRAM interface and controller
    - rtl/sbc_t65_boot_top.vhd - SBC top with shadow-ROM boot path
    - rtl/sbc_t65_sdram_boot_top.vhd - variant with SDRAM
    - rtl/boards/pix16_sbc_sd_boot_top.v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
2026-06-06 fixed ram bug, implemented debug screen on vga
    [boot_vga_debug.vhd, sbc_t65_sdram_boot_top.vhd]
2026-06-07 added new features. uart debug monitor and much more. please look into the doku for more details what has been changed now.
2026-06-07 many bug fixed with the memory controller, ehabasic sliptream rom... system set to 230k baud rate. doku still not updated yet!
    [diag_sdram.cfg, ehbasic_fpga.cfg]
2026-06-07 fix(fpga/ehbasic): fix SCROLL infinite-loop and STRPTR ZP collision
    SCROLL exited with X=COLS=40; CHROUT stored that into CURSOR_X, causing
    every subsequent character output to immediately retrigger a scroll.
    This manifested as VGA freezing after ~18 rows, UART missing LF, and
    FOR-loop values corrupted by EhBASIC Decss ($EF-$F4) overwriting the
    kernel STRPTR_HI which was placed at $EF.
    - SCROLL now saves/restores A, X, Y
    - STRPTR_LO moved $EE->$EB, STRPTR_HI moved $EF->$EE (clear of Decss)
    - ZP layout comment in kernel.s header corrected
    - roms/kernel.rom rebuilt from fixed kernel.s source
    - fpga/asm/Makefile: added `kernel` target; fpga-ehbasic/upload-ehbasic
    now depend on $(KERNEL_ROM)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
2026-06-08 add PETSCII block-graphics support and fix lowercase/PETSCII char_rom conflict
    - char_rom ($60-$7F): 32 PETSCII block/line graphics (bars, corners,
    T-pieces, diagonals, quadrants, arrows, full block)
    - gen_petscii_char_rom.py: new tool to regenerate char_rom.vhd from Python
    - boot_vga_debug.vhd: row 22 displays all 32 PETSCII glyphs as live test
    - rom_demo.s: PETSCII demo at row 1 (codes $60-$7F, cols 4-35); fix '@'
    artifacts by clearing all 9 header rows before string writes
    - upload_rom_demo.py: new UART monitor upload script for rom_demo.bin
    - Makefile: add upload-demo and sd-ehbasic targets
    - build_fpga_ehbasic.py: --sd-image flag produces fpga_ehbasic_16kb.img
    (raw SD boot image: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
    [boot_vga_debug.vhd, char_rom.vhd, vic_vga.vhd]
2026-06-13 refresh contributor data and clean up staging
    - Commit staged PETSCII graphics files and support configs
    - Update gitignore
    - Force GitHub contributor cache refresh
2026-06-14 restructure fpga/ for multi-board support (PIX16 + Tang Primer 20K)
    - rtl/ → rtl/core/ (cpu, mem, peripherals, boot, shared pkg)
    Board-agnostic HDL now cleanly separated from board-specific wrappers
    - rtl/boards/ + rtl/pix16_top.vhd → boards/pix16/rtl/
    constraints/ → boards/pix16/constraints/
    scripts/ → boards/pix16/scripts/
    fpga/ (ISE project) → boards/pix16/project/
    fpga/ (bitstreams) → boards/pix16/bitstreams/
    Each board is self-contained under boards/<board>/
    - Add boards/tang_primer_20k/ skeleton (README, Makefile, .cst stub)
    Ready for Gowin GW2A-18 top-level VHDL and GowinEDA project
    - sim/tb_*.vhd → sim/tb/ ; sim/*.hex → sim/hex/
    Clean separation of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
    [diag_sdram.cfg, ehbasic_fpga.cfg, rom_demo.cfg]
2026-06-14 docs: update all path references after fpga folder restructuring
    Reflects the multi-board layout introduced in the previous commit:
    - rtl/ -> rtl/core/ for board-agnostic VHDL
    - fpga/fpga/ -> fpga/boards/pix16/project/ for ISE project
    - fpga/asm/ -> fpga/sw/ for firmware sources
    - sim/rom_welcome.hex -> sim/hex/rom_welcome.hex
    - rtl/boards/pix16_*.vhd -> boards/pix16/rtl/*.vhd
    - Build script path: cd fpga/boards/pix16 && xtclsh ...
    - Cross-file links updated in INDEX.md, HARDWARE_SUPPORT.md,
    01_ARCHITECTURE.md, 02_MODULES.md, boards/pix16/README.md
2026-06-14 fpga: add Tang Primer 20K Gowin project and board top
    - boards/tang_primer_20k/project/tang_sbc.gprj: GowinEDA project for
    GW2A-LV18PG256C8/I7 with the same source set as the PIX16 SD boot build
    (T65 core, all rtl/core/, alinx_sd, boot subsystem) plus the new board top
    - boards/tang_primer_20k/rtl/tang20k_sbc_top.vhd: board wrapper ported from
    pix16_sbc_sd_boot_top; 27 MHz clock, active-low LEDs, KEY1=reset/KEY0=monitor,
    no UNISIM dependency; sdram_clk uses plain inversion (rPLL + CLKOUTP needed later)
    - boards/tang_primer_20k/Makefile: updated to invoke gw_sh on the project file
    [tang20k_sbc_top.vhd]
2026-06-14 fpga: fix tang_sbc.gprj to match GowinEDA v5 schema
    Use FileList/File/FileType/InLibrary element names and Device attributes
    confirmed by the GowinEDA linter. Populate all 29 source files mirroring
    the PIX16 SD boot source set.
2026-06-14 tang primer 20k: redesign for internal BSRAM, fix constraints
    Replace sbc_t65_sdram_boot_top with sbc_minimal_top — the Tang Primer
    20K has DDR3 (SSTL15), not the SDR SDRAM the old board top expected,
    and no microSD on the bare board. sbc_minimal_top keeps everything in
    Gowin internal BSRAM with ROM loaded from a hex file at synthesis time.
    Board top changes:
    - Drop SDRAM, SD card, boot subsystem, UART monitor ports
    - Add CLK_HZ/BAUD generics (27 MHz / 115200 by default)
    - Instantiate uart_tx_ser with correct clock generic
    - Route VIA Port B bits to the 4 active-low LEDs
    Project file changes:
    - Remove alinx_sd, boot/, sdram_if, sdram_ctrl, boot_shadow_rom
    - Add mem/rom.vhd (needed by sb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
    [tang20k_sbc_top.vhd]
2026-06-14 fix Gowin SSRAM exhaustion: use block RAM in sbc_minimal_top
    sync_ram had ram_style="distributed" hardcoded, forcing LUT-based SSRAM
    for every instance. Combined with ASYNC_READ=>true in sbc_minimal_top
    this consumed 840 SSRAMs against a GW2A-18 limit of 648.
    Async read is no longer needed: VIC cycle-stealing gives the CPU a full
    synchronous clock cycle to read BRAM output, so there is no combinational
    read path required.
    Changes:
    - sync_ram.vhd: ram_style "distributed" -> "block"
    - sbc_minimal_top.vhd: ASYNC_READ=>true -> false for all four instances
    (zp_ram, sram, vram, rom)
    [sbc_minimal_top.vhd, sync_ram.vhd]
2026-06-14 tang primer 20k: fix PR2017 dedicated-pin conflicts in CST
    Five assigned pins are SSPI/MSPI SPI-config pins on GW2A-18; GowinEDA
    rejects them as GPIO without a project-level multifunction option.
    Replacements (all confirmed safe from manufacturer example CSTs):
    T10 (SSPI) -> T5 for key[0] reset (UART_HELLO: rst_n = T5)
    T9 (SSPI) -> P16 for vga_vs (PT8211: HP_WS = P16)
    R10 (MSPI) -> R16 for vga_r[1] (PT8211: PA_EN = R16)
    P10 (MSPI) -> P15 for vga_g[3] (PT8211: HP_DIN = P15)
    N9 (SSPI) -> N15 for vga_b[3] (PT8211: HP_BCK = N15)
2026-06-14 tang primer 20k: HDMI output via DVI TMDS encoding
    Replace GPIO VGA breakout with on-board HDMI connector.
    vic_vga: add CLK_DIV generic (default 2 for PIX16/50 MHz, set to 1 for
    Tang Primer/27 MHz) so it runs at the native pixel clock without halving.
    Add vga_de output (data-enable, high during active video) needed by TMDS.
    All other tops updated with vga_de => open.
    sbc_minimal_top: propagate CLK_DIV generic and vga_de port.
    New files:
    rtl/core/hdmi/tmds_encoder.vhd — DVI 1.0 TMDS 8b10b encoder with
    DC balance (running disparity), control-word blanking. Generic VHDL.
    boards/tang_primer_20k/rtl/tang20k_hdmi_tx.vhd — Gowin-specific TX:
    rPLL 27->135 MHz (CLKOUT) + 27 MHz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
    [sbc_minimal_top.vhd, sbc_sdram_top.vhd, sbc_t65_boot_top.vhd, sbc_t65_sdram_boot_top.vhd, tang20k_hdmi_tx.vhd, tang20k_sbc_top.vhd, vic_vga.vhd]
2026-06-14 fix EX4854: replace case c1&c0 with if-elsif in tmds_encoder
    GowinEDA rejects case on concatenated std_logic expressions.
2026-06-14 fixed some gowin contraints
    [tang20k_hdmi_tx.vhd]
2026-06-14 fixed boot screen and gowin bugs
    [boot_vga_debug.vhd, tang20k_sbc_top.vhd]
2026-06-14 fixed some gowin board bugs
    [sbc_t65_boot_monitor_top.vhd, tang20k_hdmi_tx.vhd, tang20k_sbc_top.vhd]
2026-06-17 replace USB HID keyboard with PS/2 on Tang Primer 20K
    USB HID via nand2mario bit-bang core did not enumerate reliably
    (PH cycling 3/F). Replaced with a native PS/2 receiver on the same
    PMOD 0 pins (T7/T8). PS/2 keystrokes are injected into the UART
    receive path so EhBASIC and the monitor work without software changes.
    - add rtl/core/ps2/ps2_keyboard.vhd (scan code set 2, ASCII conversion)
    - remove USB 12 MHz PLL and nand2mario Verilog from the build
    - update constraints: PULL_MODE=UP for PS/2 open-collector bus
    - update SDC: drop USB clock domain and false-path rules
    - mark third_party/usb_hid_host as inactive, retained for future work
    [ps2_keyboard.vhd, sbc_t65_boot_monitor_top.vhd, tang20k_sbc_top.vhd]
2026-06-17 fix HDMI flicker: use CEA-861 480p timing (858x525)
    The old H_TOT=800 with 27 MHz pixel clock produced non-standard
    33.75 kHz / 64.3 Hz sync that some monitors could not lock to.
    Changing to H_TOT=858 gives standard 31.47 kHz / 59.94 Hz timing
    (CEA-861 480p totals) which all HDMI monitors accept.
    Pixel clock and TMDS bit clock unchanged (27 / 135 MHz).
    [boot_vga_debug.vhd, tang20k_hdmi_tx.vhd, tang20k_sbc_top.vhd, vic_vga.vhd]
2026-06-18 Fix FPGA PETSCII graphics and document captures
    [sbc_t65_boot_monitor_top.vhd, sbc_t65_sdram_boot_top.vhd]
2026-06-18 Fix C64-style screen line editor: full-line read and echo suppression
    The screen editor now reads the entire 40-column line on Enter
    (not just up to cursor position) and suppresses CHROUT echo during
    replay, preventing the duplicated text that appeared when editing
    lines above the prompt.
    [ps2_keyboard.vhd]
2026-06-19 Add C64-style 16-color support to FPGA VIC
    Hardware (vic_vga.vhd):
    - Add color line buffer alongside character line buffer
    - Extend bus-stealing FSM to two phases: 40 char fetches from
    $8000+ followed by 40 color fetches from $8400+ (~82 cycles
    per H-blank, ~5.1% CPU overhead)
    - Add C64 16-color Pepto palette as RGB565 lookup tables
    - Replace monochrome white-on-black output with per-cell
    foreground/background palette lookup
    VIC registers (all 5 top-level modules):
    - $9003 TEXT_COLOR (R/W): foreground color 0-15, default white
    - $9004 BG_COLOR (R/W): background color 0-15, default black
    Kernel (kernel.s):
    - CHROUT writes composed color byte (bg<<4|fg) to color RAM
    at $8400+offset f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
    [sbc_minimal_top.vhd, sbc_sdram_top.vhd, sbc_t65_boot_monitor_top.vhd, sbc_t65_boot_top.vhd, sbc_t65_sdram_boot_top.vhd, vic_vga.vhd]
2026-06-19 Add 320x200 bitmap graphics mode to FPGA VIC
    - Add bitmap_mode input and vic_fetch_bitmap output ports
    - Compute fetch_bmp_line (0-199) from VGA scanline for bitmap
    row addressing during bus-steal phase 0
    - Phase 0 fetches bitmap bytes from $9010+ in bitmap mode,
    text chars from $8000+ in text mode; phase 1 (color from
    $8400+) is identical in both modes
    - Pixel extraction in bitmap mode reads linebuf directly as
    8-bit pixel pattern (MSB-first, no char ROM, no reverse video)
    Top-level modules (all 5 with vic_vga):
    - Add 8 KB bitmap RAM (sync_ram, 13-bit address) at $9010-$AF4F
    - Add MODE register at $9000 (R/W, bit 0 = bitmap mode)
    - Registered data mux (vram_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
    [sbc_minimal_top.vhd, sbc_sdram_top.vhd, sbc_t65_boot_monitor_top.vhd, sbc_t65_boot_top.vhd, sbc_t65_sdram_boot_top.vhd, vic_vga.vhd]
2026-06-19 added mandelbrot assembler demo rom
    [mandelbrot_bitmap.cfg]
2026-06-19 Add FPGA sound chip: single-voice synth + PT8211 DAC
    Stripped-down hardware port of the C emulator soundchip to the Tang Primer 20K. First bring-up version: one voice (channel 0, $8830-$8839) with square and noise waveforms, register-compatible with src/soundchip.c.
    - sound_voice.vhd: phase-accumulator oscillator, square + noise (LFSR), frequency/volume honoured, gate via CONTROL bit. ADSR/duration regs accepted but unused.
    - pt8211_dac.vhd: I2S serializer for the dock PT8211 DAC.
    - Wire DEV_SOUND0 CS/WE/read-mux and both instances into sbc_t65_boot_monitor_top; pass DAC pins through tang20k_sbc_top.
    - Constrain PT8211 pins (R16/P15/P16) in the board CST.
    - Add modules + tb_sound_voice to M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
    [sbc_t65_boot_monitor_top.vhd, tang20k_sbc_top.vhd]
2026-06-19 Fix FPGA sound output on Tang Primer 20K and document the sound chip
    The single-voice sound chip produced only hiss/silence on real hardware.
    Four independent issues, all now fixed:
    - build.tcl did not list sound_voice.vhd / pt8211_dac.vhd, so the
    make_tang20k.ps1 flow (gw_sh build.tcl, not the .gprj) synthesized them
    as empty black boxes and the DAC pins floated. Added both sources.
    - PA_EN (R16) — the dock audio power-amplifier enable — was never driven;
    R16 had been mis-assigned as BCK. Added a pa_en output tied high.
    - DAC pins were wrong/swapped. Corrected to the official Sipeed pinout:
    BCK=N15, WS=P16, DIN=P15 (LVCMOS33, since Bank 1 VCCIO is 3.3 V).
    - pt8211_dac.vhd used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
    [tang20k_sbc_top.vhd]
2026-06-19 Fix VRAM read-after-steal hazard scrolling stray 'A' onto screen
    Bug: When the screen scrolled (last line reached), random 'A' ($01)
    characters appeared at cells that should have held spaces ($20). It showed
    up after the sound chip was added to the build and happened even with no
    sound playing — pressing Enter on an empty screen was enough to trigger it.
    Root cause: a single-port VRAM read-after-steal hazard. The VRAM (sync_ram)
    has one cycle of read latency. During a VIC bus steal, vram_addr_mux is
    driven by vic_addr, so vram_dout holds the VIC's fetched byte (e.g. the
    colour value $01). cpu_rdy went high the instant the steal ended, but
    vram_dout still reflected the VIC address for one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
    [sbc_t65_boot_monitor_top.vhd]
2026-06-20 implemented a more powerfull soundchip
    [soundsid.cfg, soundtest.cfg]
2026-06-20 fix: decouple soundtest timing from CPU clock
    [bus_decode.vhd, sbc_pkg.vhd, sound_chip4.vhd]
2026-06-20 feat(fpga): KEY0 reset button, chess PS/2 keyboard, FPGA siddemo
    Tang Primer 20K reset button (KEY0 / dock S0):
    - Fix key[0] pin to T10 (the dock's S0 reset button). T5 (and an interim T2)
    were not the physical button, so no reset key worked at all. Confirmed by
    Sipeed's own Cam2HDMI and HDMI dk_video examples (reset = T10).
    - KEY0 short press = CPU-only soft reset: the 6502 restarts via its reset
    vector while boot_done, shadow ROM, and SRAM are preserved (restarts a
    UART-uploaded program without re-running the SD boot loader). Long press
    (>1 s) = full board reset. Debounced and synchronised in the clk_sys domain.
    - Add a soft_reset input to sbc_t65_boot_monitor_top; cpu_reset_base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
    [sbc_t65_boot_monitor_top.vhd, tang20k_sbc_top.vhd]
2026-06-20 docs: add wiki publish script for FPGA documentation
    publish_wiki.ps1 mirrors the docs/ tree (plus board READMEs and README)
    into the GitHub wiki: converts cross-doc links to wiki page links, image
    links to raw.githubusercontent URLs so captures render inline, and writes
    a grouped _Sidebar. Run with -Push to publish.
2026-06-20 chore(tang20k): track device.cfg so GUI P&R works out of the box
    Commit impl/pnr/device.cfg with SSPI/MSPI regular_io=true so opening the
    project in GOWIN FPGA Designer places sd_miso (M8) and key[0] (T10) without
    PR2017/PR2028. Un-ignore just that file, keep make clean from deleting it,
    and document the GUI flow in the board README.
    [device.cfg]
2026-06-20 Restore dock S1 monitor button with DDR3
2026-06-20 Revert "Restore dock S1 monitor button with DDR3"
    This reverts commit a5f00c4e9cbd4ebd1371b8c3a793094e79701255.
    [tang20k_sbc_top.vhd]
2026-06-21 Stabilize Tang Primer 20K DDR3 bring-up and clear RAM on cold start
    DDR3 reset/calibration:
    - Free-run the DDR memory PLL (reset tied low) so it locks immediately at
    power-on, like the Sipeed DDR reference, instead of gating it on the HDMI
    PLL / reset button.
    - Hold the controller rst_n until the memory PLL has locked, then release it
    synchronously on the 27 MHz reference clock. The sequencer runs on the board
    oscillator only, loading no PLL-derived fabric clock, so the exclusive
    PLL_L[0]/PLL_R[0] placement (needed for DDR PHY calibration) stays intact.
    - Auto-retry calibration: if init_calib_complete is not reached within ~20 ms,
    re-pulse the controller reset and retry. The boar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
    [device.cfg]
2026-06-21 Add fixed-point math coprocessor (FPU) and 8.24 Mandelbrot
    A small memory-mapped signed 32x32 -> 64 fixed-point multiplier at $88B0 that
    maps to the GW2A DSP blocks, off-loading the multiply that dominates 8-bit
    fixed-point code. Default format is 8.24; the shift is a register so any
    Q-format works. On the Tang Primer 20K the Mandelbrot renderer drops from
    ~5-8 min (software multiply, 4.12) to ~10 s (8.24), with a sharper image.
    RTL / integration:
    - rtl/core/peripherals/math_copro.vhd: the unit (registered multiply + shift,
    raw 64-bit product and scaled result, no CPU wait states).
    - sbc_pkg.vhd: ADDR_MATH_BASE/LAST ($88B0-$88BF) + DEV_MATH.
    - bus_decode.vhd: decode the window to DEV_MATH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
    [bus_decode.vhd, math_copro.vhd, sbc_pkg.vhd, sbc_t65_boot_monitor_top.vhd, tb_math_copro.vhd]
2026-06-21 feat: add split ROM map, native SID, and bitmap relocation
    [ehbasic_fpga.cfg, mandelbrot_bitmap.cfg, soundsid.cfg]
2026-06-22 move back from ddr3 to bram framebuffer
2026-06-22 feat(sid): add 6581 filter, combined waveforms, ring mod and hard sync
    Extend the sid6581 core toward a full MOS 6581:
    - 2-pole state-variable multimode filter (LP/BP/HP) with per-voice
    routing ($D417), mode/volume ($D418) and an 11-bit cutoff, run over
    a 3-step pipeline (one multiply per clock) for 54 MHz timing
    - non-linear 'dark 6581' cutoff curve so mid-range register values
    actually filter (FC~1240 -> ~2 kHz instead of ~7.5 kHz of a linear map)
    - deliberately weak 6581-style resonance (Q ~0.7..2) so resonant peaks
    colour the tone without slamming the output limiter into clipping
    - AND-combined waveforms (darker/hollow 6581 approximation)
    - hard oscillator sync and ring modulatio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
    [sid6581.vhd, tb_sid6581_combined.vhd]
2026-06-22 feat(sid): bulk-build playable SID tune ROMs, GUI tab and roms/ index
    - generalise build_native_sid_rom.py to wrap a tune at any load address in
    the board's linear RAM ($0200-$5FFF), not just $1000
    - add build_all_sid_roms.py: wraps every tune in sid_orig/ into
    roms/sound_<name>.rom plus a matching upload .bat, and skips tunes that do
    not fit the memory map or are silent/non-playable here (emulator-verified)
    - ship 38 verified-playable native-SID tune ROMs and their upload scripts
    - add a "SID Tunes" tab to fpga_tools_gui.py: filterable list with one-click
    --split-rom upload
    - add roms/README.md cataloguing every ROM image (system, demo and SID)
    - stop tracking the bundled sid_orig/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
2026-06-22 fix(sid): pipeline 6581 filter to 6 stages to close 54 MHz timing
    Adding the second SD-card disk controller pushed FPGA utilisation to ~88%
    CLS, and the resulting placement degraded the SID filter's combinational
    path past the 54 MHz system clock budget. The worst path (bp_s -> sample_out,
    28.7 ns / -10.2 ns slack, 58 violated endpoints) caused the audio to come
    out distorted.
    Split the filter's per-tick update from a 3-stage into a 6-stage pipeline so
    no multiply+add+saturate chain settles in a single 54 MHz cycle:
    0 voice mix (3 voices, combined waveforms) -> dir_lat/flt_lat, coefficients
    1 HP = flt - lp - damping*bp (was folded into stage 0)
    2 BP += f*hp (saturating)
    3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
    [sid6581.vhd]
2026-06-22 refactor(audio): group SID and legacy soundchip under rtl/core/audio/
    Separate the two distinct audio cores into a clear directory layout:
    rtl/core/audio/sid/sid6581.vhd MOS 6581-compatible SID
    rtl/core/audio/legacy_sound/sound_chip4.vhd 4-voice legacy soundchip
    rtl/core/audio/legacy_sound/sound_voice_full.vhd
    rtl/core/audio/legacy_sound/sound_voice.vhd
    This mirrors the existing memory-map split already in sbc_pkg.vhd:
    $D400-$D418 SID-compatible register block
    $8830-$88AD legacy 4-voice soundchip (channels 0-3)
    Files moved with git mv (history preserved). Updated the paths in
    build.tcl, tang_sbc.gprj and the sim Makefile. Entity bindings in the
    top level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
    [sid6581.vhd, sound_chip4.vhd, sound_voice_full.vhd]
2026-06-24 feat(d64): D64 GoDrive virtual disk with kernel LOAD/DIR and runnable test disk
    Add a D64-compatible virtual disk on the second SD card (sd2 data disk):
    the FPGA mounts a FAT32-stored .d64 image and exposes 256-byte D64 sectors to
    the 6502 at $8824; the 6502 never parses FAT32. The D64 structure is borrowed
    for convenience only — programs are this system's own code, not C64-compatible.
    RTL (rtl/core/peripherals/):
    - d64_sector_map: combinational D64 track/sector -> linear index (+ validity)
    - d64_drive: read-only D64 sector engine (T/S -> LBA, 512->256 half-sector)
    - fat32_reader: MBR or superfloppy autodetect, BPB parse, whole-root-cluster
    scan for the first .D64, FAT chain contiguity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
    [disk_test.cfg, kernel.cfg, mandelbrot_copro_prg.cfg]
2026-06-25 feat(d64): batch-convert all convertible SID tunes onto numbered D64 disks
    Add tools/build_sid_disks.py: convert every convertible PSID under sid_orig to a
    RAM PRG and pack them into numbered images (roms/test_d64/sid/tunesNN.d64), each
    filled to the 35-track capacity. ~87 of ~199 tunes convert; the rest load into
    high RAM ($A000+/$E000), are IRQ/CIA-driven with no play address, or are too
    large for RAM, and are skipped.
    - build_sid_prg.py: --base now defaults to "auto", placing the PRG just above the
    tune's native region (instead of a fixed $2000), which rescues ~24 more tunes
    whose native load overlapped $2000. Entry point stays = load address, so each
    runs with CALL <load> (LOAD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
2026-06-25 feat(d64): interactive .d64 select menu (LOAD "!") with per-disk mount
    Let the 6502 mount any .d64 on the FAT32 card, not just the first one.
    - RTL (d64_subsystem): CMD_MOUNT_LBA ($07) mounts a 6502-supplied LBA from
    $882C-$882F with no FAT scan. The drv_mount pulse is deferred via
    mount_lba_pending and fired only once the drive engine is idle -- a
    same-cycle pulse raced the engine state on hardware (passed GHDL, failed on
    the board), latching the old LBA so the menu always mounted the first disk.
    - Kernel: DISK_ENUM (6502-side FAT32 root scan), DISK_MENU ($F033),
    DISK_MOUNT_LBA ($F030). DISK_MOUNT is now idempotent so LOAD keeps the
    menu's pick instead of re-mounting the first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
    [kernel.cfg]
2026-06-25 fix(ehbasic): flush BASIC input buffer before screen-edit line replay
    On-screen line editing (cursor keys / backspace, then Enter) produced a
    ?SYNTAX ERROR: the kernel edited only the VIC screen while EhBASIC's own input
    buffer (Ibuffs) kept the originally-typed characters, so the replayed corrected
    line was appended to the stale text ("PRIMT" + "PRINT" -> "PRIMTPRINT").
    Before replaying the corrected screen line, feed EhBASIC $47 (its max line
    length) backspaces so it empties Ibuffs first; excess backspaces past an empty
    buffer are ignored, so the count need not be exact. The flush backspaces leave
    SCREEN_REPLAY_POS at 0 so the existing POS<LEN echo suppression in CHROUT hides
    them. New SC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
2026-06-25 feat(d64): indent directory listing so you can LOAD straight from it
    Print the directory (LOAD "$" / after LOAD "!") indented 4 spaces, with each
    file line as `____"NAME" PRG` and no leading block count. The user can move the
    cursor to the start of a file line, type LOAD over the four spaces (-> the line
    reads LOAD"NAME" PRG), and press Enter to load it the C64 way. This relies on
    the screen-edit replay fix; the LOAD hook evaluates "NAME" and ignores the
    trailing type label.
    The leading decimal block count was dropped so the quote sits exactly at column
    4 (LOAD"NAME" instead of an invalid LOAD<count> "NAME").
    Docs: update docs/D64_DRIVE.md (new format, LOAD-from-listing, LOAD "!" menu).
2026-06-25 docs(presentation): bilingual product page with per-component detail pages
    Add a self-contained HTML product presentation for the 6502 SBC FPGA:
    - single 6502_fpga_computer.html with in-page DE/EN language switch
    - datasheet-style layout (T65 CPU, VIC, SID-compatible sound, VIA/UART,
    D64 GoDrive, math coprocessor) using real hardware screenshots
    - per-component detail pages under components/ (DE + EN, shared detail.css)
    - highlights SID 6581 compatibility and native .sid playback (original
    6502 player code, no lossy 50 Hz conversion)
2026-06-25 feat(hdmi): AVI InfoFrame + exact CEA 720x480p so HDMI grabbers lock
    The Tang HDMI output was bare DVI with non-standard 640-in-858 timing: it
    showed fine on monitors but USB HDMI capture devices stayed black or dropped
    every other frame.
    - hdmi_encoder: full HDMI instead of bare DVI. Inserts a per-frame AVI-InfoFrame
    data island (VIC 2) plus video preamble and guard bands. The static InfoFrame
    packet (HDMI BCH ECC + TERC4) is precomputed offline by
    tools/gen_avi_infoframe.py into hdmi_data_island_pkg.vhd. Self-checking
    tb_hdmi_encoder verifies island words, guard bands and preamble placement.
    - vic_vga/boot_vga_debug/sbc_t65_boot_monitor_top: new CEA_480P generic. Tang
    now emits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
2026-06-25 feat(kbd): selectable German/US PS/2 layout with umlaut glyphs
    KBD_LAYOUT generic ("DE"/"US") threaded board top -> monitor top ->
    ps2_keyboard. German table swaps Y/Z, German shifted number row, AltGr
    (@ { [ ] } \ ~ |), 102nd <>| key, and umlauts as Latin-1 (ä ö ü Ä Ö Ü ß).
    char_rom grows to 256 glyphs with real umlaut shapes at their Latin-1
    code points. New optional glyph_hi port (default '0') keeps all other
    tops/TBs on the original 128-glyph behaviour. On the active vic_vga path
    char_code(7) now drives glyph_hi instead of reverse video (unused by
    software; cursor is a separate overlay).
    Verified on hardware: PRINT "TEST öäü" renders correctly end to end.
    [char_rom.vhd, ps2_keyboard.vhd, sbc_t65_boot_monitor_top.vhd, tang20k_sbc_top.vhd, vic_vga.vhd]
2026-06-26 feat(vic): 320x240 16-colour BSRAM framebuffer (color16_mode)
    New vic_vga color16_mode (VIC_MODE bit 4): 320x240 at 4 bpp with the 16-entry C64 palette, two pixels per byte. Reuses the color256 line fetch (160 bytes/line) but renders the full active height (line = vc/2 -> 240 lines) and unpacks each byte as two palette indices (even x = low nibble, odd x = high nibble).
    Framebuffer storage is a new fb_ram with an exact 38400-byte depth so Gowin packs ~19 BSRAM blocks instead of rounding a 16-bit address up to a 64 KiB/32-block array (~39 of 46 blocks total). The top widens the bitmap address to 16 bits with a 3-bit bank (vic_mode_reg(7:5)) for the new mode; legacy 160x100/180x120 modes keep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
2026-06-27 feat(vic): C64-style border/background, SID OSC3/ENV3, 1:1 bitmap
    VIC-II colour registers at the C64 addresses ($D020-$D02F, DEV_VICII): $D020 border (POKE 53280) and $D021 global text background (POKE 53281) are wired into vic_vga; the rest are stored for read-back so classic colour pokes land in real registers. Text background changes from per-cell (colour-RAM high nibble) to the global $D021, matching the C64 text model (foreground stays per-cell); default 0 keeps the black look.
    SID read registers $D419-$D41C: POTX/POTY return $FF (no paddles), OSC3 ($D41B) returns the voice-3 oscillator MSB and ENV3 ($D41C) the voice-3 envelope, so tunes/effects that read them work. SID decode extended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
    [bus_decode.vhd, sbc_pkg.vhd, sbc_t65_boot_monitor_top.vhd, sid6581.vhd, tb_bus_decode.vhd, tb_vic_border.vhd, tb_vic_color16.vhd, vic_vga.vhd]
2026-06-27 feat(cia): CIA-1 Timer A with underflow IRQ ($DC00-$DC0F)
    Adds a MOS 6526 CIA-1 subset (Timer A) at the C64 address $DC00-$DC0F: a 16-bit down-counter at a ~1 MHz PHI2 rate (so C64 tune period values give compatible interrupt rates), reload/one-shot/force-load via CRA ($DC0E), and an ICR ($DC0D: read = status incl. bit7 IRQ + bit0 TA, reading clears; write = mask with bit7 set/clear sense). Underflow raises an IRQ wired into cpu_irq_n. Timer B / TOD / ports are stored for read-back but not functional.
    This is the hardware foundation for IRQ-driven SID playback (more tunes than the polled 50 Hz wrapper can handle). Decoded as DEV_CIA1; live $DC04/$DC05 counter readable.
    Validated: tb_cia652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
2026-06-27 feat(sid): page-mode (RAM-under-BASIC) tooling, curated-ROM guard, bulk tunes
    Extend the native SID ROM tooling and bulk-build playable tunes:
    - build_native_sid_rom: add the "page" layout for tunes that load at
    $A000-$CFFF (played in RAM under the paged-out BASIC ROM via sid_page.cfg)
    and allow play==0 (pure IRQ tunes driven from a CIA Timer A / $0314).
    Low-RAM copy tunes start a free-running CIA Timer A so players that read
    $DC04 see a live timer, and the start song ($startSong-1) is honoured.
    - build_all_sid_roms: a CURATED guard so the bulk build never overwrites
    hand-made ROMs. roms/sound_commando.rom is a bespoke demo whose generic
    wrapper does not reproduce it; the bulk b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
    [sid_page.cfg]
2026-06-27 chore(build): target Gowin 1.9.12.03 toolchain
    - make_tang20k.ps1: fall back to the Gowin V1.9.12.03 gw_sh and
    programmer_cli paths (the version used for the DDR3 work) instead of
    V1.9.11.03 Education.
    - device.cfg: drop the stale `background_programming = off` line.
    [device.cfg]
2026-06-27 fix(sid): play raster-IRQ RSID tunes by polling the inner player
    Some RSID tunes declare play=$0000 but are not silent: their real
    per-frame update lives inside a VIC raster-interrupt handler the FPGA
    cannot service (no VIC interrupts, $FFFE/$FFFF is ROM, no $01 banking).
    Arkanoid is the case in point -- its init enables a raster IRQ and CLIs,
    and the handler calls the actual SID update at $4141.
    Add an OVERRIDES table to build_native_sid_rom that points play (and the
    song) at that inner routine, so the polled wrapper drives it directly at
    50 Hz with no interrupt. Also issue SEI after init in the polled wrapper:
    an init that ends with CLI would otherwise let a stray IRQ vector through
    the R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
2026-06-27 docs(presentation): cover VIC-II/CIA/SID changes; add colour-register shots
    Bring the product page and the per-component detail pages up to date with
    the recent hardware work:
    - Memory map gains the keyboard ($8820), the VIC-II register block
    ($D000-$D03F with $D011/$D012 raster read-back) and CIA-1 ($DC00); SID
    range corrected to $D400-$D41C.
    - VIC pages: the 320x240 16-colour framebuffer, the C64 colour/raster
    registers, and 720x480p CEA-861 output.
    - Sound pages: load layouts, polled vs IRQ drive, the SEI guard, the
    raster-IRQ override (Arkanoid) and the curated-ROM guard.
    - I/O and CPU pages: CIA-1 Timer A, the German/US PS/2 layout with USB
    HID only prepared, and the correcte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
2026-06-27 docs(paper): track the 6502 FPGA project paper (source + PDF)
    Add the project paper -- "A 6502 Home Computer Rebuilt in Logic" -- as
    LaTeX source plus the built PDF. It documents the architecture, the
    memory map, the video/audio/I/O subsystems (including the VIC-II raster
    registers, CIA-1 and the native .sid playback model), verification, and
    the current hardware status, and embeds the board screenshots from
    presentation/images.
    .gitignore now tracks only the paper source and PDF; LaTeX build
    artefacts (.aux/.log/.out/.synctex.gz) and any other local documents in
    paper/ stay out of the repo.
2026-06-27 feat(reist): standalone REIST benchmark engine, Gowin project and results
    A self-contained FPGA project (no 6502 files touched) that measures REIST
    centered-remainder arithmetic against the Gowin Integer Division IP on the
    Tang Primer 20K, with area/Fmax probes and documentation.
    - rtl/reist: reist_core (centered correction), reist_bench_engine (REIST vs IP,
    dependency-chain and independent workloads), bench_report (UART hex),
    ip_divider (sim model) / ip_divider_ip (Gowin IP wrapper), seq_divider
    (unit-test reference), reist_pkg.
    - boards: reist_top (benchmark) and the reist_reduce_top / ip_reduce_top
    area/Fmax probes; own Gowin projects under boards/tang_primer_20k/reist/
    (reist_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
    [bench_report.vhd, ip_divider.vhd, ip_divider_ip.vhd, ip_reduce_top.vhd, reist_bench_engine.vhd, reist_core.vhd]
2026-06-27 feat(chess): RAM-PRG of the chess game on testdisk.d64
    Relink the standalone $C000 chess ROM (vendored from the 6502-sbc-emulator source) down to a RAM PRG at $2000 via sw/chess_prg.cfg, so it loads through the D64 GoDrive and runs with CALL 8192 like the other test PRGs. The make tunes-d64 target builds CHESS.prg next to MANDEL and packs it into testdisk.d64.
    The player drives the VIC text screen and PS/2 keyboard (already FPGA-native in the source). It enables the per-cell text background ($9005) for the board tiles and plays its melody/beeps on the SID at $D400 (the current bitstream has no synth at $8830) -- both adaptations live in the relinked source.
    [chess_prg.cfg]
2026-06-27 feat(vic): per-cell text background ($9005) + chess piece glyphs
    Add a VIC text submode so apps can paint coloured background tiles, which the C64-style global-background text mode could not do (it ignored the colour-RAM high nibble). New register $9005 TEXT_ATTR bit0: when set, the per-cell background comes from the colour-RAM high nibble (foreground stays the low nibble). Cleared on cpu_reset_n so a returning BASIC screen keeps the global background. Wired through sbc_t65_boot_monitor_top into vic_vga (cell_bg_mode).
    Add the six chess piece glyphs (pawn/knight/bishop/rook/queen/king) at char codes $80-$85 in the upper char-ROM bank (char_rom.vhd build_rom); they were blank, so chess drew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
2026-06-27 feat(adventure): Crypt of the 6502 -- standalone PETSCII adventure ROM
    A native 6502 port of examples/adventure.bas as a self-contained, uploadable 16 KB split-ROM ($A000 code, $F000 vectors). It drives the VIC text screen and PS/2 keyboard directly -- no kernel/BASIC dependency.
    Scott-Adams-style 40x25 UI: the top 11 rows are a per-room PETSCII picture (an RLE scene engine drawing solid $7F colour blocks, so it needs no per-cell background and runs on the stock bitstream); the bottom rows show the room name, description, items, exits, a status line and the command input. Eight room scenes (cell, corridor, library, lab, armory, guard room, vault, forest exit).
    SID audio ($D400, timed off t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
    [adventure.cfg]
2026-06-27 feat(d64): multi-part PRG chain-loading (sw/chainload.inc) + demo
    Let a loaded PRG load and run another PRG from the same D64, so a game can ship as multiple parts (intro, main, levels) that load one another. The kernel DISK_LOAD ($F024) + JMP (DK_START) already does this, but loading the next part over the loader's own $2000 address corrupts the loader mid-call.
    sw/chainload.inc relocates a tiny position-independent mount/load/jump stub to $5F00 and runs it there. The kernel disk code only touches zero page, page 3 and the $8824-$882F ports (the sector buffer is the $8829 hardware port, not RAM), and parts live below $6000, so the stub survives the load and jumps cleanly into the next part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
    [prg2000.cfg]
2026-06-27 fix(ehbasic): working colour boot banner + C64 border/background
    The banner relied on the kernel STROUT, which can't print: it stores the
    pointer high byte at $EE while the indirect load reads $EC (CHROUT's own
    screen-pointer scratch), so the pointer is garbage and the banner showed
    nothing. Print the bytes directly via CHROUT instead (preserves A/X/Y),
    using $F2/$F3 as a transient pointer.
    Also give the screen a C64 look: light-blue border ($D020=$0E), blue
    background ($D021=$06), light-blue BASIC text. Banner lines recoloured to
    contrast with the blue background.
2026-06-27 feat(vic): display photographs in COLOR16 320x240 from a D64
    A full 320x240 16-colour frame is 38400 bytes -- too big for a ROM or a single
    RAM PRG -- so a photo is shipped on a D64 as a small loader plus five
    framebuffer-bank parts and streamed straight into fb_ram.
    - tools/img2hires.py: image -> framebuffer converter. --color16 produces the
    38400-byte COLOR16 data with serpentine Floyd-Steinberg dithering to the
    16-colour palette (every pixel a free index); the default targets the 320x200
    hires mode (2 colours per 8x8 cell). Tone knobs: brightness/contrast/
    saturation/gamma. Emits a preview PNG.
    - sw/show_image.s: loader at $2000. For each bank 0..4 it sets
    VIC_MODE=(bank<<5)|$1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
    [ich_image.cfg]
2026-06-28 refactor(tang20k): move SBC into boards/tang_primer_20k/sbc/
    Mirror the c64/ and reist/ subproject layout: the 6502 SBC board files now
    live under boards/tang_primer_20k/sbc/ (project/, rtl/, constraints/,
    bitstream/, Makefile) instead of the board root. The shared HDMI TX
    (tang20k_hdmi_tx.vhd) and the REIST sources stay in boards/tang_primer_20k/rtl/,
    so the c64/ build is unaffected.
    - git mv of all SBC sources into sbc/
    - sbc/project/build.tcl + tang_sbc.gprj: repo-root refs ../../../ -> ../../../../,
    shared HDMI ../rtl/ -> ../../rtl/ (sbc-local rtl/constraints/src unchanged)
    - top-level Makefile (tb_bram_byte_bridge) + docs paths updated to sbc/
    - .gitignore impl/tmp/gprj.user/src patt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
    [device.cfg]
2026-06-28 feat(c64): native Commodore 64 core (M1a: boot + keyboard)
    Board-independent C64 in rtl/c64, wired up on the Tang Primer 20K
    (boards/tang_primer_20k/c64), reusing the SBC's T65 CPU, SID, HDMI TX and PS/2.
    Boots the original KERNAL to READY with a working keyboard over HDMI.
    - rtl/c64: c64_core (64K single-port BSRAM time-shared with the VIC steal via
    the 6502 RDY + a 4-deep deferred-write FIFO), cpu6510 ($00/$01 port + PLA
    banking), vic_ii (text + raster IRQ), 2x cia6526_full, colour_ram,
    c64_keyboard_matrix (PS/2 -> C64 matrix)
    - tools/build_c64_roms.py / build_c64_diag.py generate rtl/c64/c64_roms.vhd
    locally from user-supplied Commodore ROMs; the ROMs, the generated VHDL and
    th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
    [c64diag.cfg]
2026-06-28 Stabilize Tang C64 CIA debug build
    [c64_core.vhd, c64_dbg_uart.vhd, c64_keyboard_matrix.vhd, cia6526_full.vhd, cpu6510.vhd, mos6526_mist.v, tang20k_c64_top.vhd]
2026-06-28 Add Tang C64 UART PRG loader
2026-06-29 Add C64 VIC graphics test and robust UART loader
    [c64_vic_graphics_test.cfg]
2026-06-29 Stabilize C64 SID PRG playback
    Build all convertible SID files as RUN-loadable C64 UART PRGs and document the workflow.
    Drive SID playback from CIA Timer A at 50 Hz and disable VIC display fetches for sound-only PRGs to avoid BA/RDY playback jitter.
    [vic_ii.vhd]
2026-06-29 Add C64 SID PRG uploads to FPGA tools GUI
    Extend the SID Tunes tab with RUN-loadable C64 UART SID PRG listing, filtering, rebuild, and upload controls.
2026-06-29 Improve SID test reset handling
    [sid6581.vhd]
2026-06-29 Improve C64 D64 loading and VIC charset support
    Add a D64-to-PRG UART upload helper and GUI entry for local game images. Add long-press cold reset RAM scrubbing for the Tang C64 core. Extend the VIC-II text renderer to fetch RAM charsets selected through D018 and cover it with a focused simulation test.
    [c64_core.vhd, tang20k_c64_top.vhd, tb_c64_vic_graphics_modes.vhd, vic_ii.vhd]
2026-06-29 Stabilize C64 virtual 1541 UART loader
    Add a guarded KERNAL LOAD stub for the native C64 virtual 1541 path so the hook no longer depends on the fragile vector after BASIC/KERNAL vector resets. Keep the production hook at roms/v1541_hook.prg and move generated diagnostic/smoke PRGs into roms/diagnostics with a README.
    Add UART monitor probing for post-hang CPU/RAM snapshots, document the READY hang root cause and fix in a technote, and update build/upload docs and batches for the new diagnostic layout.
    [c64_v1541_loadfirst.cfg]
2026-06-29 Add C64 math coprocessor demos
    [c64_mandelbrot_copro.cfg]
2026-06-29 Fix C64 BASIC freeze regression
    Restore the VIC fetch/BA cadence to every visible scanline so the C64 single-port RAM arbiter keeps the stable steal timing observed before the scrolling diagnostics.
    Disable the native C64 math-coprocessor I/O2 read path in the stable bitstream; hardware testing showed that adding it to the C64 I/O mux can destabilize the BASIC/KERNAL timing path after syntax errors. Document the C64 coprocessor PRGs as experimental while the SBC coprocessor remains active.
    [c64_core.vhd, vic_ii.vhd]
2026-06-30 Add C64 image viewer and software Mandelbrot multiply
    [c64_ich_image.cfg]
2026-06-30 Start CIA2 IEC bus modelling for virtual 1541
    [c64_v1541_hook.cfg]
2026-07-01 Add Tang 20K MiSTer C64 probe
2026-07-01 Add MiSTer 1541 IEC responder to probe
2026-07-01 Add Tang MiSTer C64 UART 1541 sector backend
2026-07-01 Fix Tang MiSTer C64 clock speed
    [c1541_static_dir_gcr.sv, fpga64_keyboard_simple.vhd, fpga64_sid_iec_gowin.vhd, mister_c1541_iec.vhd, tang20k_mister_c64_probe_top.vhd]
2026-07-01 Fix native C64 PAL timing and cursor keys
    [c64_keyboard_matrix.vhd, hdmi_encoder.vhd, tang20k_c64_top.vhd, tang20k_hdmi_tx.vhd, vic_ii.vhd]
2026-07-01 Stabilize C64 VIC fetch and virtual 1541 UART resync
    [vic_ii.vhd]
2026-07-02 Add raw SD D64 backend for MiSTer C64 probe
2026-07-02 Tune MiSTer C64 probe HDMI and SID output
2026-07-02 Fix MiSTer C64 probe video timing CDC
    [tang20k_mister_c64_probe_top.vhd]
2026-07-03 Add C64 SD fastloader with FAT16 disk menu to MiSTer probe
    - Combine the KERNAL LOAD fastloader and a FAT16 disk selector into one
    resident hook at $C000: LOAD"@",8 scans the SD root directory for
    *.D64, checks FAT-chain contiguity and mounts; LOAD"*" and named loads
    go through the $DF08-$DF0C direct-sector port; $ and VERIFY fall back
    to the stock KERNAL/IEC path.
    - Fix the KERNAL $FFD5 guard stub to preserve A (the LOAD/VERIFY flag);
    the old stub turned every hooked LOAD into a silent VERIFY fallback.
    The stub now detects the hook at $C000/$C003.
    - Arbitrate SD access between the 1541 backend and the fastload window
    per whole 512-byte transfer, add a D64-mounted status bit wi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
    [c64_sd_fat16_select.cfg, c64_sd_hook.cfg]
2026-07-03 Boot the C64 SD hook from the card at power-up
    - Add c64_sd_hook_boot_loader.vhd: after reset the C64 is paused while
    the hook image is streamed from card LBA 8 (C64HOOK1 header in the
    unpartitioned gap before the FAT16 partition) straight into C64 RAM,
    so the resident fastloader plus disk menu needs neither a PC nor a
    UART upload. The signature byte is written last, a slow or late card
    releases the C64 after two seconds and gets a short re-pause copy once
    sd_init_done arrives, stalled transfers are retried, and $DF06 exposes
    the loader status for debugging from BASIC.
    - Arbitrate the boot loader as a third SD requester ahead of the drive
    and fastload window; share the monit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
    [c64_sd_hook_boot_loader.vhd, tang20k_mister_c64_probe_top.vhd, tb_c64_sd_hook_boot_loader.vhd]
2026-07-03 Add Pipistrello Spartan-6 board support
2026-07-03 Document Pipistrello board files
2026-07-04 Add cycle-based VIC-II XL, SD floppy and dump-capable UART monitor to the native C64
    - vic_ii_xl: 6569 model after Bauer's vic-ii.txt (real badlines with the
    VC/RC/VCBASE machine, live badline condition, border flip-flops with
    RSEL/CSEL/DEN, immediate register effects incl. mid-line splits, sprite
    DMA with MC/MCBASE and X/Y expansion, collision IRQs, idle $3FFF fetches,
    invalid modes black). Selectable via the VIC_XL generic; the line-buffer
    vic_ii stays as fallback. Fetches run over dedicated dual-port RAM reads
    (c64_ram_dp/colour_ram_dp), BA only reproduces the 6510 stall timing.
    - SD floppy exactly like the MiSTer probe board: 1541 backend 3 (contiguous
    .d64 on FAT16), $DF00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
    [c1541_sd_d64_sector_source.vhd, c64_core.vhd, c64_prg_upload_monitor.vhd, c64_ram_dp.vhd, colour_ram_dp.vhd, tang20k_c64_top.vhd, tb_c64_prg_upload_monitor.vhd]
2026-07-05 Fix Tang 20K 1541 D64 writeback
    Correct the 1541 GCR write-bit ordering and marker capture so SAVE commits decoded sectors instead of producing partial directory entries.
    Add SD D64 read-modify-write flushing, CMD24 data-response handling, diagnostics, GHDL write tests, and a standalone Tang 20K 1541 selftest project.
    [device.cfg]
2026-07-05 Document Tang 20K C64 D64 writeback
    Update the native C64, probe, diagnostics, selftest, release-note, and test-D64 documentation for SD-backed 1541 SAVE support, write diagnostics, LEDs, and remaining limitations.
2026-07-06 Add USB keyboard bring-up for Tang Primer 20K (bit-bang + OTG/ULPI PoC)
    Three standalone projects for getting a USB keyboard onto the board:
    - usb_kbd native nand2mario bit-bang HID core (low/full speed) on a PMOD
    USB breakout. The realistic path to a working keyboard.
    - usb_otg ULPI PHY diagnostic: reads the on-board USB3317 ID over the OTG
    port's ULPI bus (confirmed VID/PID 0424/0006).
    - usb_kbd_otg full USB host over ULPI on the OTG port. PROOF OF CONCEPT, not
    working end-to-end: the host transmit path is correct (a full
    SETUP token + DATA0 goes out, transaction reaches a clean response
    timeout) but no keyboard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
    [gowin_rpll_usb.v, uart_tx_ser.vhd, ulpi_rec.vhd, ulpi_vbus_init.vhd, usb_host_seq.vhd, usb_kbd_otg_top.vhd]
2026-07-06 Reorganize Tang Primer 20K board project files
2026-07-06 Split sw/ and roms/ into 6502 and c64 subtrees
    Separate the software by target machine: sw/{6502,c64} and roms/{6502,c64/{prg,sid,diag,upload}}. The copyrighted C64 system ROMs stay at roms/c64/ root (embedded via c64_roms.vhd). Rewire the Makefile, build_*.py, upload .bat files and docs to the new paths; add index READMEs; update .gitignore for the moved build artefacts.
    Convention: c64_*/c64diag = C64, everything else = 6502. The 6502 DDR3 framebuffer work and fat32_reader changes are deliberately left uncommitted.
    [adventure.cfg, c64_ich_image.cfg, c64_mandelbrot_copro.cfg, c64_sd_fat16_select.cfg, c64_sd_hook.cfg, c64_v1541_hook.cfg, c64_v1541_loadfirst.cfg, c64_vic_graphics_test.cfg]
2026-07-06 Add DDR3 320x200 8bpp framebuffer + magic-byte UART monitor
    Move the VIC bitmap framebuffer from BSRAM into DDR3 so the Gowin DDR3 IP's FIFOs get the BSRAM they need (fixes a 113k-DFF synth overflow). New $9000 bit 4 selects a 320x200 256-colour RGB332 frame reached through the banked $6000-$7FFF window (8x 8 KiB banks). vic_fb_ddr3 prefetches scanlines into a double line buffer and streams them to the VIC; CPU pixel writes are masked single-byte writes (no read-modify-write, so a marginal DDR3 read can't smear neighbouring pixels). Removing the BSRAM fb_ram retires the legacy 1bpp/color256/color64 bitmap modes; the Mandelbrot bitmap and coprocessor demos are ported to the 8bpp mode, plus te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
    [device.cfg, test_ddr3_fb.cfg]
2026-07-06 Add 640x400 hi-res and 320x200 RGB565 DDR3 framebuffer modes
    The single vic_fb_ddr3 controller now drives three 8bpp/16bpp geometries,
    selected by $9000 and banked through the $6000-$7FFF window:
    - $9000 bit 4: 320x200 8bpp RGB332 (existing), bank in $9000[7:5]
    - $9000 bit 5: 640x400 8bpp RGB332, shown 1:1; 256000 bytes = 32 banks,
    banked via the new $9006 register (18-bit pixel index)
    - $9000 bit 6: 320x200 16bpp RGB565 (65536 colours), 2 bytes/pixel, banked
    via $9006; the line buffer is 16 bits/pixel (8bpp modes use the low byte)
    The controller picks line width / count / bytes-per-pixel / frame base at
    runtime from the hires/bpp16 selects; the three frames live in separate DDR3
    regio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
    [test_ddr3_hires.cfg, test_ddr3_true.cfg]
2026-07-06 Fix Tang SBC timing closure
    [tang20k_sbc_top.vhd, vic_fb_ddr3.vhd]
2026-07-06 Add 80-column BASIC display mode
    [text80_on.cfg]
2026-07-08 Load PRG BASIC stubs correctly over UART
2026-07-08 upload: UART launchers for the blitter diagnostics and the cube demo
    blitcmp / blitprobe / blittest / blitmove exercise the hardware blitter in
    increasing depth (single fill, CPU-vs-blitter DDR3 write probe, sequential
    fill+line ops, busy-polled moving-object animation); cube launches the
    blitter-accelerated rotating cube. PRGs are built in the emulator repo
    (examples/blit*.s, examples/cube.s) and started via the monitor hex loader.
2026-07-09 fb_ddr3: fix display fetch starvation, add blit write combining + turnaround guard
    Fetch starvation (the wireframe artifact): the S_SELECT arbiter stage only
    refreshes its registered fetch-need flags in S_IDLE. With nothing pending the
    FSM sat in S_SELECT on STALE flags until the 16384-cycle watchdog (~5 scan
    lines), so the display repeated stale lines -- shallow wireframe edges broke
    into stacked dash clusters while steep edges (one pixel per line) looked
    almost clean, and flat images masked the bug entirely. S_SELECT now bounces
    back to S_IDLE by default (dispatch branches override), refreshing the flags
    every other cycle. New tb_vic_fb_ddr3_fetch proves it: worst fetch latency
    16065 -> 8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
    [tb_vic_fb_ddr3_blit.vhd, tb_vic_fb_ddr3_fetch.vhd, vic_fb_ddr3.vhd]
2026-07-09 Stabilize DDR3 framebuffer graphics build
    - add CPU write-combine buffering for DDR3 framebuffer writes
    - disable SD2 and audio in the Tang graphics test build for placement margin
    - add Mandelbrot hi-res zoom demo and upload helper
    - document blitter/framebuffer status and resource/timing results
    [sbc_t65_boot_monitor_top.vhd, tang20k_sbc_top.vhd, tb_vic_fb_ddr3_cpu_write.vhd, vic_fb_ddr3.vhd]
2026-07-09 upload: launchers for the space demo and the blitchk write/readback diagnostic
    space runs the blitter fly-through animation; blitchk stresses the DDR3
    framebuffer write path and reports errors graphically -- run it after any
    DDR-facing synthesis as a regression check (clean = only the eight grey
    bit boxes).
2026-07-09 gitignore: ignore stray Gowin synthesis output at the repo root
    /impl/ appears when the Gowin tool runs from the repo root; the real
    implementation results live under boards/*/project/impl/.
2026-07-09 tang_mega_138k: Tang Console 138K SBC port, dual FB backends, blitter copy
    New board port (GW5AST-138 on the Tang Console): SD boot, 50 MHz core,
    640x480 HDMI, and BOTH framebuffer backends in one bitstream -- the
    external SDRAM0 controller (default) and the on-board DDR3 -- runtime-
    selectable via $884C bit 0 (read: bit7 = DDR3 calibrated, bit6 = active).
    Boot waits only for the SDRAM0 side; the DDR3 IP calibrates in the
    background with an auto-retry sequencer, so a failed calibration can
    never park the CPU.
    Bring-up fixes that made the board work:
    - TF-slot SPI chip select on the real DAT3 ball W15 (the provisional GPIO
    made SPI-mode init impossible -> no SD boot, black screen); SDRAM0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
    [device.cfg]
2026-07-09 Improve Tang 138K HDMI and DDR timing
    [device.cfg]
2026-07-09 blitter: OP_TEX affine texture mapping + UV clip, mandelcube demo
    OP_TEX (op 4) fills the destination rectangle with an affine-mapped 64x64
    texture read through the blitter's byte read channel: U/V are signed 8.8
    stepped by DUDX/DVDX per pixel and DUDY/DVDY per row, texel address =
    base + v*64 + u. Parameters live in an extended bank written through
    $884A (index, auto-increment) / $884B (data): base(3), U0, V0, and the
    four gradients (2 bytes each), FLAGS(15). $884B therefore no longer
    reaches the GAP register (pacing stays at its default 12).
    FLAGS bit 1 = UV CLIP: pixels whose U or V falls outside [0, 64.0) are
    skipped entirely instead of wrapping (registered tex_skip, so fbi_re
    never gli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
    [device.cfg, mandelcube.cfg]
2026-07-10 tang138k: System16 68000 SoC port, SDRAM phase tester, vendored 68k cores
    - boards/tang_mega_138k/system16: 68000 SoC for the Tang Console 138K with
    boot ROM/monitor, UART, HDMI 720p video, SDRAM bridge and FAT32 finder,
    plus sw/ demos, SD image tooling and Makefile targets
    - third_party/fx68k and third_party/TG68K.C vendored as plain sources; the
    fx68k ALU carries the default-case additions the Gowin synthesis needs
    - boards/tang_mega_138k/ramtest: standalone SDRAM clock-phase sweep tester
    (dynamic PLL phase stepping, error map over UART)
    - sbc: boot_vga_debug screen is back so boot failures stay visible instead
    of a black HDMI picture
    [device.cfg]
2026-07-11 system16: document reproducible GoRV32 Linux image build
    [device.cfg]
2026-07-11 system16: add auto-calibrating GoRV32 SD profiles
2026-07-12 system16: prepare isolated AXI framebuffer path
    [device.cfg]
2026-07-12 system16: add DDR3 framebuffer Linux console
    Integrate the DDR3-backed HDMI framebuffer, USB HID input, shared UART/fbcon login, timing constraints, tests, documentation, and the v2026.07.12 release package.
2026-07-12 system16: hardware text console on HDMI, replacing the DDR3 framebuffer
    The RGB565 pixel framebuffer worked but fbcon scrolling was slow: a
    full-screen scroll is a 259 KB memmove through the uncached AXI window,
    and every access shares one DDR3 port. For a Linux console a hardware
    text mode is far faster -- the CPU writes two bytes per character and the
    FPGA renders glyphs from a font ROM.
    RTL:
    - sys16_text_core: 80x22 cells, 8x16 VGA font, scaled 2x to 1280x704 in
    720p. Char array (4x sys16_fb_ram8) and font ROM live in BSRAM, so no
    external memory is used. Hardware cursor + blink; a scroll START
    register is present but not yet driven.
    - sys16_font_pkg: 8x16 font generated from the k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
2026-07-12 feat(tang138k): add PS/2 Linux input and USB host experiment
    - replace System16 USB HID input with PS/2 Set-2 MMIO input
    - add GoRV32 Linux PS/2 driver, device-tree nodes, and stable 100 Hz configs
    - add standalone Gowin USB 2.0 host-controller smoke-test project
    - publish the hardware-verified PS/2 Linux release bundle
    [ps2_keyboard.vhd, sys16_gorv32plus_top.v, tang138k_usb_hid_top.v, usb20_phy_pll.v]
2026-07-13 system16: use full 1 GiB DDR3 for GoRV32 Linux
    Add the 256-bit DDR3 main-memory bridge with calibration retries and a destructive full-device startup test. Fix the bus request/ack retrigger race, mirror early UART output to HDMI, and publish 1020 MiB to all Linux profiles.
    Include refreshed SD/flash tooling and the s16bench utility. Hardware verified with DDR3 FULL TEST PASS 1GB, Linux MemTotal 1008 MiB, and a stable s16bench checksum.
    [sys16_bus32_to_ddr3.v, sys16_ddr_progress_reporter.vhd, sys16_gorv32plus_top.v, sys16_hdmi_text.vhd, sys16_text_core.vhd, sys16_uart_probe.vhd, tb_sys16_ddr3_main.v]
2026-07-13 system16: Linux-Konsole und SD-Diagnose stabilisieren
    - stellt die Textkonsole monitor-kompatibel als 80x25 in CEA-720p dar und pipelined den Pixelpfad fuer sauberes Timing
    - ergaenzt deutsche Tastaturbelegung, CP437-Umlaute und robuste lokale/UART-Konsolen
    - fuegt einen geschuetzten CMD24-Scratch-Selbsttest, Hash-Pruefung und Dokumentation fuer die Linux-Buildprofile hinzu
    - aktualisiert Simulation, Constraints und Build-Hilfen fuer den reproduzierbaren System16-Stand
2026-07-13 system16: USB-CDC-Entwicklungslink integrieren
    Fuegt ein eigenstaendiges Tang-138K-USB-CDC-Loopback-Projekt mit Gowin-IP, Constraints und Windows-Echotest hinzu. Integriert den hardwaregeprueften Full-Speed-CDC-Pfad ueber CDC-sichere 512-Byte-FIFOs als polling-basiertes MMIO-Geraet bei 0xe8800300 in das direkt per Gowin IDE baubare GoRV32-Plus-Projekt. Dokumentiert Register, Bring-up und PC/Linux-Test und ergaenzt die zugehoerigen Simulationen. Hardwaretest: 4096 Bytes fehlerfrei ueber COM16 sowie bidirektionaler MMIO-Datentransfer. third_party/NanoMig bleibt bewusst ausgeschlossen.
    [device.cfg]
2026-07-13 feat(tang138k): add AE350 hard-core bring-up projects
    - add a standalone AE350 project with SPI-XIP, UART2, JTAG and x16 DDR3
    - add a hardware-verified 64 KiB ITCM/DTCM UART bring-up image
    - gate CPU reset on PLL lock and emit an FPGA-side diagnostic banner
    - include generated IP, constraints and scripts for reproducible Gowin IDE builds
    - detach the local NanoMig checkout from the parent repository and ignore it
    - document ignored build products for the Amiga project
    [device.cfg]
